bcarbone24/freyja/kicad/odin.kicad_pcb

## KiCad design kicad/odin.kicad_pcb (2026-11-05)

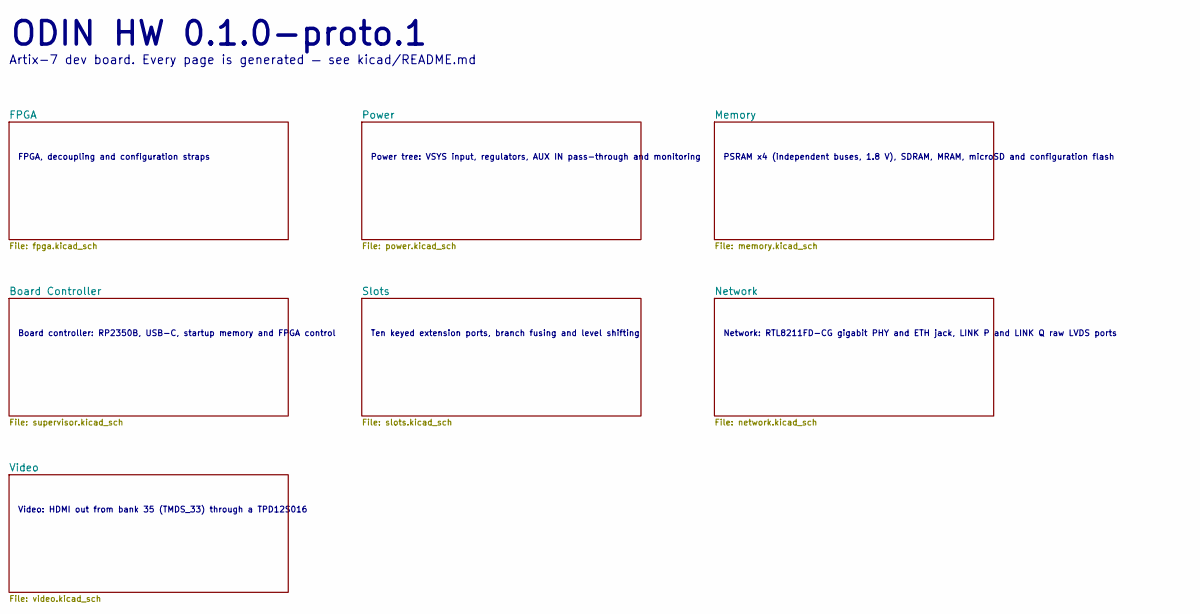
[picture p1: schematic odin.kicad_sch]

Notes on the sheet:
ODIN HW 0.1.0-proto.1
Artix-7 dev board. Every page is generated — see kicad/README.md
FPGA, decoupling and configuration straps
Power tree: VSYS input, regulators, AUX IN pass-through and monitoring
PSRAM x4 (independent buses, 1.8 V), SDRAM, MRAM, microSD and configuration flash
Board controller: RP2350B, USB-C, startup memory and FPGA control
Ten keyed extension ports, branch fusing and level shifting
Network: RTL8211FD-CG gigabit PHY and ETH jack, LINK P and LINK Q raw LVDS ports
Video: HDMI out from bank 35 (TMDS_33) through a TPD12S016

Schematic: fpga.kicad_sch

Parts:
C246, C328, C370, C371, C372, C373, C374, C375, C376, C377, C378, C379, C380, C381, C382, C383, C384, C385, C386, C387, C388, C389, C390, C391: 100nF; C_0402_1005Metric; LCSC C1525
C301: 330uF 2.5V T520V337M2R5ATE025; CP_EIA-7343-31_Kemet-D
C302, C303, C304, C305, C306, C307, C320, C321, C322, C330, C331, C336, C337, C342, C343, C348, C349, C354, C355, C360, C361: 4.7uF 6.3V; C_0805_2012Metric
C308, C309, C310, C311, C312, C313, C314, C315, C317, C318, C323, C324, C325, C326, C327, C332, C333, C334, C335, C338, C339, C340, C341, C344, C345, C346, C347, C350, C351, C352, C353, C356, C357, C358, C359, C362, C363, C364, C365: 0.47uF 6.3V; C_0603_1608Metric
C316: 100uF 2.5V; C_1210_3225Metric
C319, C329, C366, C367, C368, C369, C394: 47uF 6.3V; C_1210_3225Metric
C392, C393: 4.7uF; C_0603_1608Metric; LCSC C277476
D1: F.0603.00025/P2-0603G1TS2-06T-002; LED0603-RD_GREEN; LCSC C7496818
Q4: BSS138LT1G; SOT-23-3_L2.9-W1.6-P1.90-LS2.8-BR; LCSC C82045
R1, R2, R3, R6: 1k; R_0402_1005Metric; LCSC C11702
R4, R5, R98, R203: 4.7k; R_0402_1005Metric; LCSC C25900
R7: 330; R_0402_1005Metric
R35, R89: 100 1%; R_0603_1608Metric
R147: 33; R_0402_1005Metric; LCSC C25105
U1: XC7A100T-2FGG676I; FBGA-676_L27.0-W27.0-R26-C26-P1.00-BL; LCSC C1521803
X4: 50MHz CMOS; OSC-SMD_4P-L3.2-W2.5-BL; LCSC C717684

Connections:
+1V0: C301.1, C302.1, C303.1, C304.1, C305.1, C306.1, C307.1, C308.1, C309.1, C310.1, C311.1, C312.1, C313.1, C314.1, C315.1, C316.1, C317.1, C318.1, U1.J11 (VCCINT), U1.J13 (VCCINT), U1.K10 (VCCINT), U1.K12 (VCCINT), U1.L11 (VCCINT), U1.L13 (VCCINT), U1.M10 (VCCINT), U1.N13 (VCCBRAM), U1.P10 (VCCINT), U1.R13 (VCCBRAM), U1.T10 (VCCINT), U1.T12 (VCCINT), U1.U11 (VCCINT), U1.U13 (VCCBRAM), U1.V10 (VCCINT), U1.V12 (VCCINT), U1.W13 (VCCBRAM); also elsewhere on the board
+1V0_MGT: C370.1, C371.1, C372.1, C373.1, C374.1, C375.1, C376.1, C377.1, C378.1, C379.1, C392.1, U1.AA10 (MGTAVCC_G10), U1.AA12 (MGTAVCC_G10), U1.AC9 (MGTAVCC_G10), U1.AC11 (MGTAVCC_G10), U1.AC13 (MGTAVCC_G10), U1.D9 (MGTAVCC_G11), U1.D11 (MGTAVCC_G11), U1.D13 (MGTAVCC_G11), U1.F10 (MGTAVCC_G11), U1.F12 (MGTAVCC_G11); also elsewhere on the board
+1V2_MGT: C380.1, C381.1, C382.1, C383.1, C384.1, C385.1, C386.1, C387.1, C388.1, C389.1, C390.1, C391.1, C393.1, R35.2, R89.2, U1.AD7 (MGTAVTT_G10), U1.AD15 (MGTAVTT_G10), U1.AE8 (MGTAVTT_G10), U1.AE10 (MGTAVTT_G10), U1.AE12 (MGTAVTT_G10), U1.AE14 (MGTAVTT_G10), U1.B8 (MGTAVTT_G11), U1.B10 (MGTAVTT_G11), U1.B12 (MGTAVTT_G11), U1.B14 (MGTAVTT_G11), U1.C7 (MGTAVTT_G11), U1.C15 (MGTAVTT_G11); also elsewhere on the board
+1V8: C319.1, C320.1, C321.1, C322.1, C323.1, C324.1, C325.1, C326.1, C327.1, C328.1, U1.J9 (VCCAUX), U1.L9 (VCCAUX), U1.M12 (VCCADC_0), U1.N9 (VCCAUX), U1.R9 (VCCAUX), U1.U9 (VCCAUX); also elsewhere on the board
+1V8_IO: C330.1, C331.1, C332.1, C333.1, C334.1, C335.1, C394.1, U1.AC25 (VCCO_13), U1.T16 (VCCO_13), U1.T26 (VCCO_13), U1.U23 (VCCO_13), U1.V20 (VCCO_13), U1.Y24 (VCCO_13); also elsewhere on the board
+2V5: C348.1, C349.1, C350.1, C351.1, C352.1, C353.1, C368.1, U1.A21 (VCCO_16), U1.B18 (VCCO_16), U1.C25 (VCCO_16), U1.D22 (VCCO_16), U1.E19 (VCCO_16), U1.F16 (VCCO_16); also elsewhere on the board
+3V3: C246.1, C329.1, C336.1, C337.1, C338.1, C339.1, C340.1, C341.1, C360.1, C361.1, C362.1, C363.1, C364.1, C365.1, C366.1, R1.1, R4.1, R5.1, R6.1, R7.1, R98.1, R203.1, U1.A1 (VCCO_35), U1.AA1 (VCCO_33), U1.AA21 (VCCO_12), U1.AB15 (CFGBVS_0), U1.AB18 (VCCO_12), U1.AC5 (VCCO_33), U1.AD2 (VCCO_33), U1.AD22 (VCCO_12), U1.AE19 (VCCO_12), U1.AF26 (VCCO_12), U1.C5 (VCCO_35), U1.D2 (VCCO_35), U1.F6 (VCCO_35), U1.G3 (VCCO_35), U1.J7 (VCCO_35), U1.K24 (VCCO_14), U1.L21 (VCCO_14), U1.N15 (VCCO_14), U1.N25 (VCCO_14), U1.P22 (VCCO_14), U1.R19 (VCCO_14), U1.U3 (VCCO_33), U1.W7 (VCCO_33), U1.W11 (VCCO_0), U1.W17 (VCCO_12), U1.Y4 (VCCO_33), U1.Y14 (VCCO_0), X4.1 (Tri-state), X4.4 (VDD); also elsewhere on the board
BUS5V0_DIR: U1.U24 (IO_0_13); also elsewhere on the board
BUS5V0_IO0: U1.V26 (IO_L2P_T0_13); also elsewhere on the board
BUS5V0_IO1: U1.W26 (IO_L2N_T0_13); also elsewhere on the board
BUS5V0_IO2: U1.AB26 (IO_L3P_T0_DQS_13); also elsewhere on the board
BUS5V0_IO3: U1.AC26 (IO_L3N_T0_DQS_13); also elsewhere on the board
BUS5V0_IO4: U1.U25 (IO_L1P_T0_13); also elsewhere on the board
BUS5V0_IO5: U1.U26 (IO_L1N_T0_13); also elsewhere on the board
BUS5V0_IO6: U1.W25 (IO_L4P_T0_13); also elsewhere on the board
BUS5V0_IO7: U1.Y26 (IO_L4N_T0_13); also elsewhere on the board
BUS5V0_OE_N: U1.V23 (IO_L10P_T1_13); also elsewhere on the board
BUS5V1_DIR: U1.U17 (IO_25_13); also elsewhere on the board
BUS5V1_IO0: U1.Y25 (IO_L5P_T0_13); also elsewhere on the board
BUS5V1_IO1: U1.AA25 (IO_L5N_T0_13); also elsewhere on the board
BUS5V1_IO2: U1.V24 (IO_L6P_T0_13); also elsewhere on the board
BUS5V1_IO3: U1.W24 (IO_L6N_T0_VREF_13); also elsewhere on the board
BUS5V1_IO4: U1.AA24 (IO_L7P_T1_13); also elsewhere on the board
BUS5V1_IO5: U1.AB25 (IO_L7N_T1_13); also elsewhere on the board
BUS5V1_IO6: U1.AB24 (IO_L9P_T1_DQS_13); also elsewhere on the board
BUS5V1_IO7: U1.AC24 (IO_L9N_T1_DQS_13); also elsewhere on the board
BUS5V1_OE_N: U1.W23 (IO_L10N_T1_13); also elsewhere on the board
CFG_CCLK: U1.H13 (CCLK_0); also elsewhere on the board
CFG_DONE: Q4.1 (G), R98.2, U1.W10 (DONE_0); also elsewhere on the board
CFG_INIT_B: R5.2, U1.V11 (INIT_B_0); also elsewhere on the board
CFG_M0: R1.2, U1.AB7 (M0_0)
CFG_M1: R2.1, U1.Y9 (M1_0)
CFG_M2: R3.1, U1.W9 (M2_0)
CFG_PROG_B: R4.2, U1.AE16 (PROGRAM_B_0); also elsewhere on the board
DBG_TCK: U1.N21 (IO_L13P_T2_MRCC_14); also elsewhere on the board
DBG_TDI: U1.M20 (IO_L8P_T1_D11_14); also elsewhere on the board
DBG_TDO: U1.L20 (IO_L8N_T1_D12_14); also elsewhere on the board
DBG_TMS: U1.N22 (IO_L13N_T2_MRCC_14); also elsewhere on the board
DONE_LED_A: D1.2 (A), R7.2
DONE_LED_K: D1.1 (C), Q4.3 (D)
FLASH_CS_B: R203.2, U1.P18 (IO_L6P_T0_FCS_B_14); also elsewhere on the board
FLASH_D0_MOSI: U1.R14 (IO_L1P_T0_D00_MOSI_14); also elsewhere on the board
FLASH_D1_MISO: U1.R15 (IO_L1N_T0_D01_DIN_14); also elsewhere on the board
FLASH_D2_WP: U1.P14 (IO_L2P_T0_D02_14); also elsewhere on the board
FLASH_D3_HOLD: U1.N14 (IO_L2N_T0_D03_14); also elsewhere on the board
FPGA_DXN: U1.R11 (DXN_0)
FPGA_DXP: U1.R12 (DXP_0)
GND: C246.2, C301.2, C302.2, C303.2, C304.2, C305.2, C306.2, C307.2, C308.2, C309.2, C310.2, C311.2, C312.2, C313.2, C314.2, C315.2, C316.2, C317.2, C318.2, C319.2, C320.2, C321.2, C322.2, C323.2, C324.2, C325.2, C326.2, C327.2, C328.2, C329.2, C330.2, C331.2, C332.2, C333.2, C334.2, C335.2, C336.2, C337.2, C338.2, C339.2, C340.2, C341.2, C342.2, C343.2, C344.2, C345.2, C346.2, C347.2, C348.2, C349.2, C350.2, C351.2, C352.2, C353.2, C354.2, C355.2, C356.2, C357.2, C358.2, C359.2, C360.2, C361.2, C362.2, C363.2, C364.2, C365.2, C366.2, C367.2, C368.2, C369.2, C370.2, C371.2, C372.2, C373.2, C374.2, C375.2, C376.2, C377.2, C378.2, C379.2, C380.2, C381.2, C382.2, C383.2, C384.2, C385.2, C386.2, C387.2, C388.2, C389.2, C390.2, C391.2, C392.2, C393.2, C394.2, Q4.2 (S), R2.2, R3.2, U1.A6 (GND), U1.A8 (GND), U1.A10 (GND), U1.A11 (MGTPRXN0_216), U1.A12 (GND), U1.A13 (MGTPRXN2_216), U1.A14 (GND), U1.A16 (GND), U1.A26 (GND), U1.AA6 (GND), U1.AA9 (GND), U1.AA14 (GND), U1.AA16 (GND), U1.AA26 (GND), U1.AB3 (GND), U1.AB8 (GND), U1.AB9 (GND), U1.AB10 (GND), U1.AB12 (GND), U1.AB14 (GND), U1.AB23 (GND), U1.AC7 (GND), U1.AC12 (MGTPRXP0_213), U1.AC14 (MGTPRXP2_213), U1.AC15 (GND), U1.AC20 (GND), U1.AD6 (GND), U1.AD9 (GND), U1.AD11 (GND), U1.AD12 (MGTPRXN0_213), U1.AD13 (GND), U1.AD14 (MGTPRXN2_213), U1.AD16 (GND), U1.AE4 (GND), U1.AE6 (GND), U1.AE11 (MGTPRXP3_213), U1.AE13 (MGTPRXP1_213), U1.AE15 (GND), U1.AE24 (GND), U1.AF1 (GND), U1.AF6 (GND), U1.AF8 (GND), U1.AF10 (GND), U1.AF11 (MGTPRXN3_213), U1.AF12 (GND), U1.AF13 (MGTPRXN1_213), U1.AF14 (GND), U1.AF16 (GND), U1.AF21 (GND), U1.B3 (GND), U1.B6 (GND), U1.B11 (MGTPRXP0_216), U1.B13 (MGTPRXP2_216), U1.B15 (GND), U1.B16 (GND), U1.B23 (GND), U1.C6 (GND), U1.C9 (GND), U1.C11 (GND), U1.C12 (MGTPRXN3_216), U1.C13 (GND), U1.C14 (MGTPRXN1_216), U1.C16 (GND), U1.C20 (GND), U1.D7 (GND), U1.D12 (MGTPRXP3_216), U1.D14 (MGTPRXP1_216), U1.D15 (GND), U1.D17 (GND), U1.E4 (GND), U1.E7 (GND), U1.E8 (GND), U1.E9 (GND), U1.E10 (GND), U1.E12 (GND), U1.E14 (GND), U1.E15 (GND), U1.E24 (GND), U1.F1 (GND), U1.F9 (GND), U1.F14 (GND), U1.F21 (GND), U1.G10 (GND), U1.G11 (GND), U1.G12 (GND), U1.G13 (GND), U1.G14 (VCCBATT_0), U1.G18 (GND), U1.H5 (GND), U1.H25 (GND), U1.J2 (GND), U1.J12 (GND), U1.J22 (GND), U1.K9 (GND), U1.K11 (GND), U1.K13 (GND), U1.K19 (GND), U1.L6 (GND), U1.L10 (GND), U1.L12 (GND), U1.L16 (GND), U1.L26 (GND), U1.M3 (GND), U1.M9 (GND), U1.M11 (GNDADC_0), U1.M13 (GND), U1.M23 (GND), U1.N10 (GND), U1.N11 (VREFN_0), U1.N12 (VP_0), U1.N20 (GND), U1.P7 (GND), U1.P9 (GND), U1.P11 (VN_0), U1.P12 (VREFP_0), U1.P13 (GND), U1.P17 (GND), U1.R4 (GND), U1.R10 (GND), U1.R24 (GND), U1.T1 (GND), U1.T9 (GND), U1.T11 (GND), U1.T13 (GND), U1.T21 (GND), U1.U8 (GND), U1.U10 (GND), U1.U12 (GND), U1.U18 (GND), U1.V5 (GND), U1.V13 (GND), U1.V15 (GND), U1.V25 (GND), U1.W2 (GND), U1.W12 (GND), U1.W22 (GND), U1.Y10 (GND), U1.Y11 (GND), U1.Y12 (GND), U1.Y13 (GND), U1.Y19 (GND), X4.2 (GND); also elsewhere on the board
HDMI_CEC: U1.B2 (IO_L19N_T3_VREF_35); also elsewhere on the board
HDMI_CLK_N: U1.A2 (IO_L20N_T3_35); also elsewhere on the board
HDMI_CLK_P: U1.A3 (IO_L20P_T3_35); also elsewhere on the board
HDMI_CT_HPD: U1.F2 (IO_L22P_T3_35); also elsewhere on the board
HDMI_D0_N: U1.B1 (IO_L21N_T3_DQS_35); also elsewhere on the board
HDMI_D0_P: U1.C1 (IO_L21P_T3_DQS_35); also elsewhere on the board
HDMI_D1_N: U1.D1 (IO_L23N_T3_35); also elsewhere on the board
HDMI_D1_P: U1.E1 (IO_L23P_T3_35); also elsewhere on the board
HDMI_D2_N: U1.A5 (IO_L15N_T2_DQS_35); also elsewhere on the board
HDMI_D2_P: U1.B5 (IO_L15P_T2_DQS_35); also elsewhere on the board
HDMI_HPD: U1.B4 (IO_L16P_T2_35); also elsewhere on the board
HDMI_LS_OE: U1.E2 (IO_L22N_T3_35); also elsewhere on the board
HDMI_SCL: U1.A4 (IO_L16N_T2_35); also elsewhere on the board
HDMI_SDA: U1.C2 (IO_L19P_T3_35); also elsewhere on the board
JTAG_TCK: U1.H12 (TCK_0); also elsewhere on the board
JTAG_TDI: U1.H10 (TDI_0); also elsewhere on the board
JTAG_TDO: U1.J10 (TDO_0); also elsewhere on the board
JTAG_TMS: U1.H11 (TMS_0); also elsewhere on the board
LINK_P_RXC_N: U1.C18 (IO_L12N_T1_MRCC_16); also elsewhere on the board
LINK_P_RXC_P: U1.D18 (IO_L12P_T1_MRCC_16); also elsewhere on the board
LINK_P_RXD_N: U1.A18 (IO_L9N_T1_DQS_16); also elsewhere on the board
LINK_P_RXD_P: U1.A17 (IO_L9P_T1_DQS_16); also elsewhere on the board
LINK_P_TXC_N: U1.B26 (IO_L22N_T3_16); also elsewhere on the board
LINK_P_TXC_P: U1.C26 (IO_L22P_T3_16); also elsewhere on the board
LINK_P_TXD_N: U1.A24 (IO_L21N_T3_DQS_16); also elsewhere on the board
LINK_P_TXD_P: U1.A23 (IO_L21P_T3_DQS_16); also elsewhere on the board
LINK_Q_RXC_N: U1.D20 (IO_L14N_T2_SRCC_16); also elsewhere on the board
LINK_Q_RXC_P: U1.E20 (IO_L14P_T2_SRCC_16); also elsewhere on the board
LINK_Q_RXD_N: U1.A20 (IO_L15N_T2_DQS_16); also elsewhere on the board
LINK_Q_RXD_P: U1.B20 (IO_L15P_T2_DQS_16); also elsewhere on the board
LINK_Q_TXC_N: U1.A25 (IO_L20N_T3_16); also elsewhere on the board
LINK_Q_TXC_P: U1.B25 (IO_L20P_T3_16); also elsewhere on the board
LINK_Q_TXD_N: U1.A22 (IO_L17N_T2_16); also elsewhere on the board
LINK_Q_TXD_P: U1.B22 (IO_L17P_T2_16); also elsewhere on the board
MGTRREF: R35.1, U1.A15 (MGTRREF_216)
MGTRREF_213: R89.1, U1.AF15 (MGTRREF_213)
MRAM_CS: U1.K25 (IO_L7P_T1_D09_14); also elsewhere on the board
MRAM_SCK: U1.K26 (IO_L7N_T1_D10_14); also elsewhere on the board
MRAM_SI: U1.L24 (IO_L9P_T1_DQS_14); also elsewhere on the board
MRAM_SO: U1.L25 (IO_L9N_T1_DQS_D13_14); also elsewhere on the board
PHY_INT_N: U1.G2 (IO_L24P_T3_35); also elsewhere on the board
PHY_MDC: U1.C17 (IO_L7P_T1_16); also elsewhere on the board
PHY_MDIO: U1.B17 (IO_L7N_T1_16); also elsewhere on the board
PHY_RESET_N: U1.G1 (IO_L24N_T3_35); also elsewhere on the board
PHY_RXC: U1.D19 (IO_L13P_T2_MRCC_16); also elsewhere on the board
PHY_RXD0: U1.C19 (IO_L13N_T2_MRCC_16); also elsewhere on the board
PHY_RXD1: U1.H17 (IO_0_16); also elsewhere on the board
PHY_RXD2: U1.E22 (IO_25_16); also elsewhere on the board
PHY_RXD3: U1.B19 (IO_L10P_T1_16); also elsewhere on the board
PHY_RX_CTL: U1.A19 (IO_L10N_T1_16); also elsewhere on the board
PHY_TXC: U1.C24 (IO_L23P_T3_16); also elsewhere on the board
PHY_TXD0: U1.B24 (IO_L23N_T3_16); also elsewhere on the board
PHY_TXD1: U1.C22 (IO_L19P_T3_16); also elsewhere on the board
PHY_TXD2: U1.C23 (IO_L19N_T3_VREF_16); also elsewhere on the board
PHY_TXD3: U1.C21 (IO_L16P_T2_16); also elsewhere on the board
PHY_TX_CTL: U1.B21 (IO_L16N_T2_16); also elsewhere on the board
PSRAM0_CE_B: U1.T15 (IO_L20N_T3_13); also elsewhere on the board
PSRAM0_IO0: U1.T17 (IO_L21P_T3_DQS_13); also elsewhere on the board
PSRAM0_IO1: U1.T18 (IO_L21N_T3_DQS_13); also elsewhere on the board
PSRAM0_IO2: U1.U15 (IO_L22P_T3_13); also elsewhere on the board
PSRAM0_IO3: U1.U16 (IO_L22N_T3_13); also elsewhere on the board
PSRAM0_SCK: U1.T14 (IO_L20P_T3_13); also elsewhere on the board
PSRAM1_CE_B: U1.V14 (IO_L23N_T3_13); also elsewhere on the board
PSRAM1_IO0: U1.V16 (IO_L24P_T3_13); also elsewhere on the board
PSRAM1_IO1: U1.V17 (IO_L24N_T3_13); also elsewhere on the board
PSRAM1_IO2: U1.V18 (IO_L19P_T3_13); also elsewhere on the board
PSRAM1_IO3: U1.W18 (IO_L19N_T3_VREF_13); also elsewhere on the board
PSRAM1_SCK: U1.U14 (IO_L23P_T3_13); also elsewhere on the board
PSRAM2_CE_B: U1.U19 (IO_L17N_T2_13); also elsewhere on the board
PSRAM2_IO0: U1.V19 (IO_L18P_T2_13); also elsewhere on the board
PSRAM2_IO1: U1.W19 (IO_L18N_T2_13); also elsewhere on the board
PSRAM2_IO2: U1.T20 (IO_L15P_T2_DQS_13); also elsewhere on the board
PSRAM2_IO3: U1.U20 (IO_L15N_T2_DQS_13); also elsewhere on the board
PSRAM2_SCK: U1.T19 (IO_L17P_T2_13); also elsewhere on the board
PSRAM3_CE_B: U1.Y20 (IO_L16N_T2_13); also elsewhere on the board
PSRAM3_IO0: U1.W21 (IO_L14P_T2_SRCC_13); also elsewhere on the board
PSRAM3_IO1: U1.Y21 (IO_L14N_T2_SRCC_13); also elsewhere on the board
PSRAM3_IO2: U1.Y22 (IO_L11P_T1_SRCC_13); also elsewhere on the board
PSRAM3_IO3: U1.Y23 (IO_L11N_T1_SRCC_13); also elsewhere on the board
PSRAM3_SCK: U1.W20 (IO_L16P_T2_13); also elsewhere on the board
PUDC_B: R6.2, U1.P15 (IO_L3P_T0_DQS_PUDC_B_14)
SB_UART_RX: U1.P20 (IO_L14P_T2_SRCC_14); also elsewhere on the board
SB_UART_TX: U1.P21 (IO_L14N_T2_SRCC_14); also elsewhere on the board
SDRAM_A0: U1.M26 (IO_L20N_T3_A07_D23_14); also elsewhere on the board
SDRAM_A1: U1.N26 (IO_L20P_T3_A08_D24_14); also elsewhere on the board
SDRAM_A2: U1.P26 (IO_L22N_T3_A04_D20_14); also elsewhere on the board
SDRAM_A3: U1.R26 (IO_L22P_T3_A05_D21_14); also elsewhere on the board
SDRAM_A4: U1.M25 (IO_L10N_T1_D15_14); also elsewhere on the board
SDRAM_A5: U1.P25 (IO_L19N_T3_A09_D25_VREF_14); also elsewhere on the board
SDRAM_A6: U1.R25 (IO_L19P_T3_A10_D26_14); also elsewhere on the board
SDRAM_A7: U1.T25 (IO_L21N_T3_DQS_A06_D22_14); also elsewhere on the board
SDRAM_A8: U1.M24 (IO_L10P_T1_D14_14); also elsewhere on the board
SDRAM_A9: U1.N24 (IO_L15N_T2_DQS_DOUT_CSO_B_14); also elsewhere on the board
SDRAM_A10: U1.P24 (IO_L17N_T2_A13_D29_14); also elsewhere on the board
SDRAM_A11: U1.T24 (IO_L21P_T3_DQS_14); also elsewhere on the board
SDRAM_A12: U1.N23 (IO_L15P_T2_DQS_RDWR_B_14); also elsewhere on the board
SDRAM_BA0: U1.P23 (IO_L17P_T2_A14_D30_14); also elsewhere on the board
SDRAM_BA1: U1.R23 (IO_L24N_T3_A00_D16_14); also elsewhere on the board
SDRAM_CAS_N: U1.F3 (IO_L18P_T2_35); also elsewhere on the board
SDRAM_CKE: U1.K6 (IO_L10N_T1_AD15N_35); also elsewhere on the board
SDRAM_CLK: U1.K7 (IO_L10P_T1_AD15P_35); also elsewhere on the board
SDRAM_CS_N: U1.D3 (IO_L17P_T2_35); also elsewhere on the board
SDRAM_DQ0: U1.E6 (IO_L1P_T0_AD4P_35); also elsewhere on the board
SDRAM_DQ1: U1.D6 (IO_L1N_T0_AD4N_35); also elsewhere on the board
SDRAM_DQ2: U1.H8 (IO_L2P_T0_AD12P_35); also elsewhere on the board
SDRAM_DQ3: U1.G8 (IO_L2N_T0_AD12N_35); also elsewhere on the board
SDRAM_DQ4: U1.H7 (IO_L3P_T0_DQS_AD5P_35); also elsewhere on the board
SDRAM_DQ5: U1.G7 (IO_L3N_T0_DQS_AD5N_35); also elsewhere on the board
SDRAM_DQ6: U1.F8 (IO_L4P_T0_35); also elsewhere on the board
SDRAM_DQ7: U1.F7 (IO_L4N_T0_35); also elsewhere on the board
SDRAM_DQ8: U1.H6 (IO_L5P_T0_AD13P_35); also elsewhere on the board
SDRAM_DQ9: U1.G6 (IO_L5N_T0_AD13N_35); also elsewhere on the board
SDRAM_DQ10: U1.H9 (IO_L6P_T0_35); also elsewhere on the board
SDRAM_DQ11: U1.G9 (IO_L6N_T0_VREF_35); also elsewhere on the board
SDRAM_DQ12: U1.J6 (IO_L7P_T1_AD6P_35); also elsewhere on the board
SDRAM_DQ13: U1.J5 (IO_L7N_T1_AD6N_35); also elsewhere on the board
SDRAM_DQ14: U1.L8 (IO_L8P_T1_AD14P_35); also elsewhere on the board
SDRAM_DQ15: U1.K8 (IO_L8N_T1_AD14N_35); also elsewhere on the board
SDRAM_LDQM: U1.J4 (IO_L9P_T1_DQS_AD7P_35); also elsewhere on the board
SDRAM_RAS_N: U1.C3 (IO_L17N_T2_35); also elsewhere on the board
SDRAM_UDQM: U1.H4 (IO_L9N_T1_DQS_AD7N_35); also elsewhere on the board
SDRAM_WE_N: U1.E3 (IO_L18N_T2_35); also elsewhere on the board
SD_CD: U1.T23 (IO_L24P_T3_A01_D17_14); also elsewhere on the board
SD_CS: U1.L22 (IO_L11P_T1_SRCC_14); also elsewhere on the board
SD_MISO: U1.R22 (IO_L23N_T3_A02_D18_14); also elsewhere on the board
SD_MOSI: U1.T22 (IO_L23P_T3_A03_D19_14); also elsewhere on the board
SD_SCK: U1.L23 (IO_L11N_T1_SRCC_14); also elsewhere on the board
SLOTA_IO0: U1.K15 (IO_L1P_T0_AD0P_15); also elsewhere on the board
SLOTA_IO1: U1.J16 (IO_L1N_T0_AD0N_15); also elsewhere on the board
SLOTA_IO2: U1.J14 (IO_L2P_T0_AD8P_15); also elsewhere on the board
SLOTA_IO3: U1.J15 (IO_L2N_T0_AD8N_15); also elsewhere on the board
SLOTA_IO4: U1.K16 (IO_L3P_T0_DQS_AD1P_15); also elsewhere on the board
SLOTA_IO5: U1.K17 (IO_L3N_T0_DQS_AD1N_15); also elsewhere on the board
SLOTA_IO6: U1.M14 (IO_L4P_T0_15); also elsewhere on the board
SLOTA_IO7: U1.L14 (IO_L4N_T0_15); also elsewhere on the board
SLOTA_IO8: U1.M15 (IO_L5P_T0_AD9P_15); also elsewhere on the board
SLOTA_IO9: U1.L15 (IO_L5N_T0_AD9N_15); also elsewhere on the board
SLOTA_IO10: U1.M16 (IO_L6P_T0_15); also elsewhere on the board
SLOTA_IO11: U1.M17 (IO_L6N_T0_VREF_15); also elsewhere on the board
SLOTB_IO0: U1.J19 (IO_L7P_T1_AD2P_15); also elsewhere on the board
SLOTB_IO1: U1.H19 (IO_L7N_T1_AD2N_15); also elsewhere on the board
SLOTB_IO2: U1.L17 (IO_L8P_T1_AD10P_15); also elsewhere on the board
SLOTB_IO3: U1.L18 (IO_L8N_T1_AD10N_15); also elsewhere on the board
SLOTB_IO4: U1.K20 (IO_L9P_T1_DQS_AD3P_15); also elsewhere on the board
SLOTB_IO5: U1.J20 (IO_L9N_T1_DQS_AD3N_15); also elsewhere on the board
SLOTB_IO6: U1.J18 (IO_L10P_T1_AD11P_15); also elsewhere on the board
SLOTB_IO7: U1.H18 (IO_L10N_T1_AD11N_15); also elsewhere on the board
SLOTB_IO8: U1.G20 (IO_L11P_T1_SRCC_15); also elsewhere on the board
SLOTB_IO9: U1.G21 (IO_L11N_T1_SRCC_15); also elsewhere on the board
SLOTB_IO10: U1.K21 (IO_L12P_T1_MRCC_15); also elsewhere on the board
SLOTB_IO11: U1.J21 (IO_L12N_T1_MRCC_15); also elsewhere on the board
SLOTC_IO0: U1.H21 (IO_L13P_T2_MRCC_15); also elsewhere on the board
SLOTC_IO1: U1.H22 (IO_L13N_T2_MRCC_15); also elsewhere on the board
SLOTC_IO2: U1.J23 (IO_L14P_T2_SRCC_15); also elsewhere on the board
SLOTC_IO3: U1.H23 (IO_L14N_T2_SRCC_15); also elsewhere on the board
SLOTC_IO4: U1.G22 (IO_L15P_T2_DQS_15); also elsewhere on the board
SLOTC_IO5: U1.F22 (IO_L15N_T2_DQS_ADV_B_15); also elsewhere on the board
SLOTC_IO6: U1.J24 (IO_L16P_T2_A28_15); also elsewhere on the board
SLOTC_IO7: U1.H24 (IO_L16N_T2_A27_15); also elsewhere on the board
SLOTC_IO8: U1.F23 (IO_L17P_T2_A26_15); also elsewhere on the board
SLOTC_IO9: U1.E23 (IO_L17N_T2_A25_15); also elsewhere on the board
SLOTC_IO10: U1.K22 (IO_L18P_T2_A24_15); also elsewhere on the board
SLOTC_IO11: U1.K23 (IO_L18N_T2_A23_15); also elsewhere on the board
SLOTD_IO0: U1.G24 (IO_L19P_T3_A22_15); also elsewhere on the board
SLOTD_IO1: U1.F24 (IO_L19N_T3_A21_VREF_15); also elsewhere on the board
SLOTD_IO2: U1.E25 (IO_L20P_T3_A20_15); also elsewhere on the board
SLOTD_IO3: U1.D25 (IO_L20N_T3_A19_15); also elsewhere on the board
SLOTD_IO4: U1.E26 (IO_L21P_T3_DQS_15); also elsewhere on the board
SLOTD_IO5: U1.D26 (IO_L21N_T3_DQS_A18_15); also elsewhere on the board
SLOTD_IO6: U1.H26 (IO_L22P_T3_A17_15); also elsewhere on the board
SLOTD_IO7: U1.G26 (IO_L22N_T3_A16_15); also elsewhere on the board
SLOTD_IO8: U1.G25 (IO_L23P_T3_FOE_B_15); also elsewhere on the board
SLOTD_IO9: U1.F25 (IO_L23N_T3_FWE_B_15); also elsewhere on the board
SLOTD_IO10: U1.J25 (IO_L24P_T3_RS1_15); also elsewhere on the board
SLOTD_IO11: U1.J26 (IO_L24N_T3_RS0_15); also elsewhere on the board
SLOTE_IO0: U1.K3 (IO_L1P_T0_34); also elsewhere on the board
SLOTE_IO1: U1.J3 (IO_L1N_T0_34); also elsewhere on the board
SLOTE_IO2: U1.M7 (IO_L2P_T0_34); also elsewhere on the board
SLOTE_IO3: U1.L7 (IO_L2N_T0_34); also elsewhere on the board
SLOTE_IO4: U1.M4 (IO_L3P_T0_DQS_34); also elsewhere on the board
SLOTE_IO5: U1.L4 (IO_L3N_T0_DQS_34); also elsewhere on the board
SLOTE_IO6: U1.L5 (IO_L4P_T0_34); also elsewhere on the board
SLOTE_IO7: U1.K5 (IO_L4N_T0_34); also elsewhere on the board
SLOTE_IO8: U1.N7 (IO_L5P_T0_34); also elsewhere on the board
SLOTE_IO9: U1.N6 (IO_L5N_T0_34); also elsewhere on the board
SLOTE_IO10: U1.M6 (IO_L6P_T0_34); also elsewhere on the board
SLOTE_IO11: U1.M5 (IO_L6N_T0_VREF_34); also elsewhere on the board
SLOTF_IO0: U1.K1 (IO_L7P_T1_34); also elsewhere on the board
SLOTF_IO1: U1.J1 (IO_L7N_T1_34); also elsewhere on the board
SLOTF_IO2: U1.L3 (IO_L8P_T1_34); also elsewhere on the board
SLOTF_IO3: U1.K2 (IO_L8N_T1_34); also elsewhere on the board
SLOTF_IO4: U1.N1 (IO_L9P_T1_DQS_34); also elsewhere on the board
SLOTF_IO5: U1.M1 (IO_L9N_T1_DQS_34); also elsewhere on the board
SLOTF_IO6: U1.H2 (IO_L10P_T1_34); also elsewhere on the board
SLOTF_IO7: U1.H1 (IO_L10N_T1_34); also elsewhere on the board
SLOTF_IO8: U1.M2 (IO_L11P_T1_SRCC_34); also elsewhere on the board
SLOTF_IO9: U1.L2 (IO_L11N_T1_SRCC_34); also elsewhere on the board
SLOTF_IO10: U1.N3 (IO_L12P_T1_MRCC_34); also elsewhere on the board
SLOTF_IO11: U1.N2 (IO_L12N_T1_MRCC_34); also elsewhere on the board
SLOTG_IO0: U1.R3 (IO_L13P_T2_MRCC_34); also elsewhere on the board
SLOTG_IO1: U1.P3 (IO_L13N_T2_MRCC_34); also elsewhere on the board
SLOTG_IO2: U1.P4 (IO_L14P_T2_SRCC_34); also elsewhere on the board
SLOTG_IO3: U1.N4 (IO_L14N_T2_SRCC_34); also elsewhere on the board
SLOTG_IO4: U1.R1 (IO_L15P_T2_DQS_34); also elsewhere on the board
SLOTG_IO5: U1.P1 (IO_L15N_T2_DQS_34); also elsewhere on the board
SLOTG_IO6: U1.T4 (IO_L16P_T2_34); also elsewhere on the board
SLOTG_IO7: U1.T3 (IO_L16N_T2_34); also elsewhere on the board
SLOTG_IO8: U1.T2 (IO_L17P_T2_34); also elsewhere on the board
SLOTG_IO9: U1.R2 (IO_L17N_T2_34); also elsewhere on the board
SLOTG_IO10: U1.U2 (IO_L18P_T2_34); also elsewhere on the board
SLOTG_IO11: U1.U1 (IO_L18N_T2_34); also elsewhere on the board
SLOTH_IO0: U1.P6 (IO_L19P_T3_34); also elsewhere on the board
SLOTH_IO1: U1.P5 (IO_L19N_T3_VREF_34); also elsewhere on the board
SLOTH_IO2: U1.T5 (IO_L20P_T3_34); also elsewhere on the board
SLOTH_IO3: U1.R5 (IO_L20N_T3_34); also elsewhere on the board
SLOTH_IO4: U1.U6 (IO_L21P_T3_DQS_34); also elsewhere on the board
SLOTH_IO5: U1.U5 (IO_L21N_T3_DQS_34); also elsewhere on the board
SLOTH_IO6: U1.R8 (IO_L22P_T3_34); also elsewhere on the board
SLOTH_IO7: U1.P8 (IO_L22N_T3_34); also elsewhere on the board
SLOTH_IO8: U1.R7 (IO_L23P_T3_34); also elsewhere on the board
SLOTH_IO9: U1.R6 (IO_L23N_T3_34); also elsewhere on the board
SLOTH_IO10: U1.T8 (IO_L24P_T3_34); also elsewhere on the board
SLOTH_IO11: U1.T7 (IO_L24N_T3_34); also elsewhere on the board
SYS_CLK: R147.2, U1.M21 (IO_L12P_T1_MRCC_14)
SYS_CLK_OSC: R147.1, X4.3 (OUTPUT)
VCCIO_1: C342.1, C343.1, C344.1, C345.1, C346.1, C347.1, C367.1, U1.F26 (VCCO_15), U1.G23 (VCCO_15), U1.H20 (VCCO_15), U1.J17 (VCCO_15), U1.K14 (VCCO_15), U1.M18 (VCCO_15); also elsewhere on the board
VCCIO_2: C354.1, C355.1, C356.1, C357.1, C358.1, C359.1, C369.1, U1.K4 (VCCO_34), U1.L1 (VCCO_34), U1.M8 (VCCO_34), U1.N5 (VCCO_34), U1.P2 (VCCO_34), U1.T6 (VCCO_34); also elsewhere on the board

Notes on the sheet:
FPGA — FPGA, decoupling and configuration straps — HW 0.1.0-proto.1
U1 FPGA
The FPGA is the board: every user design (a NEORV32 RISC-V core, a video pipeline, a protocol bridge) runs here. Its six user I/O banks are dedicated by job: bank 13 at 1.8 V carries the four PSRAMs and the two 5 V bus translators, bank 14 the configuration flash, the board-controller sideband, the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
decap VCCINT
Decoupling for VCCINT (+1V0), which powers the FPGA core logic; quantities from UG483 Table 2-2, row FGG676 / XC7A100T. Placement rule: ref/decoupling.md.
decap VCCBRAM
Decoupling for VCCBRAM (+1V0), which powers the FPGA block RAM; quantities from UG483 Table 2-2, row FGG676 / XC7A100T. Placement rule: ref/decoupling.md.
decap VCCAUX
Decoupling for VCCAUX (+1V8), which powers the FPGA auxiliary circuits (clocking, I/O pre-drivers); quantities from UG483 Table 2-2, row FGG676 / XC7A100T. Placement rule: ref/decoupling.md.
decap VCCADC
Decoupling for VCCADC (+1V8), which powers the FPGA's on-chip ADC (XADC); not in UG483 Table 2-2; one 100 nF bypass. Placement rule: ref/decoupling.md.
decap VCCO_0
Decoupling for VCCO_0 (+3V3), which powers configuration bank 0; quantities from UG483 Table 2-2, row FGG676 / XC7A100T. Placement rule: ref/decoupling.md.
decap VCCO_13
Decoupling for FPGA I/O bank 13's supply (VCCO): 2 x 4.7 uF and 4 x 0.47 uF, UG483 Table 2-2. They keep the bank's supply steady while its outputs switch. Placement rule: ref/decoupling.md.
decap VCCO_14
Decoupling for FPGA I/O bank 14's supply (VCCO): 2 x 4.7 uF and 4 x 0.47 uF, UG483 Table 2-2. They keep the bank's supply steady while its outputs switch. Placement rule: ref/decoupling.md.
decap VCCO_15
Decoupling for FPGA I/O bank 15's supply (VCCO): 2 x 4.7 uF and 4 x 0.47 uF, UG483 Table 2-2. They keep the bank's supply steady while its outputs switch. Placement rule: ref/decoupling.md.
decap VCCO_16
Decoupling for FPGA I/O bank 16's supply (VCCO): 2 x 4.7 uF and 4 x 0.47 uF, UG483 Table 2-2. They keep the bank's supply steady while its outputs switch. Placement rule: ref/decoupling.md.
decap VCCO_34
Decoupling for FPGA I/O bank 34's supply (VCCO): 2 x 4.7 uF and 4 x 0.47 uF, UG483 Table 2-2. They keep the bank's supply steady while its outputs switch. Placement rule: ref/decoupling.md.
decap VCCO_35
Decoupling for FPGA I/O bank 35's supply (VCCO): 2 x 4.7 uF and 4 x 0.47 uF, UG483 Table 2-2. They keep the bank's supply steady while its outputs switch. Placement rule: ref/decoupling.md.
decap VCCO group +3V3
Bulk capacitor shared by every FPGA I/O bank powered from +3V3: UG483 Table 2-2 note 3 asks one 47 uF per group of up to four banks on one voltage. See ref/decoupling.md.
decap VCCO group VCCIO_1
Bulk capacitor shared by every FPGA I/O bank powered from VCCIO_1: UG483 Table 2-2 note 3 asks one 47 uF per group of up to four banks on one voltage. See ref/decoupling.md.
decap VCCO group +2V5
Bulk capacitor shared by every FPGA I/O bank powered from +2V5: UG483 Table 2-2 note 3 asks one 47 uF per group of up to four banks on one voltage. See ref/decoupling.md.
decap VCCO group VCCIO_2
Bulk capacitor shared by every FPGA I/O bank powered from VCCIO_2: UG483 Table 2-2 note 3 asks one 47 uF per group of up to four banks on one voltage. See ref/decoupling.md.
decap +1V0_MGT
Decoupling for +1V0_MGT (+1V0_MGT), which powers the unused but powered transceivers (MGTAVCC); the MGT supplies are UG482's, not in UG483 Table 2-2: one 100 nF per ball plus 4.7 uF. Placement rule: ref/decoupling.md.
decap +1V2_MGT
Decoupling for +1V2_MGT (+1V2_MGT), which powers the unused but powered transceivers (MGTAVTT); the MGT supplies are UG482's, not in UG483 Table 2-2: one 100 nF per ball plus 4.7 uF. Placement rule: ref/decoupling.md.
decap VCCO group +1V8_IO
Bulk capacitor shared by every FPGA I/O bank powered from +1V8_IO: UG483 Table 2-2 note 3 asks one 47 uF per group of up to four banks on one voltage. See ref/decoupling.md.
config straps (UG470)
How the FPGA loads its design at power-on. M[2:0] = 001 selects master SPI: the FPGA clocks its bitstream out of the W25Q256 flash (U6) by itself. The mode straps are 1 k, the most UG470 v1.17 Table 2-4 allows. PROGRAM_B and INIT_B are pulled up so the board controller can restart configuration; PU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
GTP calibration
The XC7A100T has two quads of multi-gigabit transceivers (GTP). Rev A uses none of them, but UG482 Tables 5-5 and 5-6 still want their supplies powered, their receive inputs grounded and one 100 ohm 1 % calibration resistor per quad to MGTAVTT. These two resistors are that.
X4 system clock
The FPGA's own clock. X4 runs at 50 MHz from power-on and enters bank 14 on a clock-capable (MRCC) ball, so it can feed an MMCM and make any frequency the design needs. Without it nothing in the fabric would run until a network link came up.
config flash
The FPGA's non-volatile memory. At power-on the FPGA reads its design (bitstream) from this 32 MB flash by itself (master SPI, set by the mode straps). The board controller can rewrite it through the series resistors on the Board Controller sheet, and spare space can hold user data or software for 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

Schematic: power.kicad_sch

Parts:
C184: 2.2nF 25V; C_0402_1005Metric
C185, C186, C192, C267: 10uF 50V; C_1210_3225Metric; LCSC C77102
C187: 10uF 25V; C_0805_2012Metric; LCSC C15850
C188, C193, C200, C203, C206, C225, C226, C227, C228, C229, C230, C262, C263, C271, C274, C277, C278: 100nF; C_0402_1005Metric; LCSC C1525
C189, C190, C191, C195, C196, C197, C198, C199, C201, C202, C204, C205, C207, C211, C212, C265, C266: 22uF; C_0805_2012Metric; LCSC C86816
C194: 56pF; C_0402_1005Metric
C208, C218, C219, C220, C221, C273, C276, C280: 1uF; C_0603_1608Metric; LCSC C29936
C209: 1nF; C_0402_1005Metric
C210: 22pF; C_0402_1005Metric
C224, C268, C269, C270: 4.7uF; C_0603_1608Metric; LCSC C277476
C261, C279: 10uF; C_0805_2012Metric; LCSC C15850
C264: 100nF 25V; C_0402_1005Metric; LCSC C1525
C272, C275: 1nF 50V; C_0402_1005Metric
D3, D4: SS34; SMA_L4.3-W2.6-LS5.2-RD; LCSC C8678
D8: SMBJ22A; D_SMB; LCSC C151920
D24: 1N4148W; D_SOD-123; LCSC C81598
FB1: 120R 2A BLM18PG121SN1D; L_0603_1608Metric; LCSC C14709
J50: 9-21V POWER IN; CONN-TH_P5.00_KF301-5.0-2P; LCSC C474881
J68: AUX IN 9-28V UNREGULATED; CONN-TH_P5.00_KF301-5.0-2P; LCSC C474881
L2, L3: 4.7uH SRN6045TA-4R7M; IND-SMD_L6.0-W6.0; LCSC C2044594
L4, L5, L6: 2.2uH SRN4018-2R2M; IND-SMD_L4.0-W4.0_SNR4018; LCSC C913207
L7: 1uH_core FTC201610S1R0MBCA; IND-SMD_L2.0-W1.6-B; LCSC C5832342
L9: 1uH VLS252010HBX-1R0M-1; IND-SMD_L2.5-W2.0-1; LCSC C88211
Q6, Q7: BSS138LT1G; SOT-23-3_L2.9-W1.6-P1.90-LS2.8-BR; LCSC C82045
R50, R55, R59, R61, R63, R64, R67, R72, R81, R83, R91, R93, R94, R162, R164, R166, R201: 100k; R_0603_1608Metric
R51, R84: 47k; R_0603_1608Metric
R52: 73.2k; R_0603_1608Metric
R53, R73, R169: 10k; R_0603_1608Metric
R54: 1.65k; R_0603_1608Metric
R56: 19.1k; R_0603_1608Metric
R57: 93.1k; R_0603_1608Metric
R58: 30.1k; R_0603_1608Metric
R60: 31.6k; R_0603_1608Metric
R62: 49.9k; R_0603_1608Metric
R65: 10; R_0603_1608Metric
R66: 100k; R_0402_1005Metric; LCSC C25741
R68: 150k; R_0603_1608Metric
R74: 1.15k; R_0603_1608Metric
R75: 2.21k; R_0603_1608Metric
R82: 16k; R_0603_1608Metric
R85, R86, R87, R88, R198, R199: 1k; R_0603_1608Metric
R163: 36.5k; R_0603_1608Metric
R165: 23.2k; R_0603_1608Metric
R167: 56.2k; R_0603_1608Metric
R168: 44.2k; R_0603_1608Metric
R200: 470k; R_0603_1608Metric
R202: 33k; R_0603_1608Metric
U11, U12: AP63300WU-7; TSOT-23-6_L2.9-W1.6-P0.95-LS2.8-BR; LCSC C2158012
U13, U14, U16: TLV62569DRLR; SOT-563_L1.6-W1.2-P0.50-LS1.6-BL; LCSC C163217
U15: SY8047QDC; TQFN-16_L3.0-W3.0-P0.50-TL-EP1.6; LCSC C3018651
U21, U22: TPS22950CDDCR; SOT-23-6_L2.9-W1.6-P0.95-LS2.8-BL_3; LCSC C7587833
U23, U24: TPS22953DSQR; Texas_DSQ0010A_WSON-10-1EP_2x2mm_P0.4mm_EP0.9x1.5mm; LCSC C2680343
U26: TPS259470ARPWR; Texas_RPU0010A_VQFN-HR-10_2x2mm_P0.5mm; LCSC C3662799
U34: TPS2121RUXR; Texas_VQFN-HR-12_2x2.5mm_P0.5mm; LCSC C485916

Connections:
+1V0: C210.1, C211.1, C212.1, L7.1, L9.2, R67.1, R88.1; also elsewhere on the board
+1V0_MGT: C224.1, L9.1; also elsewhere on the board
+1V2_MGT: C204.1, C205.1, L6.1, R63.1; also elsewhere on the board
+1V8: FB1.2, R87.1; also elsewhere on the board
+1V8_IO: C201.1, C202.1, C261.1, C262.1, FB1.1, L5.1, R61.1; also elsewhere on the board
+2V5: C198.1, C199.1, L4.1, R59.1, R86.1; also elsewhere on the board
+3V3: C194.1, C195.1, C196.1, C197.1, C219.1, C271.1, C274.1, L3.1, R57.1, R66.1, R73.1, R85.1, R166.1, R169.1, U22.2 (VIN), U23.3 (BIAS), U24.3 (BIAS); also elsewhere on the board
+3V3_EXT: U22.5 (VOUT); also elsewhere on the board
+5V: C200.1, C203.1, C206.1, C207.1, C218.1, C265.1, C266.1, C268.1, C269.1, C270.1, R65.1, R83.1, U13.3 (VIN), U14.3 (VIN), U14.5 (EN), U15.11 (PVIN), U15.12 (PVIN), U16.3 (VIN), U21.2 (VIN), U34.1 (OUT), U34.8 (OUT); also elsewhere on the board
+5V_BUCK: C189.1, C190.1, C191.1, C280.1, L2.1, R55.1, U34.2 (IN2)
+5V_EXT: U21.5 (VOUT); also elsewhere on the board
AUX_RAIL: J68.1; also elsewhere on the board
BOOT_3V3: C193.1, U12.6 (BST)
BOOT_5V: C188.1, U11.6 (BST)
CORE_1V0_GOOD: R66.2, U15.4 (PG); also elsewhere on the board
CORE_1V0_SS: C209.1, U15.9 (SS)
CORE_1V0_SVIN: C208.1, R65.2, U15.10 (SVIN)
EN_1V0: R94.1, U15.13 (EN); also elsewhere on the board
EN_1V2: R93.1, U16.5 (EN); also elsewhere on the board
EN_2V5: R91.1, U13.5 (EN); also elsewhere on the board
EXT_EN: R72.1, U21.1 (ON), U22.1 (ON), U23.4 (EN), U24.4 (EN); also elsewhere on the board
EXT_FAULT: R73.2, U21.6 (FLT), U22.6 (FLT), U26.4 (FLT); also elsewhere on the board
EXT_PRESENT: Q7.1 (G), R201.2, R202.1
FB+1V0: C210.2, R67.2, R68.1, U15.5 (FB)
FB+1V2_MGT: R63.2, R64.1, U16.1 (FB)
FB+1V8_IO: R61.2, R62.1, U14.1 (FB)
FB+2V5: R59.2, R60.1, U13.1 (FB)
FB_3V3: C194.2, R57.2, R58.1, U12.1 (FB)
FB_5V: R55.2, R56.1, U11.1 (FB)
GND: C184.2, C185.2, C186.2, C187.2, C189.2, C190.2, C191.2, C192.2, C195.2, C196.2, C197.2, C198.2, C199.2, C200.2, C201.2, C202.2, C203.2, C204.2, C205.2, C206.2, C207.2, C208.2, C209.2, C211.2, C212.2, C218.2, C219.2, C220.2, C221.2, C224.2, C225.2, C226.2, C227.2, C228.2, C229.2, C230.2, C261.2, C262.2, C263.2, C264.2, C265.2, C266.2, C267.2, C268.2, C269.2, C270.2, C271.2, C272.2, C273.2, C274.2, C275.2, C276.2, C277.2, C278.2, C279.2, C280.2, D8.2 (A), J50.2, J68.2, Q6.2 (S), Q7.2 (S), R51.2, R53.2, R54.2, R56.2, R58.2, R60.2, R62.2, R64.2, R68.2, R72.2, R74.2, R75.2, R82.2, R84.2, R91.2, R93.2, R94.2, R163.2, R165.2, R167.2, R168.2, R200.2, R202.2, U11.4 (GND), U12.4 (GND), U13.2 (GND), U14.2 (GND), U15.6 (AGND), U15.14 (PGND), U15.15 (PGND), U15.17 (EP), U16.2 (GND), U21.3 (GND), U22.3 (GND), U23.5 (GND), U23.7 (PG), U23.11 (EP), U24.5 (GND), U24.7 (PG), U24.11 (EP), U26.8 (GND), U34.4 (OV2), U34.12 (GND); also elsewhere on the board
MON_1V0: C230.1, R88.2; also elsewhere on the board
MON_1V8: C229.1, R87.2; also elsewhere on the board
MON_2V5: C228.1, R86.2; also elsewhere on the board
MON_3V3: C227.1, R85.2; also elsewhere on the board
MON_5V: C226.1, R83.2, R84.1; also elsewhere on the board
MON_VCCIO_1: C277.1, R198.2; also elsewhere on the board
MON_VCCIO_2: C278.1, R199.2; also elsewhere on the board
MON_VSYS: C225.1, R81.2, R82.1; also elsewhere on the board
PD_REQ_9V: D24.2 (A); also elsewhere on the board
SEL_IN2: C279.1, D24.1 (K), Q6.1 (G), R200.1
SW+1V0: L7.2, U15.1 (LX), U15.2 (LX)
SW+1V2_MGT: L6.2, U16.4 (SW)
SW+1V8_IO: L5.2, U14.4 (SW)
SW+2V5: L4.2, U13.4 (SW)
SW_3V3: C193.2, L3.2, U12.5 (SW)
SW_5V: C188.2, L2.2, U11.5 (SW)
U21_ILIM: R74.1, U21.4 (ILIM)
U22_ILIM: R75.1, U22.4 (ILIM)
U23_CT: C272.1, U23.6 (CT)
U24_CT: C275.1, U24.6 (CT)
VBUS: C187.1, C264.1, R50.1, R52.1, R162.1, R164.1, U26.5 (IN), U34.7 (IN1); also elsewhere on the board
VBUS5_CP2: R166.2, R167.1, U34.3 (CP2)
VBUS5_ILIM: R168.1, U34.10 (ILIM)
VBUS5_OV1: R164.2, R165.1, U34.5 (OV1)
VBUS5_PR1: Q6.3 (D), Q7.3 (D), R162.2, R163.1, U34.6 (PR1)
VBUS5_SS: C263.1, U34.11 (SS)
VBUS5_ST: R169.2, U34.9 (ST); also elsewhere on the board
VBUS_DVDT: C184.1, U26.7 (dVdt)
VBUS_ILM: R54.1, U26.9 (ILM)
VBUS_OVLO: R52.2, R53.1, U26.2 (OVLO)
VBUS_SS: D3.2 (A), U26.6 (OUT)
VBUS_UVLO: R50.2, R51.1, U26.1 (EN/UVLO)
VCCIO_1: C220.1, R198.1, U23.1 (IN), U23.2 (IN); also elsewhere on the board
VCCIO_1_EXT: C273.1, U23.8 (SNS), U23.9 (OUT), U23.10 (OUT); also elsewhere on the board
VCCIO_2: C221.1, R199.1, U24.1 (IN), U24.2 (IN); also elsewhere on the board
VCCIO_2_EXT: C276.1, U24.8 (SNS), U24.9 (OUT), U24.10 (OUT); also elsewhere on the board
VIN_EXT: D4.2 (A), D8.1 (K), J50.1, R201.1
VSYS: C185.1, C186.1, C192.1, C267.1, D3.1 (K), D4.1 (K), R81.1, U11.3 (VIN), U12.3 (VIN)

Notes on the sheet:
POWER — Power tree: VSYS input, regulators, AUX IN pass-through and monitoring — HW 0.1.0-proto.1
input OR-ing
Where power enters. Two inputs feed one internal supply, VSYS: USB-C (5 V, or 9 V when a USB-PD charger agrees) and the J50 screw terminal (9-21 V). A diode on each (D3, D4) lets whichever is higher supply the board and stops one input from back-feeding the other. On the USB side, U26 is an electro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
U11 VSYS to +5V
Switching regulator (buck converter) that makes +5V from VSYS. It runs whenever power is present (no enable), like U12, so the FPGA's 1.8 V auxiliary supply is never missing while its 3.3 V banks are powered. Its output goes to the +5V rail through U34. +5V feeds the 5 V buses, the extension 5 V pi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
U12 VSYS to +3V3 (always-on AP63300 reference circuit)
Switching regulator that makes +3V3 from VSYS. It has no enable: it starts as soon as any power is present, because +3V3 runs the board controller, which then switches everything else on. Also powers the PSRAM, the flashes, the PHY and most logic. The two feedback resistors set 3.3 V; the inductor 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
U13 5V to +2V5
Small switching regulator that makes +2V5 from +5V for FPGA bank 16 (network) and the PHY's RGMII pins. Enabled by the board controller (EN_2V5); the feedback resistors set 2.5 V.
U14 5V to +1V8_IO
Small switching regulator that makes 1.8 V from +5V. Its output node is +1V8_IO: FPGA bank 13 and the 1.8 V memory on it, the 1.8 V position of the J19/J20 jumpers, and, through the bead below, the FPGA's auxiliary supply (VCCAUX) and its ADC as +1V8. Its enable is tied to +5V, so it runs whenever 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
U16 5V to +1V2_MGT
Small switching regulator that makes +1V2_MGT from +5V for the FPGA transceivers' MGTAVTT supply. The transceivers are unused in rev A but must stay powered. Enabled by the board controller (EN_1V2).
U15 5V to +1V0 (4A FPGA core supply)
The FPGA core supply: up to 4 A at 1.0 V from +5V, the heaviest rail on the board. Enabled by the board controller (EN_1V0); its power-good output (CORE_1V0_GOOD) goes to the board controller (GPIO38) so firmware knows the core is up. The soft-start capacitor makes it ramp slowly; the feedback resi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
extension power protection control
Shared control for the four protected extension supplies (U21-U24). EXT_EN, from the board controller, turns them all on; the pull-down keeps them off until firmware decides. EXT_FAULT is pulled up and goes low if any of them (or the USB eFuse) detects a fault, so one controller pin hears all of th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
U21 +5V to +5V_EXT
Protected switch between the board's +5V and the 5 V pins of every extension port. Limits current to about 1 A and blocks current flowing back from an extension. Without it, a shorted extension would pull the whole board's 5 V down.
U22 +3V3 to +3V3_EXT
Protected switch between +3V3 and the 3.3 V pins of every extension port, limited to about 0.5 A, with reverse blocking. Keeps a faulty extension from taking down the board controller's supply.
U23 VCCIO_1 to VCCIO_1_EXT
Switch for the PIN V supply of slots A-D (the voltage chosen on J19). It is biased from +3V3 so it works down to the 1.8 V setting, blocks current flowing back in while off, ramps its output in about 1.5 ms and shuts down when hot. Overload protection is each slot's 500 mA fuse; the switch itself h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
U24 VCCIO_2 to VCCIO_2_EXT
Switch for the PIN V supply of slots E-H (the voltage chosen on J20). It is biased from +3V3 so it works down to the 1.8 V setting, blocks current flowing back in while off, ramps its output in about 1.5 ms and shuts down when hot. Overload protection is each slot's 500 mA fuse; the switch itself h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
MGTAVCC filter
A small inductor and capacitor that make +1V0_MGT from +1V0: the same voltage, with the core's switching noise filtered out, for the transceivers' MGTAVCC supply.
rail monitors
Lets the board controller measure every supply. Each rail goes to one of its eight analog inputs (ADC), which read 0-3.3 V. Rails at or below 3.3 V go through a 1 k resistor that protects the pin; VSYS and +5V are higher, so two resistors divide them down first. A 100 nF capacitor on each input ste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
AUX IN
Optional extra power for extensions that need more than 5 V (motors, LED strips, displays). Whatever you connect here (9-28 V DC) goes, unregulated, to the AUX pin of every extension port through each port's own fuse. The board itself never uses it.
VCCAUX filter
The split between +1V8_IO and +1V8. VCCAUX and VCCADC are the FPGA's internal supplies (clocking, I/O pre- drivers, the XADC) and should not share copper with switching 1.8 V I/O loads, so they hang off U14's output through one ferrite bead (120 ohm at 100 MHz, 2 A, 50 mohm: 9 mV at the 0.18 A VCCA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
U34 +5V source select
Chooses what feeds the +5V rail: USB power straight from the connector, or U11. A regulator cannot make 5 V out of 5 V, so on a plain 5 V USB source the mux passes VBUS to the rail. It hands the rail to U11 while the board controller asks the charger for 9 V and for a few seconds after (Q6), while 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
Q6 mux hold: 9 V request
Keeps U34 on U11 around a 9 V negotiation. The controller's 9 V request charges a capacitor through D24 at once and the capacitor drains through its resistor in 2-7 s, so the rail leaves VBUS before the charger moves it and returns only when VBUS is back at 5 V. No voltage threshold can do that wit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
Q7 mux hold: screw input present
Keeps U34 on U11 whenever the screw input carries voltage, so a bench supply on J50 carries the whole board even with a 5 V USB cable plugged in; before, the USB port kept the 5 V load.
Power flags for the rails made on this page
