bcarbone24/freyja/kicad/odin.kicad_pcb

## KiCad design kicad/odin.kicad_pcb (continued)

Schematic: memory.kicad_sch

Parts:
C111, C112, C113, C114, C115, C250, C251, C252, C253, C254, C255, C256, C258, C259: 100nF; C_0402_1005Metric; LCSC C1525
C257, C260: 10uF; C_0805_2012Metric; LCSC C15850
J74: microSD; TF-SMD_TF-01A-NPTH; LCSC C91145
R104, R105, R106, R107, R108, R109, R110, R111, R112, R113, R114, R115, R116, R117, R118, R119, R120, R121, R122, R123, R124, R125, R126, R127: 33; R_0402_1005Metric; LCSC C25105
R151: 22; R_0402_1005Metric
R152, R153, R154, R155, R156, R157, R158, R159, R160, R161, R174, R175, R176, R177, R178, R179, R180, R181, R182, R183, R184, R185, R186, R187, R188, R189, R190, R191, R192, R193, R194, R195, R196, R197: 10k; R_0603_1608Metric
U2, U3, U4, U5: APS6404L-SQN-SN; SOIC-8_L4.9-W3.9-P1.27-LS6.0-BL; LCSC C5360304
U6: W25Q256JVEIQ; WSON-8_L8.0-W6.10-P1.27-BL-EP; LCSC C97522
U32: W9825G6KH-6; TSOP-II-54_22.2x10.16mm_P0.8mm; LCSC C62246
U33: MR25H10CDF; DFN-8_L5.0-W6.0-P1.27-EP2.0-2VIA; LCSC C246234

Connections:
+1V8_IO: C111.1, C112.1, C113.1, C114.1, R174.1, R180.1, R186.1, R192.1, U2.8 (VDD), U3.8 (VDD), U4.8 (VDD), U5.8 (VDD); also elsewhere on the board
+3V3: C115.1, C250.1, C251.1, C252.1, C253.1, C254.1, C255.1, C256.1, C257.1, C258.1, C259.1, C260.1, J74.4 (VDD), R152.1, R154.1, R155.1, R156.1, R157.1, R158.1, R159.1, R160.1, R161.1, U6.8 (VCC), U32.1 (VDD), U32.3 (VDDQ), U32.9 (VDDQ), U32.14 (VDD), U32.27 (VDD), U32.43 (VDDQ), U32.49 (VDDQ), U33.8 (VDD); also elsewhere on the board
CFG_CCLK: U6.6 (CLK); also elsewhere on the board
FLASH_CS_B: U6.1 (~CS); also elsewhere on the board
FLASH_D0_MOSI: U6.5 (DI/IO0); also elsewhere on the board
FLASH_D1_MISO: U6.2 (DO/IO1); also elsewhere on the board
FLASH_D2_WP: U6.3 (~WP/IO2); also elsewhere on the board
FLASH_D3_HOLD: U6.7 (~HOLD/IO3); also elsewhere on the board
GND: C111.2, C112.2, C113.2, C114.2, C115.2, C250.2, C251.2, C252.2, C253.2, C254.2, C255.2, C256.2, C257.2, C258.2, C259.2, C260.2, J74.6 (VSS), J74.10 (GND), J74.11 (GND), J74.12 (GND), J74.13 (GND), R153.2, R175.2, R176.2, R177.2, R178.2, R179.2, R181.2, R182.2, R183.2, R184.2, R185.2, R187.2, R188.2, R189.2, R190.2, R191.2, R193.2, R194.2, R195.2, R196.2, R197.2, U2.4 (VSS), U3.4 (VSS), U4.4 (VSS), U5.4 (VSS), U6.4 (GND), U6.9 (EP), U32.6 (VSSQ), U32.12 (VSSQ), U32.28 (VSS), U32.41 (VSS), U32.46 (VSSQ), U32.52 (VSSQ), U32.54 (VSS), U33.4 (VSS), U33.9 (EP); also elsewhere on the board
MRAM_CS: R154.2, U33.1 (~CS); also elsewhere on the board
MRAM_HOLD: R156.2, U33.7 (~HOLD)
MRAM_SCK: U33.6 (SCK); also elsewhere on the board
MRAM_SI: U33.5 (SI); also elsewhere on the board
MRAM_SO: U33.2 (SO); also elsewhere on the board
MRAM_WP: R155.2, U33.3 (~WP)
PSRAM0_CE_B: R105.1; also elsewhere on the board
PSRAM0_CE_B_MEM: R105.2, R174.2, U2.1 (~CE)
PSRAM0_IO0: R106.1; also elsewhere on the board
PSRAM0_IO0_MEM: R106.2, R176.1, U2.5 (SI/SIO0)
PSRAM0_IO1: R107.1; also elsewhere on the board
PSRAM0_IO1_MEM: R107.2, R177.1, U2.2 (SO/SIO1)
PSRAM0_IO2: R108.1; also elsewhere on the board
PSRAM0_IO2_MEM: R108.2, R178.1, U2.3 (SIO2)
PSRAM0_IO3: R109.1; also elsewhere on the board
PSRAM0_IO3_MEM: R109.2, R179.1, U2.7 (SIO3)
PSRAM0_SCK: R104.1; also elsewhere on the board
PSRAM0_SCK_MEM: R104.2, R175.1, U2.6 (SCLK)
PSRAM1_CE_B: R111.1; also elsewhere on the board
PSRAM1_CE_B_MEM: R111.2, R180.2, U3.1 (~CE)
PSRAM1_IO0: R112.1; also elsewhere on the board
PSRAM1_IO0_MEM: R112.2, R182.1, U3.5 (SI/SIO0)
PSRAM1_IO1: R113.1; also elsewhere on the board
PSRAM1_IO1_MEM: R113.2, R183.1, U3.2 (SO/SIO1)
PSRAM1_IO2: R114.1; also elsewhere on the board
PSRAM1_IO2_MEM: R114.2, R184.1, U3.3 (SIO2)
PSRAM1_IO3: R115.1; also elsewhere on the board
PSRAM1_IO3_MEM: R115.2, R185.1, U3.7 (SIO3)
PSRAM1_SCK: R110.1; also elsewhere on the board
PSRAM1_SCK_MEM: R110.2, R181.1, U3.6 (SCLK)
PSRAM2_CE_B: R117.1; also elsewhere on the board
PSRAM2_CE_B_MEM: R117.2, R186.2, U4.1 (~CE)
PSRAM2_IO0: R118.1; also elsewhere on the board
PSRAM2_IO0_MEM: R118.2, R188.1, U4.5 (SI/SIO0)
PSRAM2_IO1: R119.1; also elsewhere on the board
PSRAM2_IO1_MEM: R119.2, R189.1, U4.2 (SO/SIO1)
PSRAM2_IO2: R120.1; also elsewhere on the board
PSRAM2_IO2_MEM: R120.2, R190.1, U4.3 (SIO2)
PSRAM2_IO3: R121.1; also elsewhere on the board
PSRAM2_IO3_MEM: R121.2, R191.1, U4.7 (SIO3)
PSRAM2_SCK: R116.1; also elsewhere on the board
PSRAM2_SCK_MEM: R116.2, R187.1, U4.6 (SCLK)
PSRAM3_CE_B: R123.1; also elsewhere on the board
PSRAM3_CE_B_MEM: R123.2, R192.2, U5.1 (~CE)
PSRAM3_IO0: R124.1; also elsewhere on the board
PSRAM3_IO0_MEM: R124.2, R194.1, U5.5 (SI/SIO0)
PSRAM3_IO1: R125.1; also elsewhere on the board
PSRAM3_IO1_MEM: R125.2, R195.1, U5.2 (SO/SIO1)
PSRAM3_IO2: R126.1; also elsewhere on the board
PSRAM3_IO2_MEM: R126.2, R196.1, U5.3 (SIO2)
PSRAM3_IO3: R127.1; also elsewhere on the board
PSRAM3_IO3_MEM: R127.2, R197.1, U5.7 (SIO3)
PSRAM3_SCK: R122.1; also elsewhere on the board
PSRAM3_SCK_MEM: R122.2, R193.1, U5.6 (SCLK)
SDRAM_A0: U32.23 (A0); also elsewhere on the board
SDRAM_A1: U32.24 (A1); also elsewhere on the board
SDRAM_A2: U32.25 (A2); also elsewhere on the board
SDRAM_A3: U32.26 (A3); also elsewhere on the board
SDRAM_A4: U32.29 (A4); also elsewhere on the board
SDRAM_A5: U32.30 (A5); also elsewhere on the board
SDRAM_A6: U32.31 (A6); also elsewhere on the board
SDRAM_A7: U32.32 (A7); also elsewhere on the board
SDRAM_A8: U32.33 (A8); also elsewhere on the board
SDRAM_A9: U32.34 (A9); also elsewhere on the board
SDRAM_A10: U32.22 (A10); also elsewhere on the board
SDRAM_A11: U32.35 (A11); also elsewhere on the board
SDRAM_A12: U32.36 (A12); also elsewhere on the board
SDRAM_BA0: U32.20 (BS0); also elsewhere on the board
SDRAM_BA1: U32.21 (BS1); also elsewhere on the board
SDRAM_CAS_N: U32.17 (~CAS); also elsewhere on the board
SDRAM_CKE: R153.1, U32.37 (CKE); also elsewhere on the board
SDRAM_CLK: R151.1; also elsewhere on the board
SDRAM_CLK_MEM: R151.2, U32.38 (CLK)
SDRAM_CS_N: R152.2, U32.19 (~CS); also elsewhere on the board
SDRAM_DQ0: U32.2 (DQ0); also elsewhere on the board
SDRAM_DQ1: U32.4 (DQ1); also elsewhere on the board
SDRAM_DQ2: U32.5 (DQ2); also elsewhere on the board
SDRAM_DQ3: U32.7 (DQ3); also elsewhere on the board
SDRAM_DQ4: U32.8 (DQ4); also elsewhere on the board
SDRAM_DQ5: U32.10 (DQ5); also elsewhere on the board
SDRAM_DQ6: U32.11 (DQ6); also elsewhere on the board
SDRAM_DQ7: U32.13 (DQ7); also elsewhere on the board
SDRAM_DQ8: U32.42 (DQ8); also elsewhere on the board
SDRAM_DQ9: U32.44 (DQ9); also elsewhere on the board
SDRAM_DQ10: U32.45 (DQ10); also elsewhere on the board
SDRAM_DQ11: U32.47 (DQ11); also elsewhere on the board
SDRAM_DQ12: U32.48 (DQ12); also elsewhere on the board
SDRAM_DQ13: U32.50 (DQ13); also elsewhere on the board
SDRAM_DQ14: U32.51 (DQ14); also elsewhere on the board
SDRAM_DQ15: U32.53 (DQ15); also elsewhere on the board
SDRAM_LDQM: U32.15 (LDQM); also elsewhere on the board
SDRAM_RAS_N: U32.18 (~RAS); also elsewhere on the board
SDRAM_UDQM: U32.39 (UDQM); also elsewhere on the board
SDRAM_WE_N: U32.16 (~WE); also elsewhere on the board
SD_CD: J74.9 (CD); also elsewhere on the board
SD_CS: J74.2 (CDDAT3(CS)), R157.2; also elsewhere on the board
SD_DAT1: J74.8 (DAT1(RSV)), R160.2
SD_DAT2: J74.1 (DAT2(RSV)), R161.2
SD_MISO: J74.7 (DAT0(D0)), R159.2; also elsewhere on the board
SD_MOSI: J74.3 (CMD(DI)), R158.2; also elsewhere on the board
SD_SCK: J74.5 (CLK(SCLK)); also elsewhere on the board

Notes on the sheet:
MEMORY — PSRAM x4 (independent buses, 1.8 V), SDRAM, MRAM, microSD and configuration flash — HW 0.1.0-proto.1
PSRAM0
Working-memory chip 0: 8 MB of fast RAM for the FPGA design, on its own four-bit (QSPI) bus to bank 13 at 1.8 V. The four chips are independent, so a design can use them in parallel. Notes: ref/psram.md.
PSRAM1
Working-memory chip 1: 8 MB of RAM on its own QSPI bus to bank 13, at 1.8 V.
PSRAM2
Working-memory chip 2: 8 MB of RAM on its own QSPI bus to bank 13, at 1.8 V.
PSRAM3
Working-memory chip 3: 8 MB of RAM on its own QSPI bus to bank 13, at 1.8 V.
config flash
The FPGA's non-volatile memory. At power-on the FPGA reads its design (bitstream) from this 32 MB flash by itself (master SPI, set by the mode straps). The board controller can rewrite it through the series resistors on the Board Controller sheet, and spare space can hold user data or software for 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
U1 PSRAM0 series termination
One 33 ohm resistor per PSRAM0 line, placed next to the FPGA: they soften the fast signal edges so they do not ring along the trace. Values can be tuned after measurement (ref/psram.md).
U1 PSRAM1 series termination
One 33 ohm resistor per PSRAM1 line, next to the FPGA, to damp ringing.
U1 PSRAM2 series termination
One 33 ohm resistor per PSRAM2 line, next to the FPGA, to damp ringing.
U1 PSRAM3 series termination
One 33 ohm resistor per PSRAM3 line, next to the FPGA, to damp ringing.
SDRAM
A 32 MB SDR SDRAM (Winbond W9825G6KH-6, 16 bits wide, up to 166 MHz) for designs that outgrow the PSRAMs: a framebuffer, a soft CPU's main memory, a capture buffer. Its data and control lines come from bank 35 and its address lines from bank 14, both at 3.3 V. One 100 nF per VDD/VDDQ pin pair (seve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
U1 SDRAM clock source
The 22 ohm resistor in the SDRAM clock line. It sits at the FPGA ball that drives the clock, so it damps the edge at its source; it is in U1's island, not the SDRAM's (findings 44).
MRAM
A 128 KB non-volatile SPI memory (Everspin MR25H10CDF) that keeps its contents without power and has no write wear: settings, logs, a boot menu, a save file. CS is pulled up so the chip stays deselected while power comes up (datasheet section 4); WP and HOLD are pulled up and not connected to the F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
microSD socket
A push-push microSD socket (Hroparts TF-01A) wired for SPI mode: chip select on DAT3, data in on CMD, data out on DAT0, clock on CLK, five bank 14 lines at 3.3 V including the card-detect switch. The 10k pull-ups hold CS, the two data lines and the two unused DAT lines high, as the SD specification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
PSRAM0 power-up state
Six 10k resistors at the PSRAM0 pins: CE# pulled up to its own supply, clock and the four data lines pulled down. The chip requires these levels from the first moment of its supply ramp until 150 us after it, and an unconfigured FPGA leaves its pins floating, so resistors, not the FPGA, guarantee t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
PSRAM1 power-up state
Six 10k resistors at the PSRAM1 pins: CE# up, clock and data down, from power-up (APS6404L section 8).
PSRAM2 power-up state
Six 10k resistors at the PSRAM2 pins: CE# up, clock and data down, from power-up (APS6404L section 8).
PSRAM3 power-up state
Six 10k resistors at the PSRAM3 pins: CE# up, clock and data down, from power-up (APS6404L section 8).

Schematic: supervisor.kicad_sch

Parts:
C116, C117, C118, C119, C120, C121, C122, C123, C124, C125, C126, C127, C128, C129, C135, C136, C138: 100nF; C_0402_1005Metric; LCSC C1525
C130, C131, C132: 4.7uF; C_0603_1608Metric; LCSC C277476
C133, C134: 15pF; C_0402_1005Metric
C137: 1uF; C_0402_1005Metric
D6: ESDA6V1BC6; SOT-23-6_L2.9-W1.6-P0.95-LS2.8-BR; LCSC C495220
D7: SMBJ13A-TR; SMB_L4.6-W3.6-LS5.3-RD; LCSC C133675
D9, D10, D11: F.0603.00025/P2-0603G1TS2-06T-002; LED0603-RD_GREEN; LCSC C7496818
J1: USB-C; USB_C_Receptacle_HCTL_HC-TYPE-C-16P-01A_Odin; LCSC C2894897
J2: FPGA JTAG; IDC-TH_10P-P2.54_C5665; LCSC C5665
J51: CTRL SWD; CONN-SMD-3P-P1.00_BM03B-SRSS-TB-LF-SN; LCSC C160389
J52: PZ254V-11-02P; HDR-TH_2P-P2.54-V-M; LCSC C492401
L1: 3.3uH AOTA-B201610S3R3-101-T; IND-SMD_L2.0-W1.6_AOTA-B201610S3R3-101-T; LCSC C42411119
Q3: BSS138LT1G; SOT-23-3_L2.9-W1.6-P1.90-LS2.8-BR; LCSC C82045
R8, R14, R15, R16, R17, R18, R19, R20, R21, R22, R23, R24, R25, R26, R27, R28, R29, R30, R31, R32: 33; R_0402_1005Metric; LCSC C25105
R9, R10, R12, R128, R129, R130: 1k; R_0402_1005Metric; LCSC C11702
R11, R172: 10k; R_0402_1005Metric
R13: 10k; R_0402_1005Metric; not fitted
R33: 0; R_0402_1005Metric
R34: 10k; R_0603_1608Metric
R170, R171: 27; R_0402_1005Metric
R173: 100k; R_0402_1005Metric; LCSC C25741
SW1: CTRL BOOT; KEY-SMD_B3U-1000PM; LCSC C231329
U7: RP2350B; QFN-80_L10.0-W10.0-P0.40-TL-EP3.4; LCSC C42415655
U8: W25Q32JVZP; WSON-8_L6.0-W5.0-P1.27-BL-EP; LCSC C571260
U18: CH224K; ESSOP-10_L4.9-W3.9-P1.0-LS6.0-TL-EP; LCSC C970725
U20: SN74CB3Q3384APWR; TSSOP-24_L7.8-W4.4-P0.65-LS6.4-BL; LCSC C469874
Y1: 12MHz ABM8-272-T3; CRYSTAL-SMD_4P-L3.2-W2.5-BL; LCSC C20625731

Connections:
+1V1: C127.1, C128.1, C129.1, C131.1, L1.1, U7.10 (DVDD), U7.32 (DVDD), U7.51 (DVDD), U7.65 (VREG_FB)
+3V3: C116.1, C117.1, C118.1, C119.1, C120.1, C121.1, C122.1, C123.1, C124.1, C125.1, C126.1, C130.1, C136.1, C138.1, J2.1, J52.1, R8.1, R10.1, R11.1, R13.1, R128.1, R129.1, R130.1, U7.5 (IOVDD), U7.15 (IOVDD), U7.24 (IOVDD), U7.29 (IOVDD), U7.41 (IOVDD), U7.50 (IOVDD), U7.59 (ADC_AVDD), U7.60 (IOVDD), U7.64 (VREG_VIN), U7.68 (USB_OTP_VDD), U7.69 (QSPI_IOVDD), U7.76 (IOVDD), U8.8 (VCC), U20.13 (~2OE), U20.24 (VCC); also elsewhere on the board
BOOTSEL_SW: R12.2, SW1.1
CFG_CCLK: R21.2; also elsewhere on the board
CFG_DONE: R20.2; also elsewhere on the board
CFG_INIT_B: R19.2; also elsewhere on the board
CFG_PROG_B: R18.2; also elsewhere on the board
CORE_1V0_GOOD: U7.47 (GPIO38); also elsewhere on the board
DBG_TCK: R27.2; also elsewhere on the board
DBG_TDI: R29.2; also elsewhere on the board
DBG_TDO: R30.2; also elsewhere on the board
DBG_TMS: R28.2; also elsewhere on the board
EN_1V0: U7.25 (GPIO24); also elsewhere on the board
EN_1V2: U7.26 (GPIO25); also elsewhere on the board
EN_2V5: U7.22 (GPIO22); also elsewhere on the board
EXTERNAL_JTAG_SELECTED: J52.2, R34.1, U20.1 (~1OE)
EXT_EN: U7.6 (GPIO8); also elsewhere on the board
EXT_FAULT: U7.43 (GPIO34); also elsewhere on the board
FLASH_CS_B: R22.2; also elsewhere on the board
FLASH_D0_MOSI: R23.2; also elsewhere on the board
FLASH_D1_MISO: R24.2; also elsewhere on the board
FLASH_D2_WP: R25.2; also elsewhere on the board
FLASH_D3_HOLD: R26.2; also elsewhere on the board
GND: C116.2, C117.2, C118.2, C119.2, C120.2, C121.2, C122.2, C123.2, C124.2, C125.2, C126.2, C127.2, C128.2, C129.2, C130.2, C131.2, C132.2, C133.2, C134.2, C135.2, C136.2, C137.2, C138.2, D6.2 (COM), D6.5 (COM), D7.2 (A), J1.A1 (GND), J1.A12 (GND), J1.B1 (GND), J1.B12 (GND), J1.SH (SHIELD), J2.2, J2.4, J2.6, J2.8, J2.10, J51.2, Q3.2 (S), R34.2, R173.2, SW1.2, U7.62 (VREG_PGND), U7.81 (GND), U8.4 (GND), U8.9 (EP), U18.2 (CFG2), U18.3 (CFG3), U18.11 (GND), U20.12 (GND), Y1.2 (G), Y1.4 (G); also elsewhere on the board
JTAG_TCK: J2.5, U20.2 (1B1); also elsewhere on the board
JTAG_TDI: J2.9, U20.6 (1B3); also elsewhere on the board
JTAG_TDO: J2.7, R33.2; also elsewhere on the board
JTAG_TDO_SW: R33.1, U20.9 (1B4)
JTAG_TMS: J2.3, U20.5 (1B2); also elsewhere on the board
LED_HEARTBEAT_A: D9.2 (A), R128.2
LED_HEARTBEAT_N: D9.1 (C), U7.44 (GPIO35)
LED_USER1_A: D10.2 (A), R129.2
LED_USER1_N: D10.1 (C), U7.45 (GPIO36)
LED_USER2_A: D11.2 (A), R130.2
LED_USER2_N: D11.1 (C), U7.46 (GPIO37)
MON_1V0: U7.56 (GPIO45/ADC5); also elsewhere on the board
MON_1V8: U7.55 (GPIO44/ADC4); also elsewhere on the board
MON_2V5: U7.54 (GPIO43/ADC3); also elsewhere on the board
MON_3V3: U7.53 (GPIO42/ADC2); also elsewhere on the board
MON_5V: U7.52 (GPIO41/ADC1); also elsewhere on the board
MON_VCCIO_1: U7.57 (GPIO46/ADC6); also elsewhere on the board
MON_VCCIO_2: U7.58 (GPIO47/ADC7); also elsewhere on the board
MON_VSYS: U7.49 (GPIO40/ADC0); also elsewhere on the board
PD_CFG1: Q3.3 (D), R172.2, U18.9 (CFG1)
PD_PG: R11.2, U7.38 (GPIO30), U18.10 (PG)
PD_REQ_9V: Q3.1 (G), R173.1, U7.28 (GPIO27); also elsewhere on the board
PD_VDD: C137.1, R172.1, U18.1 (VDD)
SB_UART_RX: R31.2; also elsewhere on the board
SB_UART_TX: R32.2; also elsewhere on the board
SUPF_CLK: U7.71 (QSPI_SCLK), U8.6 (CLK)
SUPF_CS: R12.1, R13.2, U7.75 (~QSPI_SS), U8.1 (~CS)
SUPF_D0: U7.72 (QSPI_SD0), U8.5 (DI/IO_{0})
SUPF_D1: U7.74 (QSPI_SD1), U8.2 (DO/IO_{1})
SUPF_D2: U7.73 (QSPI_SD2), U8.3 (~WP/IO_{2})
SUPF_D3: U7.70 (QSPI_SD3), U8.7 (~HOLD/~RESET/IO_{3})
SUP_CCLK: R21.1, U7.8 (GPIO10)
SUP_DBG_TCK: R27.1, U7.14 (GPIO15)
SUP_DBG_TDI: R29.1, U7.17 (GPIO17)
SUP_DBG_TDO: R30.1, U7.18 (GPIO18)
SUP_DBG_TMS: R28.1, U7.16 (GPIO16)
SUP_DONE: R20.1, U7.3 (GPIO6)
SUP_FCS_B: R22.1, U7.7 (GPIO9)
SUP_FD0: R23.1, U7.9 (GPIO11)
SUP_FD1: R24.1, U7.11 (GPIO12)
SUP_FD2: R25.1, U7.12 (GPIO13)
SUP_FD3: R26.1, U7.4 (GPIO7)
SUP_INIT_B: R19.1, U7.2 (GPIO5)
SUP_JTAG_TCK: R14.1, U7.77 (GPIO0)
SUP_JTAG_TDI: R16.1, U7.79 (GPIO2)
SUP_JTAG_TDO: R17.1, U7.80 (GPIO3)
SUP_JTAG_TMS: R15.1, U7.78 (GPIO1)
SUP_LX: L1.2, U7.63 (VREG_LX)
SUP_PROG_B: R18.1, U7.1 (GPIO4)
SUP_RUN: C135.1, R10.2, U7.35 (RUN)
SUP_SWCLK: J51.1, U7.33 (SWCLK)
SUP_SWDIO: J51.3, U7.34 (SWDIO)
SUP_UART_RX: R32.1, U7.42 (GPIO33)
SUP_UART_TX: R31.1, U7.40 (GPIO32)
SUP_VREG_AVDD: C132.1, R8.2, U7.61 (VREG_AVDD)
SUP_XIN: C133.1, U7.30 (XIN), Y1.1
SUP_XOUT: R9.1, U7.31 (XOUT)
SUP_XTAL_OUT: C134.1, R9.2, Y1.3
SWJ_TCK: R14.2, U20.3 (1A1)
SWJ_TDI: R16.2, U20.7 (1A3)
SWJ_TDO: R17.2, U20.8 (1A4)
SWJ_TMS: R15.2, U20.4 (1A2)
USB_CC1: D6.4 (TVS3), J1.A5 (CC1), U18.7 (CC1)
USB_CC2: D6.6 (TVS4), J1.B5 (CC2), U18.6 (CC2)
USB_DM: D6.3 (TVS2), J1.A7 (D-), J1.B7 (D-), R171.1
USB_DM_MCU: R171.2, U7.66 (USB_DM)
USB_DP: D6.1 (TVS1), J1.A6 (D+), J1.B6 (D+), R170.1
USB_DP_MCU: R170.2, U7.67 (USB_DP)
VBUS: D7.1 (K), J1.A4 (VBUS), J1.A9 (VBUS), J1.B4 (VBUS), J1.B9 (VBUS), U18.8 (VBUS); also elsewhere on the board
VBUS5_ST: U7.21 (GPIO21); also elsewhere on the board

Notes on the sheet:
SUPERVISOR — Board controller: RP2350B, USB-C, startup memory and FPGA control — HW 0.1.0-proto.1
U7 board controller
The board controller, a Raspberry Pi RP2350B microcontroller that is always on. It is what the USB cable talks to: it loads designs into the FPGA over JTAG or writes them to the FPGA's flash, turns the supplies on in order and watches them, asks a USB-PD charger for 9 V, enables extension power, an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
U7 core regulator (RP-008280 s2.1)
Parts for the RP2350's built-in switching regulator, which makes its 1.1 V core supply (+1V1) from +3V3. Values and the inductor are the ones Raspberry Pi specifies in their hardware design guide (RP-008280 section 2.1).
crystal (RP-008280 s4)
The board controller's 12 MHz clock: the exact crystal, load capacitors and 1 k drive-limiting resistor Raspberry Pi specifies (RP-008280 section 4).
RUN
The board controller's reset input. The pull-up keeps it running; the capacitor holds it in reset briefly at power-on until +3V3 is stable.
board controller startup memory
The board controller's own 4 MB flash, holding its firmware. Separate from the FPGA's flash.
USB-C
The main connector: power in, and the USB link to your computer for programming and talking to the board.
USB protection
Clamps for static discharge and voltage spikes on the USB connector: D6 on the data and CC lines, D7 on the power line (VBUS).
USB-PD sink
Negotiates the supply voltage with a USB-PD charger. Out of the box it asks for 5 V: CFG1 is pulled up to the chip's own 3.3 V and CFG2/CFG3 are grounded, so the only other request the pins can form is 9 V, which the board controller selects by turning Q3 on (PD_REQ_9V). A dead or resetting control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
BOOTSEL
Hold CTRL BOOT while plugging in USB to put the board controller in its built-in USB bootloader, for installing or recovering its firmware. The 1 k resistor lets the button win without fighting the chip. The 10 k pull-up is not fitted, as in Raspberry Pi's design.
board controller SWD
Debug connector for the board controller's own processor (SWD): for developing its firmware with a debug probe. Not for the FPGA.
series resistors to FPGA
One 33 ohm resistor on every wire between the board controller and the FPGA: JTAG, the configuration pins, the FPGA flash bus, the debug sideband and the UART. They limit current if both sides ever drive the same wire at once, and damp ringing.
JTAG owner selection
Decides who programs the FPGA over JTAG. Normally (J52 open) the board controller does, through the U20 switch. Fit a jumper on J52 and U20 disconnects the board controller completely, so an external programmer plugged into J2 has the FPGA to itself. A jumper, not software, so it works even when th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
manual JTAG header
Standard 2x5 JTAG header for an external FPGA programmer (Xilinx/AMD cable or similar). Fit J52 first.
board status LEDs
Three green LEDs on board controller GPIO35-37, lit by driving the pin low: CTRL HB blinks while the board controller firmware is alive; USER 1 and USER 2 are for software. Each has a 1 k current-limiting resistor from +3V3. Rules: ref/status-leds.md.
U7 USB series resistors
Two 27 ohm resistors in the USB data lines, right at the board controller, as Raspberry Pi's hardware design guide (section 5.1) asks. The ESD clamp D6 stays at the connector.
Power flags for the rails made on this page

Schematic: slots.kicad_sch

Parts:
C139, C140, C141, C142, C144, C146, C148, C150, C152, C154, C156, C158, C160, C162: 100nF; C_0402_1005Metric; LCSC C1525
C143, C145, C147, C149, C151, C153, C155, C157, C159, C161: 10uF; C_0805_2012Metric; LCSC C15850
C163, C164, C165, C166: 22uF; C_0805_2012Metric; LCSC C86816
F1, F2, F5, F6, F9, F10, F13, F14, F17, F18, F21, F22, F25, F26, F29, F30, F33, F34, F37, F38: 500mA; F1206; LCSC C269115
F3, F7, F11, F15, F19, F23, F27, F31, F35, F39: 300mA; F1206; LCSC C22378340
F4, F8, F12, F16, F20, F24, F28, F32, F36, F40: 1.1A 33V; Fuse_TECHFUSE_SMD2018; LCSC C70150
J3, J5: WingTAT 2044-2X32G00SA; HDR-TH_64P-P2.54-V-F-R2-C32-S2.54-1; LCSC C49569844
J7, J8: PM254-2-08-Z-8.5; HDR-TH_16P-P2.54-V-F-R2-C8-S2.54; LCSC C2897409
J19, J20: 2.54-2*3P; HDR-TH_6P-P2.54-V-M-R2-C3-S2.54-1; LCSC C65114
J53, J54, J55, J56, J57, J58, J62, J63, J64, J65: XFCN PM254V-11-07-H85; HDR-TH_7P-P2.54-V-F; LCSC C2832270
MK65, MK66, MK67, MK68, MK69, MK70, MK71, MK72, MK76, MK77: BOOMELE 2.54-1x40P-21mm; cut to 1P; hand/wave sol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; HDR-TH_1P-P2.54-V-M-21MM-C51353; LCSC C51353
R96, R97: 10k; R_0603_1608Metric
U9, U10: SN74LXC8T245PWR; TSSOP-24_L7.8-W4.4-P0.65-LS6.4-BL_1; LCSC C4363995

Connections:
+1V8_IO: C139.1, C141.1, J19.5, J20.5, R96.1, R97.1, U9.1 (VCCA), U10.1 (VCCA); also elsewhere on the board
+2V5: J19.3, J20.3; also elsewhere on the board
+3V3: J19.1, J20.1; also elsewhere on the board
+3V3_EXT: F1.1, F3.1, F5.1, F7.1, F11.1, F15.1, F19.1, F23.1, F27.1, F31.1, F35.1, F39.1; also elsewhere on the board
+5V: C140.1, C142.1, U9.23 (VCCB), U9.24 (VCCB), U10.23 (VCCB), U10.24 (VCCB); also elsewhere on the board
+5V_EXT: F2.1, F6.1, F10.1, F14.1, F18.1, F22.1, F26.1, F30.1, F34.1, F38.1; also elsewhere on the board
AUX_RAIL: F4.1, F8.1, F12.1, F16.1, F20.1, F24.1, F28.1, F32.1, F36.1, F40.1; also elsewhere on the board
BUS5V0_DIR: U9.2 (DIR); also elsewhere on the board
BUS5V0_IO0: U9.3 (A1); also elsewhere on the board
BUS5V0_IO1: U9.4 (A2); also elsewhere on the board
BUS5V0_IO2: U9.5 (A3); also elsewhere on the board
BUS5V0_IO3: U9.6 (A4); also elsewhere on the board
BUS5V0_IO4: U9.7 (A5); also elsewhere on the board
BUS5V0_IO5: U9.8 (A6); also elsewhere on the board
BUS5V0_IO6: U9.9 (A7); also elsewhere on the board
BUS5V0_IO7: U9.10 (A8); also elsewhere on the board
BUS5V0_OE_N: R96.2, U9.22 (~OE); also elsewhere on the board
BUS5V0_PIN0: J7.1, U9.21 (B1)
BUS5V0_PIN1: J7.2, U9.20 (B2)
BUS5V0_PIN2: J7.3, U9.19 (B3)
BUS5V0_PIN3: J7.4, U9.18 (B4)
BUS5V0_PIN4: J7.7, U9.17 (B5)
BUS5V0_PIN5: J7.8, U9.16 (B6)
BUS5V0_PIN6: J7.9, U9.15 (B7)
BUS5V0_PIN7: J7.10, U9.14 (B8)
BUS5V1_DIR: U10.2 (DIR); also elsewhere on the board
BUS5V1_IO0: U10.3 (A1); also elsewhere on the board
BUS5V1_IO1: U10.4 (A2); also elsewhere on the board
BUS5V1_IO2: U10.5 (A3); also elsewhere on the board
BUS5V1_IO3: U10.6 (A4); also elsewhere on the board
BUS5V1_IO4: U10.7 (A5); also elsewhere on the board
BUS5V1_IO5: U10.8 (A6); also elsewhere on the board
BUS5V1_IO6: U10.9 (A7); also elsewhere on the board
BUS5V1_IO7: U10.10 (A8); also elsewhere on the board
BUS5V1_OE_N: R97.2, U10.22 (~OE); also elsewhere on the board
BUS5V1_PIN0: J8.1, U10.21 (B1)
BUS5V1_PIN1: J8.2, U10.20 (B2)
BUS5V1_PIN2: J8.3, U10.19 (B3)
BUS5V1_PIN3: J8.4, U10.18 (B4)
BUS5V1_PIN4: J8.7, U10.17 (B5)
BUS5V1_PIN5: J8.8, U10.16 (B6)
BUS5V1_PIN6: J8.9, U10.15 (B7)
BUS5V1_PIN7: J8.10, U10.14 (B8)
GND: C139.2, C140.2, C141.2, C142.2, C143.2, C144.2, C145.2, C146.2, C147.2, C148.2, C149.2, C150.2, C151.2, C152.2, C153.2, C154.2, C155.2, C156.2, C157.2, C158.2, C159.2, C160.2, C161.2, C162.2, C163.2, C164.2, C165.2, C166.2, J3.5, J3.6, J3.11, J3.12, J3.21, J3.22, J3.27, J3.28, J3.37, J3.38, J3.43, J3.44, J3.53, J3.54, J3.59, J3.60, J5.5, J5.6, J5.11, J5.12, J5.21, J5.22, J5.27, J5.28, J5.37, J5.38, J5.43, J5.44, J5.53, J5.54, J5.59, J5.60, J7.5, J7.6, J7.11, J7.12, J8.5, J8.6, J8.11, J8.12, J53.2, J53.4, J53.6, J54.2, J54.4, J54.6, J55.2, J55.4, J55.6, J56.2, J56.4, J56.6, J57.2, J57.4, J57.6, J58.2, J58.4, J58.6, J62.2, J62.4, J62.6, J63.2, J63.4, J63.6, J64.2, J64.4, J64.6, J65.2, J65.4, J65.6, MK65.1, MK66.1, MK67.1, MK68.1, MK69.1, MK70.1, MK71.1, MK72.1, MK76.1, MK77.1, U9.11 (GND), U9.12 (GND), U9.13 (GND), U10.11 (GND), U10.12 (GND), U10.13 (GND); also elsewhere on the board
SLOTA_IO0: J3.1; also elsewhere on the board
SLOTA_IO1: J3.2; also elsewhere on the board
SLOTA_IO2: J3.3; also elsewhere on the board
SLOTA_IO3: J3.4; also elsewhere on the board
SLOTA_IO4: J3.7; also elsewhere on the board
SLOTA_IO5: J3.8; also elsewhere on the board
SLOTA_IO6: J3.9; also elsewhere on the board
SLOTA_IO7: J3.10; also elsewhere on the board
SLOTA_IO8: J3.13; also elsewhere on the board
SLOTA_IO9: J3.14; also elsewhere on the board
SLOTA_IO10: J3.15; also elsewhere on the board
SLOTA_IO11: J3.16; also elsewhere on the board
SLOTB_IO0: J3.17; also elsewhere on the board
SLOTB_IO1: J3.18; also elsewhere on the board
SLOTB_IO2: J3.19; also elsewhere on the board
SLOTB_IO3: J3.20; also elsewhere on the board
SLOTB_IO4: J3.23; also elsewhere on the board
SLOTB_IO5: J3.24; also elsewhere on the board
SLOTB_IO6: J3.25; also elsewhere on the board
SLOTB_IO7: J3.26; also elsewhere on the board
SLOTB_IO8: J3.29; also elsewhere on the board
SLOTB_IO9: J3.30; also elsewhere on the board
SLOTB_IO10: J3.31; also elsewhere on the board
SLOTB_IO11: J3.32; also elsewhere on the board
SLOTC_IO0: J3.33; also elsewhere on the board
SLOTC_IO1: J3.34; also elsewhere on the board
SLOTC_IO2: J3.35; also elsewhere on the board
SLOTC_IO3: J3.36; also elsewhere on the board
SLOTC_IO4: J3.39; also elsewhere on the board
SLOTC_IO5: J3.40; also elsewhere on the board
SLOTC_IO6: J3.41; also elsewhere on the board
SLOTC_IO7: J3.42; also elsewhere on the board
SLOTC_IO8: J3.45; also elsewhere on the board
SLOTC_IO9: J3.46; also elsewhere on the board
SLOTC_IO10: J3.47; also elsewhere on the board
SLOTC_IO11: J3.48; also elsewhere on the board
SLOTD_IO0: J3.49; also elsewhere on the board
SLOTD_IO1: J3.50; also elsewhere on the board
SLOTD_IO2: J3.51; also elsewhere on the board
SLOTD_IO3: J3.52; also elsewhere on the board
SLOTD_IO4: J3.55; also elsewhere on the board
SLOTD_IO5: J3.56; also elsewhere on the board
SLOTD_IO6: J3.57; also elsewhere on the board
SLOTD_IO7: J3.58; also elsewhere on the board
SLOTD_IO8: J3.61; also elsewhere on the board
SLOTD_IO9: J3.62; also elsewhere on the board
SLOTD_IO10: J3.63; also elsewhere on the board
SLOTD_IO11: J3.64; also elsewhere on the board
SLOTE_IO0: J5.64; also elsewhere on the board
SLOTE_IO1: J5.63; also elsewhere on the board
SLOTE_IO2: J5.62; also elsewhere on the board
SLOTE_IO3: J5.61; also elsewhere on the board
SLOTE_IO4: J5.58; also elsewhere on the board
SLOTE_IO5: J5.57; also elsewhere on the board
SLOTE_IO6: J5.56; also elsewhere on the board
SLOTE_IO7: J5.55; also elsewhere on the board
SLOTE_IO8: J5.52; also elsewhere on the board
SLOTE_IO9: J5.51; also elsewhere on the board
SLOTE_IO10: J5.50; also elsewhere on the board
SLOTE_IO11: J5.49; also elsewhere on the board
SLOTF_IO0: J5.48; also elsewhere on the board
SLOTF_IO1: J5.47; also elsewhere on the board
SLOTF_IO2: J5.46; also elsewhere on the board
SLOTF_IO3: J5.45; also elsewhere on the board
SLOTF_IO4: J5.42; also elsewhere on the board
SLOTF_IO5: J5.41; also elsewhere on the board
SLOTF_IO6: J5.40; also elsewhere on the board
SLOTF_IO7: J5.39; also elsewhere on the board
SLOTF_IO8: J5.36; also elsewhere on the board
SLOTF_IO9: J5.35; also elsewhere on the board
SLOTF_IO10: J5.34; also elsewhere on the board
SLOTF_IO11: J5.33; also elsewhere on the board
SLOTG_IO0: J5.32; also elsewhere on the board
SLOTG_IO1: J5.31; also elsewhere on the board
SLOTG_IO2: J5.30; also elsewhere on the board
SLOTG_IO3: J5.29; also elsewhere on the board
SLOTG_IO4: J5.26; also elsewhere on the board
SLOTG_IO5: J5.25; also elsewhere on the board
SLOTG_IO6: J5.24; also elsewhere on the board
SLOTG_IO7: J5.23; also elsewhere on the board
SLOTG_IO8: J5.20; also elsewhere on the board
SLOTG_IO9: J5.19; also elsewhere on the board
SLOTG_IO10: J5.18; also elsewhere on the board
SLOTG_IO11: J5.17; also elsewhere on the board
SLOTH_IO0: J5.16; also elsewhere on the board
SLOTH_IO1: J5.15; also elsewhere on the board
SLOTH_IO2: J5.14; also elsewhere on the board
SLOTH_IO3: J5.13; also elsewhere on the board
SLOTH_IO4: J5.10; also elsewhere on the board
SLOTH_IO5: J5.9; also elsewhere on the board
SLOTH_IO6: J5.8; also elsewhere on the board
SLOTH_IO7: J5.7; also elsewhere on the board
SLOTH_IO8: J5.4; also elsewhere on the board
SLOTH_IO9: J5.3; also elsewhere on the board
SLOTH_IO10: J5.2; also elsewhere on the board
SLOTH_IO11: J5.1; also elsewhere on the board
SLOT_A_3V3: C148.1, F11.2, J53.3
SLOT_A_5V: F10.2, J53.5
SLOT_A_AUX: F12.2, J53.7
SLOT_A_PIN_VOLTAGE: C147.1, F9.2, J53.1
SLOT_B_3V3: C150.1, F15.2, J62.3
SLOT_B_5V: F14.2, J62.5
SLOT_B_AUX: F16.2, J62.7
SLOT_B_PIN_VOLTAGE: C149.1, F13.2, J62.1
SLOT_C_3V3: C152.1, F19.2, J54.3
SLOT_C_5V: F18.2, J54.5
SLOT_C_AUX: F20.2, J54.7
SLOT_C_PIN_VOLTAGE: C151.1, F17.2, J54.1
SLOT_D_3V3: C154.1, F23.2, J63.3
SLOT_D_5V: F22.2, J63.5
SLOT_D_AUX: F24.2, J63.7
SLOT_D_PIN_VOLTAGE: C153.1, F21.2, J63.1
SLOT_E_3V3: C156.1, F27.2, J55.3
SLOT_E_5V: F26.2, J55.5
SLOT_E_AUX: F28.2, J55.7
SLOT_E_PIN_VOLTAGE: C155.1, F25.2, J55.1
SLOT_F_3V3: C158.1, F31.2, J64.3
SLOT_F_5V: F30.2, J64.5
SLOT_F_AUX: F32.2, J64.7
SLOT_F_PIN_VOLTAGE: C157.1, F29.2, J64.1
SLOT_G_3V3: C160.1, F35.2, J56.3
SLOT_G_5V: F34.2, J56.5
SLOT_G_AUX: F36.2, J56.7
SLOT_G_PIN_VOLTAGE: C159.1, F33.2, J56.1
SLOT_H_3V3: C162.1, F39.2, J65.3
SLOT_H_5V: F38.2, J65.5
SLOT_H_AUX: F40.2, J65.7
SLOT_H_PIN_VOLTAGE: C161.1, F37.2, J65.1
SLOT_L_3V3: C144.1, F3.2, J57.3
SLOT_L_5V: F2.2, J57.5
SLOT_L_AUX: F4.2, J57.7
SLOT_L_PIN_VOLTAGE: C143.1, F1.2, J57.1
SLOT_M_3V3: C146.1, F7.2, J58.3
SLOT_M_5V: F6.2, J58.5
SLOT_M_AUX: F8.2, J58.7
SLOT_M_PIN_VOLTAGE: C145.1, F5.2, J58.1
VCCIO_1: C163.1, C164.1, J19.2, J19.4, J19.6; also elsewhere on the board
VCCIO_1_EXT: F9.1, F13.1, F17.1, F21.1; also elsewhere on the board
VCCIO_2: C165.1, C166.1, J20.2, J20.4, J20.6; also elsewhere on the board
VCCIO_2_EXT: F25.1, F29.1, F33.1, F37.1; also elsewhere on the board

Notes on the sheet:
SLOTS — Ten keyed extension ports, branch fusing and level shifting — HW 0.1.0-proto.1
5V BUS 0 converter
Lets the FPGA (3.3 V) talk to 5 V extensions on slot L. U9 shifts eight lines between 3.3 V and 5 V, all in one direction at a time (BUS5V0_DIR). It stays off until the FPGA pulls BUS5V0_OE_N low; the pull-up keeps the bus off while the FPGA is still loading.
5V BUS 1 converter
Same as 5V BUS 0, for slot M: U10 shifts eight lines between the FPGA's 3.3 V and 5 V, direction BUS5V1_DIR, off until BUS5V1_OE_N goes low.
SHIELD HEADER ABCD
One long 2x32 socket on the right edge carrying the signals of slots A, B, C and D: twelve FPGA pins each (bank 15), with grounds between groups. Their voltage is whatever J19 selects.
SHIELD HEADER EFGH
One long 2x32 socket on the left edge carrying the signals of slots E, F, G and H: twelve FPGA pins each (bank 34), voltage set by J20.
SHIELD HEADER L
The signal socket of slot L (5V BUS 0): eight 5 V data lines from U9, with four grounds between them.
SHIELD HEADER M
The signal socket of slot M (5V BUS 1): eight 5 V data lines from U10, with four grounds between them.
SLOT L branches
Power for whatever is plugged into slot L. The 1x7 power socket carries PIN V (3.3 V), 3.3 V, 5 V and AUX, each beside a ground, and each through its own resettable fuse, so a short on one extension trips only that slot's fuse and the rest of the board keeps running. The long grounded pin in front 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
SLOT M branches
Power for whatever is plugged into slot M. The 1x7 power socket carries PIN V (3.3 V), 3.3 V, 5 V and AUX, each beside a ground, and each through its own resettable fuse, so a short on one extension trips only that slot's fuse and the rest of the board keeps running. The long grounded pin in front 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
SLOT A branches
Power for whatever is plugged into slot A. The 1x7 power socket carries PIN V (the J19 voltage), 3.3 V, 5 V and AUX, each beside a ground, and each through its own resettable fuse, so a short on one extension trips only that slot's fuse and the rest of the board keeps running. The long grounded pin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
SLOT B branches
Power for whatever is plugged into slot B. The 1x7 power socket carries PIN V (the J19 voltage), 3.3 V, 5 V and AUX, each beside a ground, and each through its own resettable fuse, so a short on one extension trips only that slot's fuse and the rest of the board keeps running. The long grounded pin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
SLOT C branches
Power for whatever is plugged into slot C. The 1x7 power socket carries PIN V (the J19 voltage), 3.3 V, 5 V and AUX, each beside a ground, and each through its own resettable fuse, so a short on one extension trips only that slot's fuse and the rest of the board keeps running. The long grounded pin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
SLOT D branches
Power for whatever is plugged into slot D. The 1x7 power socket carries PIN V (the J19 voltage), 3.3 V, 5 V and AUX, each beside a ground, and each through its own resettable fuse, so a short on one extension trips only that slot's fuse and the rest of the board keeps running. The long grounded pin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
SLOT E branches
Power for whatever is plugged into slot E. The 1x7 power socket carries PIN V (the J20 voltage), 3.3 V, 5 V and AUX, each beside a ground, and each through its own resettable fuse, so a short on one extension trips only that slot's fuse and the rest of the board keeps running. The long grounded pin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
SLOT F branches
Power for whatever is plugged into slot F. The 1x7 power socket carries PIN V (the J20 voltage), 3.3 V, 5 V and AUX, each beside a ground, and each through its own resettable fuse, so a short on one extension trips only that slot's fuse and the rest of the board keeps running. The long grounded pin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
SLOT G branches
Power for whatever is plugged into slot G. The 1x7 power socket carries PIN V (the J20 voltage), 3.3 V, 5 V and AUX, each beside a ground, and each through its own resettable fuse, so a short on one extension trips only that slot's fuse and the rest of the board keeps running. The long grounded pin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
SLOT H branches
Power for whatever is plugged into slot H. The 1x7 power socket carries PIN V (the J20 voltage), 3.3 V, 5 V and AUX, each beside a ground, and each through its own resettable fuse, so a short on one extension trips only that slot's fuse and the rest of the board keeps running. The long grounded pin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
VCCIO_1 selector
Jumper that picks the signal voltage of slots A-D: one shunt on J19 selects 3.3, 2.5 or 1.8 V. It powers FPGA bank 15 and the PIN V pin of those four slots. One position only; change it with the board unpowered.
VCCIO_2 selector
Jumper that picks the signal voltage of slots E-H (J20): 3.3, 2.5 or 1.8 V for FPGA bank 34 and those slots' PIN V pin.
Power flags for the rails made on this page
