bcarbone24/freyja/kicad/odin.kicad_pcb

## KiCad design kicad/odin.kicad_pcb (continued)

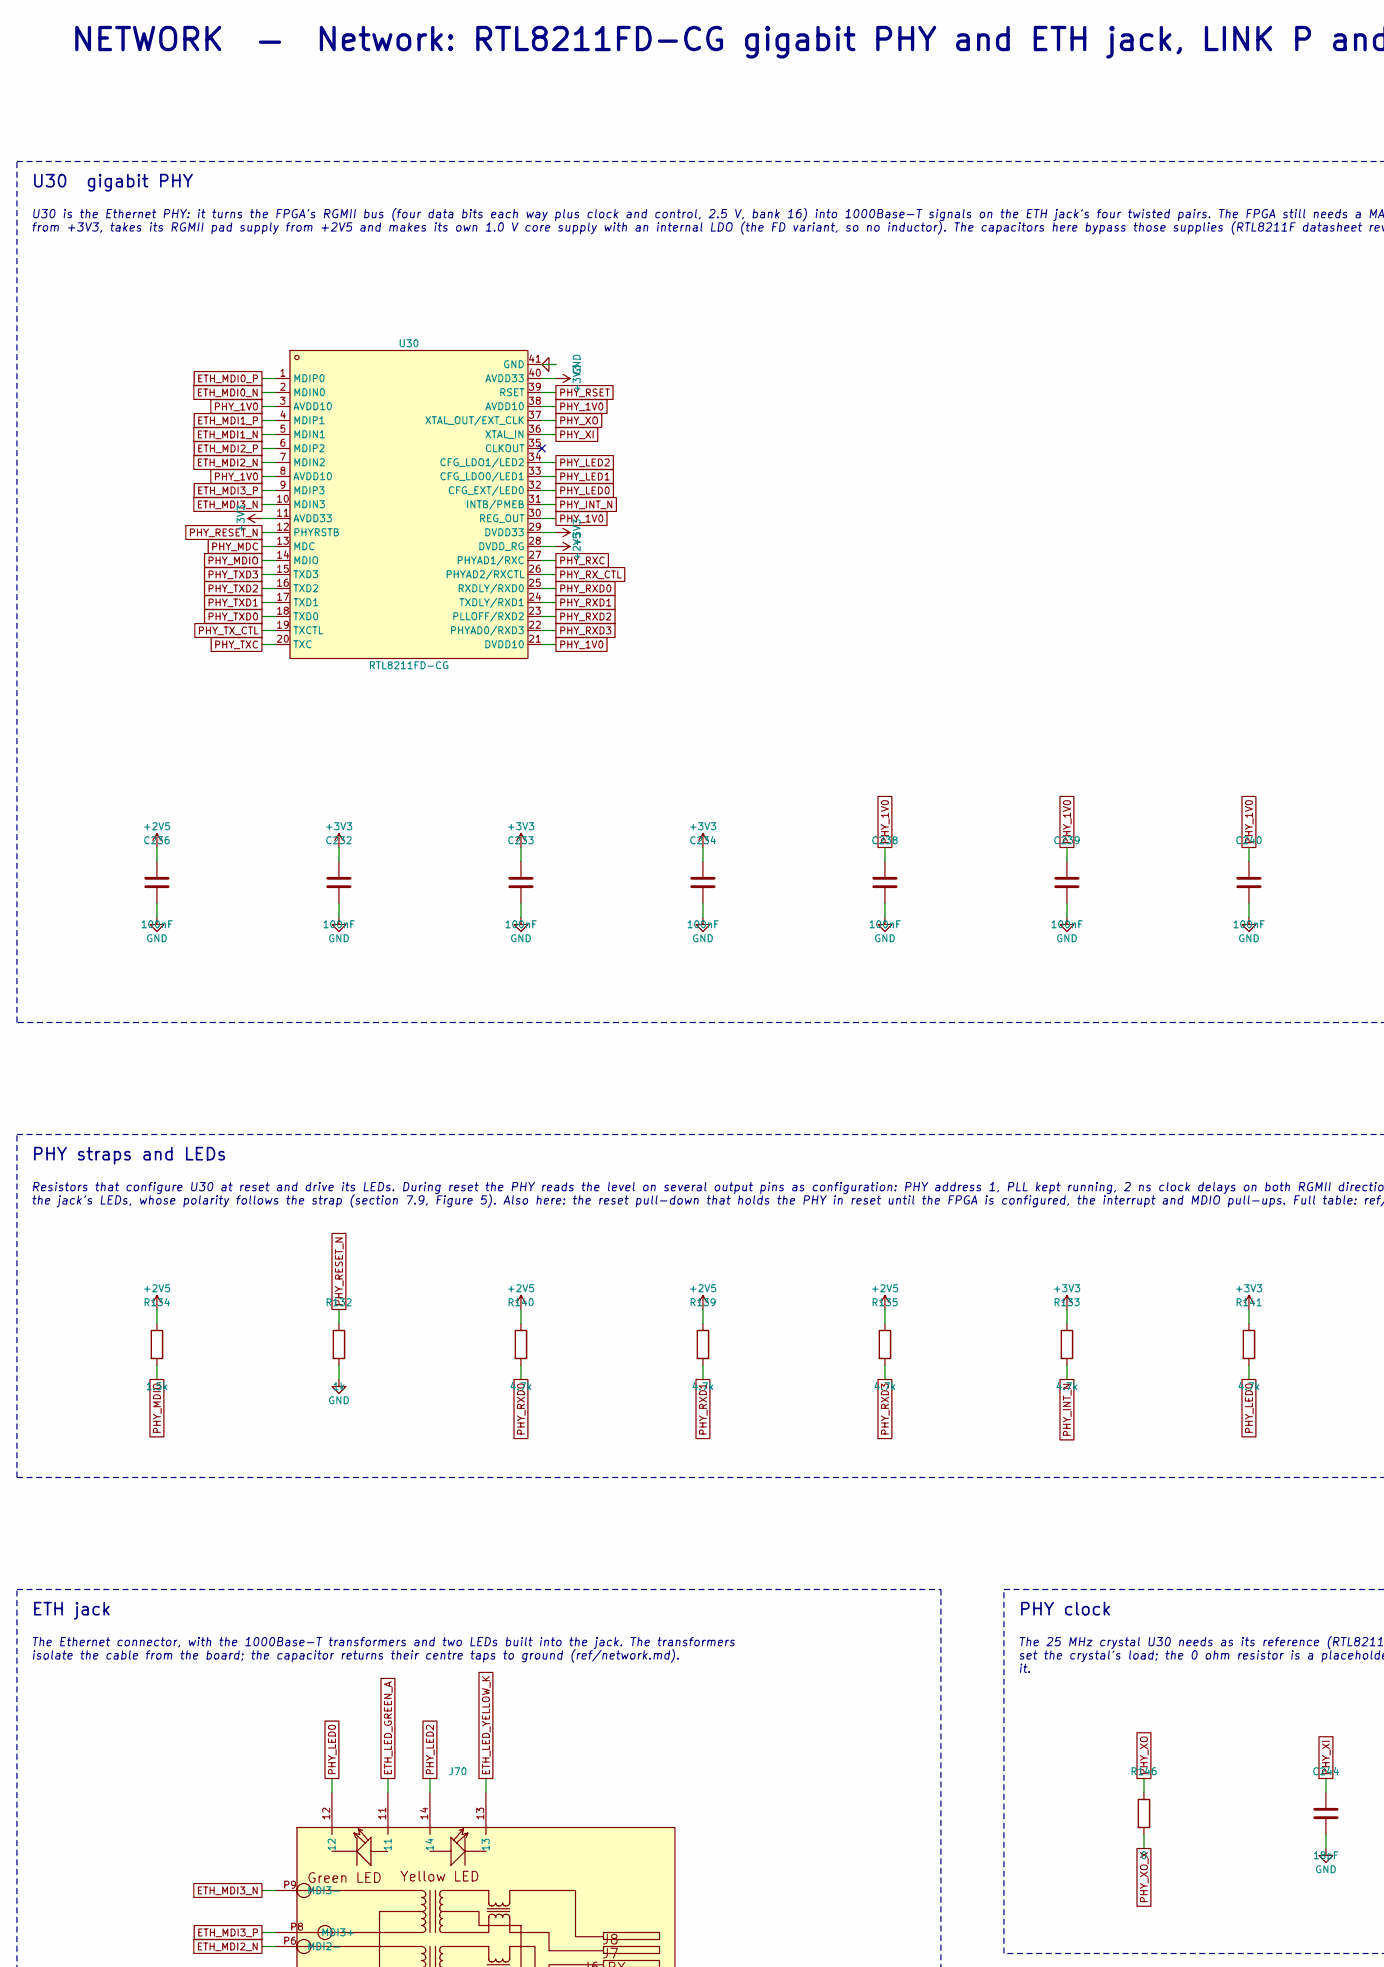
[picture p2: schematic network.kicad_sch, part in row 1, column 1]

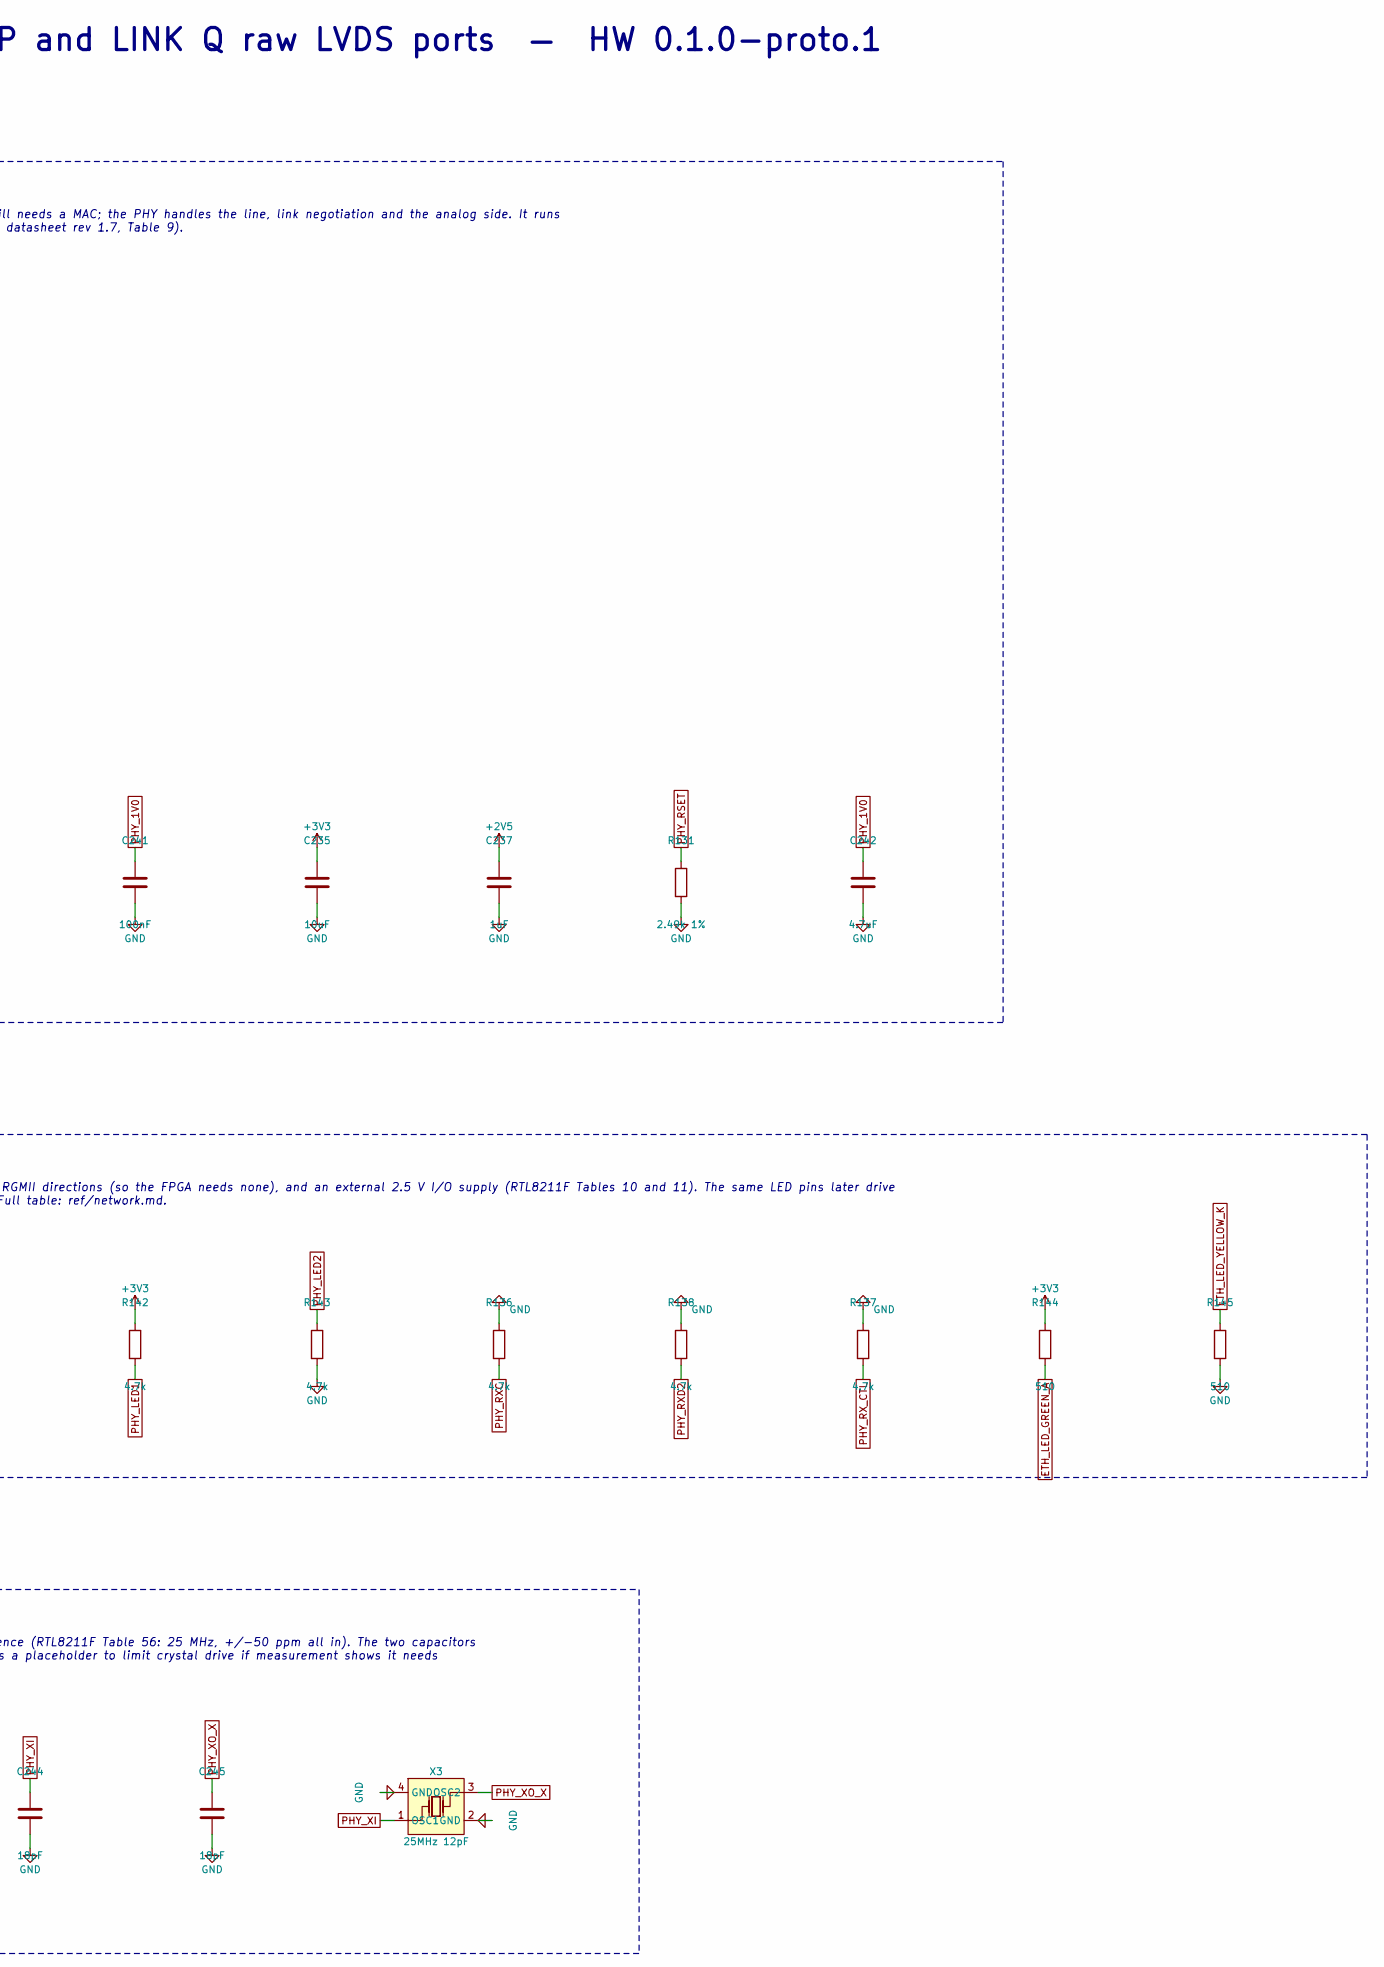
[picture p3: schematic network.kicad_sch, part in row 1, column 2]

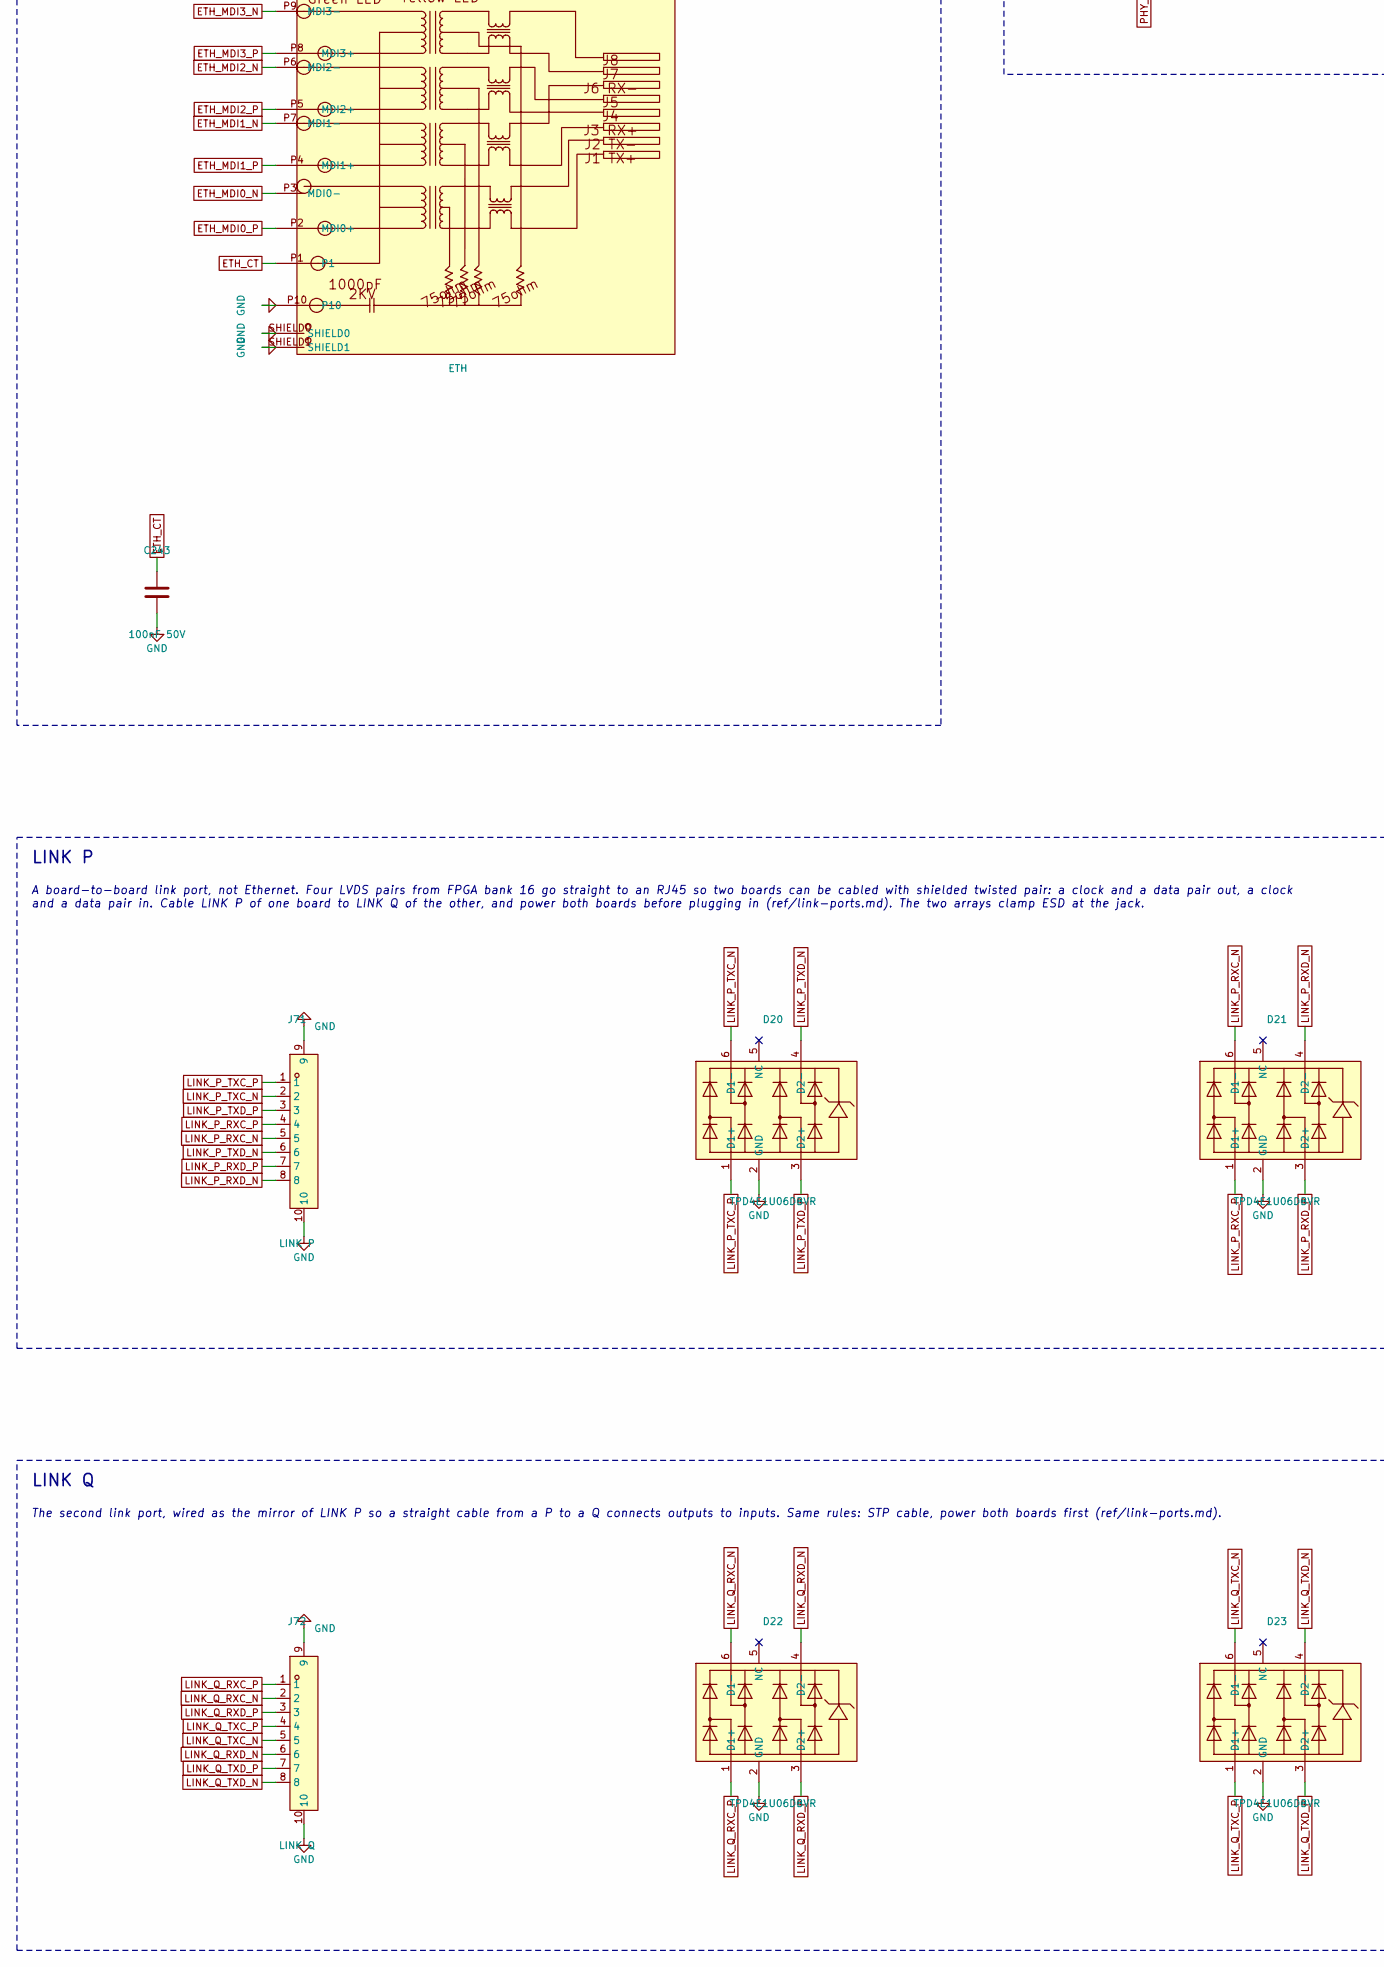
[picture p4: schematic network.kicad_sch, part in row 2, column 1]

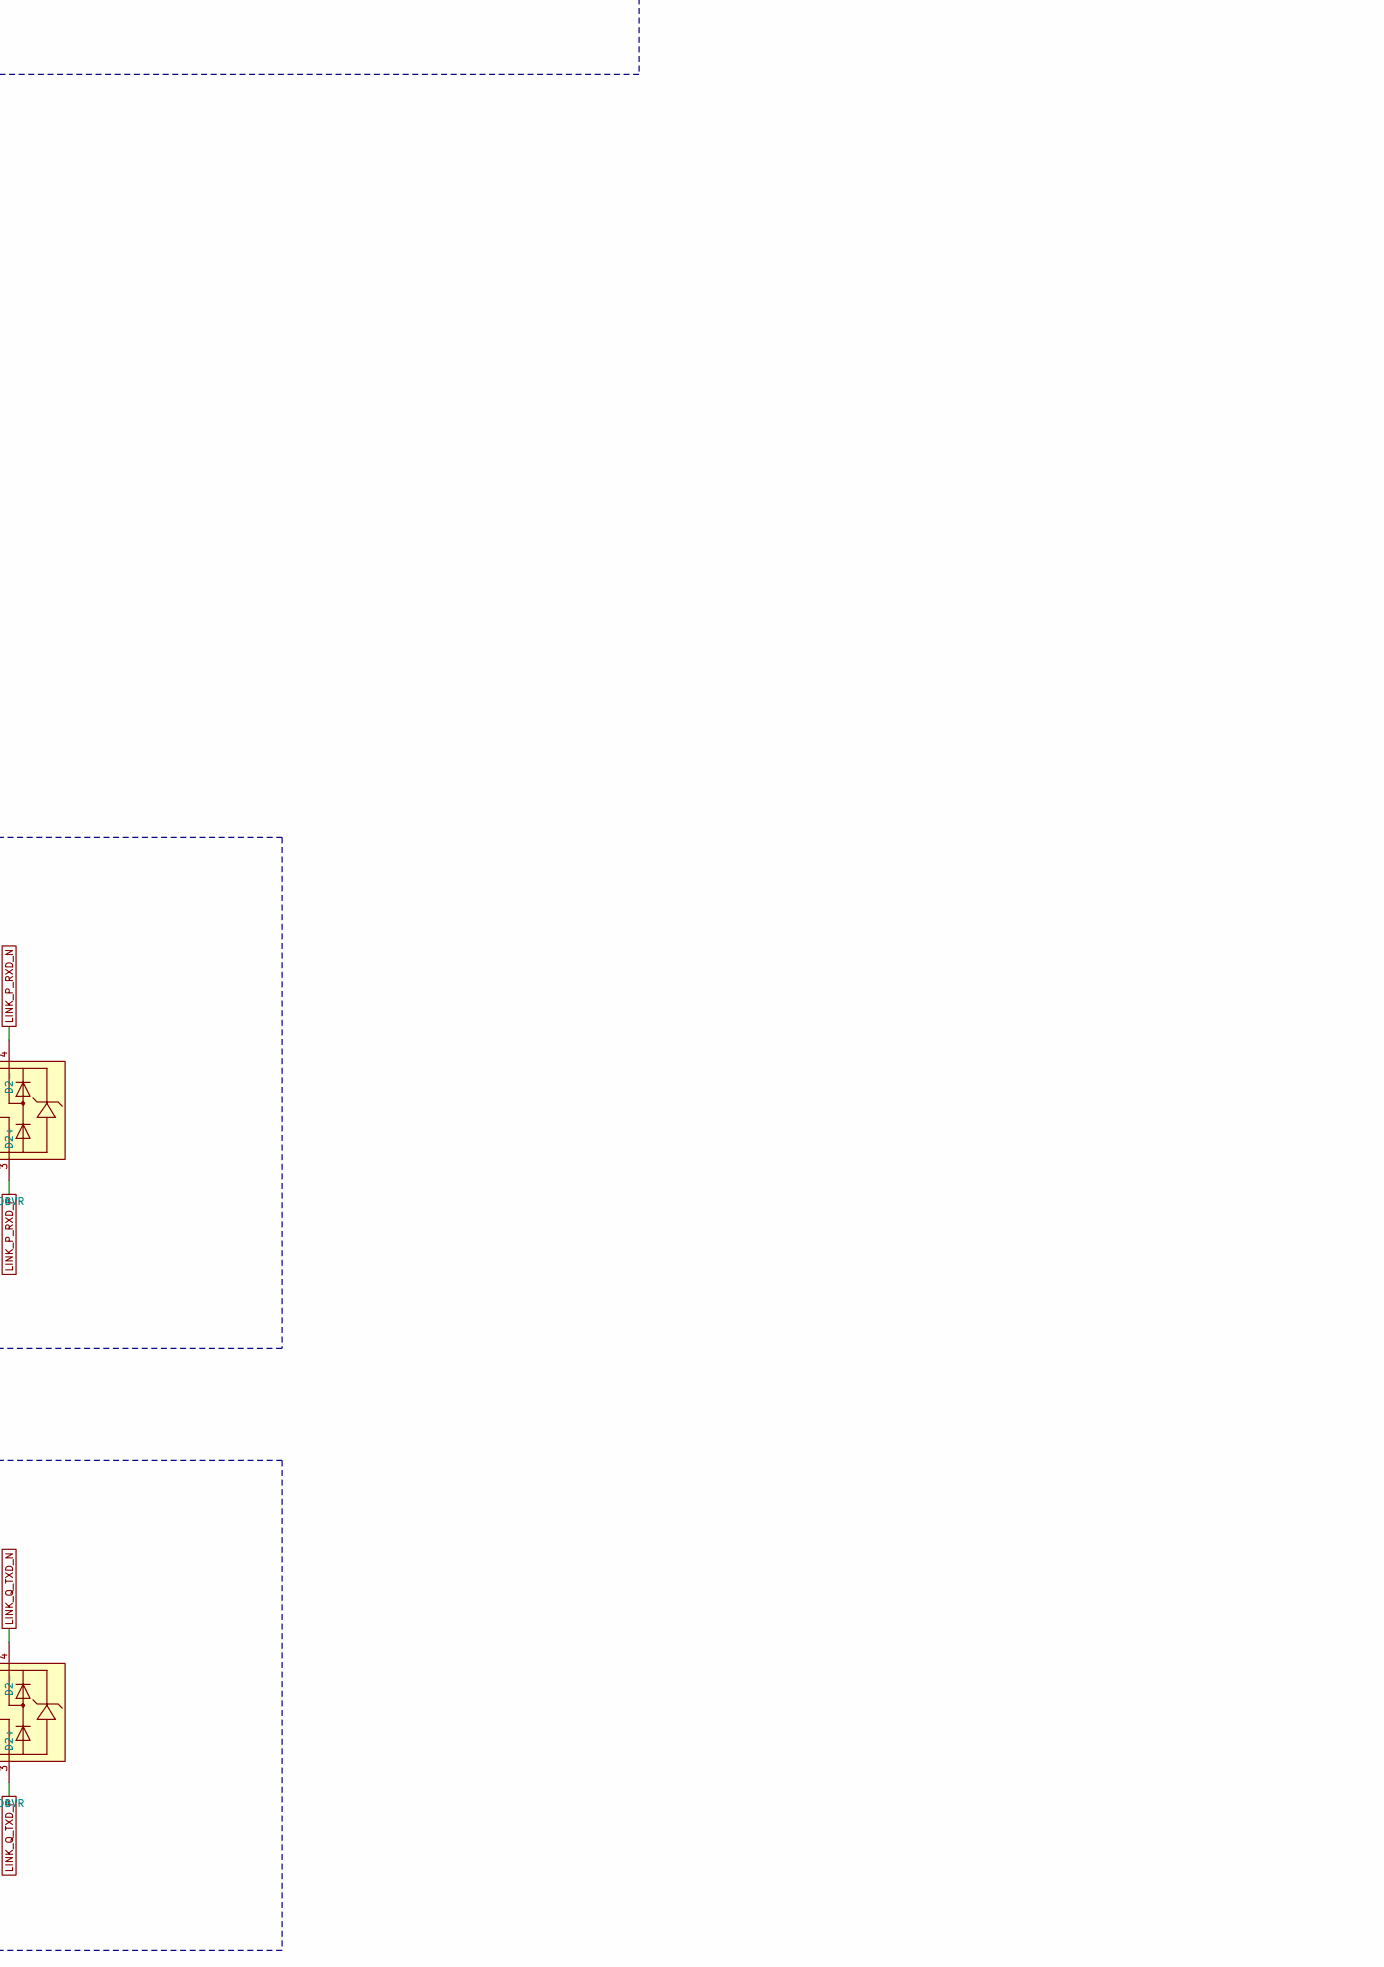
[picture p5: schematic network.kicad_sch, part in row 2, column 2]

Parts:
C232, C233, C234, C236, C238, C239, C240, C241: 100nF; C_0402_1005Metric; LCSC C1525
C235: 10uF; C_0805_2012Metric; LCSC C15850
C237: 1uF; C_0603_1608Metric; LCSC C29936
C242: 4.7uF; C_0603_1608Metric; LCSC C277476
C243: 100nF 50V; C_0603_1608Metric
C244, C245: 18pF; C_0402_1005Metric
D20, D21, D22, D23: TPD4E1U06DBVR; SOT-23-6_L2.9-W1.6-P0.95-LS2.8-BR_TPD4E1U06; LCSC C124691
J70: ETH; RJ45-TH_HR911130A; LCSC C54408
J71: LINK P; RJ45-TH_KH-RJ45-58-8P8C; LCSC C2683360
J72: LINK Q; RJ45-TH_KH-RJ45-58-8P8C; LCSC C2683360
R131: 2.49k 1%; R_0402_1005Metric
R132: 1k; R_0402_1005Metric; LCSC C11702
R133, R135, R136, R137, R138, R139, R140, R141, R142, R143: 4.7k; R_0402_1005Metric; LCSC C25900
R134: 1.5k; R_0402_1005Metric
R144, R145: 510; R_0402_1005Metric
R146: 0; R_0402_1005Metric
U30: RTL8211FD-CG; QFN-40_L5.0-W5.0-P0.40-BL-EP3.7; LCSC C2687133
X3: 25MHz 12pF; CRYSTAL-SMD_4P-L3.2-W2.5-BL_X3225; LCSC C9006

Connections:
+2V5: C236.1, C237.1, R134.1, R135.1, R139.1, R140.1, U30.28 (DVDD_RG); also elsewhere on the board
+3V3: C232.1, C233.1, C234.1, C235.1, R133.1, R141.1, R142.1, R144.1, U30.11 (AVDD33), U30.29 (DVDD33), U30.40 (AVDD33); also elsewhere on the board
ETH_CT: C243.1, J70.P1
ETH_LED_GREEN_A: J70.11, R144.2
ETH_LED_YELLOW_K: J70.13, R145.1
ETH_MDI0_N: J70.P3 (MDI0-), U30.2 (MDIN0)
ETH_MDI0_P: J70.P2 (MDI0+), U30.1 (MDIP0)
ETH_MDI1_N: J70.P7 (MDI1-), U30.5 (MDIN1)
ETH_MDI1_P: J70.P4 (MDI1+), U30.4 (MDIP1)
ETH_MDI2_N: J70.P6 (MDI2-), U30.7 (MDIN2)
ETH_MDI2_P: J70.P5 (MDI2+), U30.6 (MDIP2)
ETH_MDI3_N: J70.P9 (MDI3-), U30.10 (MDIN3)
ETH_MDI3_P: J70.P8 (MDI3+), U30.9 (MDIP3)
GND: C232.2, C233.2, C234.2, C235.2, C236.2, C237.2, C238.2, C239.2, C240.2, C241.2, C242.2, C243.2, C244.2, C245.2, D20.2 (GND), D21.2 (GND), D22.2 (GND), D23.2 (GND), J70.P10, J70.SHIELD0, J70.SHIELD1, J71.9, J71.10, J72.9, J72.10, R131.2, R132.2, R136.1, R137.1, R138.1, R143.2, R145.2, U30.41 (GND), X3.2 (GND), X3.4 (GND); also elsewhere on the board
LINK_P_RXC_N: D21.6 (D1-), J71.5; also elsewhere on the board
LINK_P_RXC_P: D21.1 (D1+), J71.4; also elsewhere on the board
LINK_P_RXD_N: D21.4 (D2-), J71.8; also elsewhere on the board
LINK_P_RXD_P: D21.3 (D2+), J71.7; also elsewhere on the board
LINK_P_TXC_N: D20.6 (D1-), J71.2; also elsewhere on the board
LINK_P_TXC_P: D20.1 (D1+), J71.1; also elsewhere on the board
LINK_P_TXD_N: D20.4 (D2-), J71.6; also elsewhere on the board
LINK_P_TXD_P: D20.3 (D2+), J71.3; also elsewhere on the board
LINK_Q_RXC_N: D22.6 (D1-), J72.2; also elsewhere on the board
LINK_Q_RXC_P: D22.1 (D1+), J72.1; also elsewhere on the board
LINK_Q_RXD_N: D22.4 (D2-), J72.6; also elsewhere on the board
LINK_Q_RXD_P: D22.3 (D2+), J72.3; also elsewhere on the board
LINK_Q_TXC_N: D23.6 (D1-), J72.5; also elsewhere on the board
LINK_Q_TXC_P: D23.1 (D1+), J72.4; also elsewhere on the board
LINK_Q_TXD_N: D23.4 (D2-), J72.8; also elsewhere on the board
LINK_Q_TXD_P: D23.3 (D2+), J72.7; also elsewhere on the board
PHY_1V0: C238.1, C239.1, C240.1, C241.1, C242.1, U30.3 (AVDD10), U30.8 (AVDD10), U30.21 (DVDD10), U30.30 (REG_OUT), U30.38 (AVDD10)
PHY_INT_N: R133.2, U30.31 (INTB/PMEB); also elsewhere on the board
PHY_LED0: J70.12, R141.2, U30.32 (CFG_EXT/LED0)
PHY_LED1: R142.2, U30.33 (CFG_LDO0/LED1)
PHY_LED2: J70.14, R143.1, U30.34 (CFG_LDO1/LED2)
PHY_MDC: U30.13 (MDC); also elsewhere on the board
PHY_MDIO: R134.2, U30.14 (MDIO); also elsewhere on the board
PHY_RESET_N: R132.1, U30.12 (PHYRSTB); also elsewhere on the board
PHY_RSET: R131.1, U30.39 (RSET)
PHY_RXC: R136.2, U30.27 (PHYAD1/RXC); also elsewhere on the board
PHY_RXD0: R140.2, U30.25 (RXDLY/RXD0); also elsewhere on the board
PHY_RXD1: R139.2, U30.24 (TXDLY/RXD1); also elsewhere on the board
PHY_RXD2: R138.2, U30.23 (PLLOFF/RXD2); also elsewhere on the board
PHY_RXD3: R135.2, U30.22 (PHYAD0/RXD3); also elsewhere on the board
PHY_RX_CTL: R137.2, U30.26 (PHYAD2/RXCTL); also elsewhere on the board
PHY_TXC: U30.20 (TXC); also elsewhere on the board
PHY_TXD0: U30.18 (TXD0); also elsewhere on the board
PHY_TXD1: U30.17 (TXD1); also elsewhere on the board
PHY_TXD2: U30.16 (TXD2); also elsewhere on the board
PHY_TXD3: U30.15 (TXD3); also elsewhere on the board
PHY_TX_CTL: U30.19 (TXCTL); also elsewhere on the board
PHY_XI: C244.1, U30.36 (XTAL_IN), X3.1 (OSC1)
PHY_XO: R146.1, U30.37 (XTAL_OUT/EXT_CLK)
PHY_XO_X: C245.1, R146.2, X3.3 (OSC2)

Notes on the sheet:
NETWORK — Network: RTL8211FD-CG gigabit PHY and ETH jack, LINK P and LINK Q raw LVDS ports — HW 0.1.0-proto.1
U30 gigabit PHY
U30 is the Ethernet PHY: it turns the FPGA's RGMII bus (four data bits each way plus clock and control, 2.5 V, bank 16) into 1000Base-T signals on the ETH jack's four twisted pairs. The FPGA still needs a MAC; the PHY handles the line, link negotiation and the analog side. It runs from +3V3, takes 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
PHY straps and LEDs
Resistors that configure U30 at reset and drive its LEDs. During reset the PHY reads the level on several output pins as configuration: PHY address 1, PLL kept running, 2 ns clock delays on both RGMII directions (so the FPGA needs none), and an external 2.5 V I/O supply (RTL8211F Tables 10 and 11).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
ETH jack
The Ethernet connector, with the 1000Base-T transformers and two LEDs built into the jack. The transformers isolate the cable from the board; the capacitor returns their centre taps to ground (ref/network.md).
PHY clock
The 25 MHz crystal U30 needs as its reference (RTL8211F Table 56: 25 MHz, +/-50 ppm all in). The two capacitors set the crystal's load; the 0 ohm resistor is a placeholder to limit crystal drive if measurement shows it needs it.
LINK P
A board-to-board link port, not Ethernet. Four LVDS pairs from FPGA bank 16 go straight to an RJ45 so two boards can be cabled with shielded twisted pair: a clock and a data pair out, a clock and a data pair in. Cable LINK P of one board to LINK Q of the other, and power both boards before plugging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
LINK Q
The second link port, wired as the mirror of LINK P so a straight cable from a P to a Q connects outputs to inputs. Same rules: STP cable, power both boards first (ref/link-ports.md).

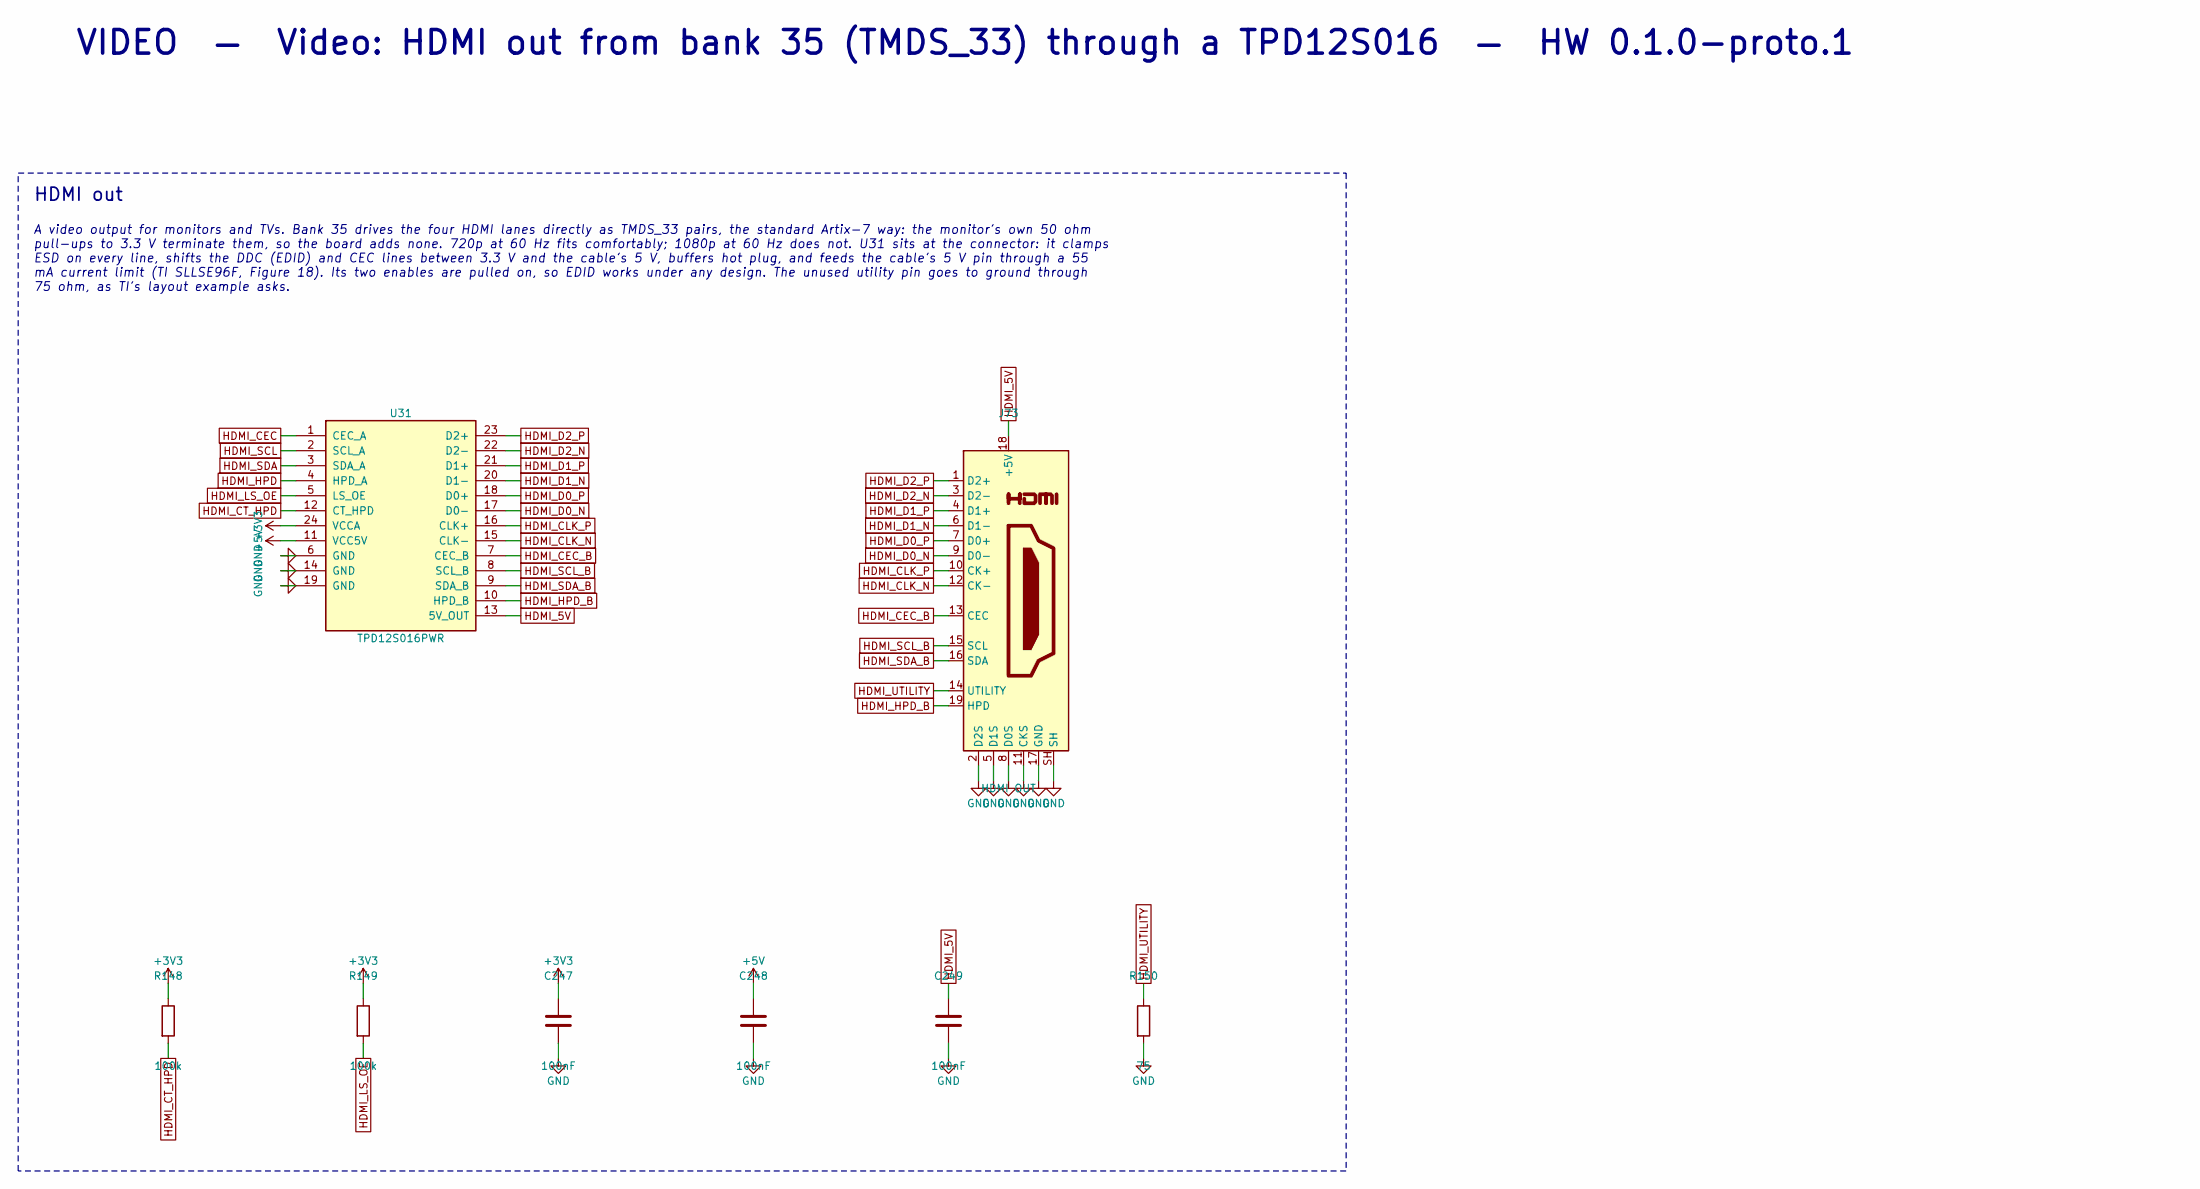
[picture p6: schematic video.kicad_sch]

Parts:
C247, C248, C249: 100nF; C_0402_1005Metric; LCSC C1525
J73: HDMI OUT; HDMI_A_Amphenol_10029449-x01xLF_Horizontal; LCSC C428493
R148, R149: 100k; R_0402_1005Metric; LCSC C25741
R150: 75; R_0402_1005Metric
U31: TPD12S016PWR; TSSOP-24_4.4x7.8mm_P0.65mm; LCSC C201665

Connections:
+3V3: C247.1, R148.1, R149.1, U31.24 (VCCA); also elsewhere on the board
+5V: C248.1, U31.11 (VCC5V); also elsewhere on the board
GND: C247.2, C248.2, C249.2, J73.2 (D2S), J73.5 (D1S), J73.8 (D0S), J73.11 (CKS), J73.17 (GND), J73.SH, R150.2, U31.6 (GND), U31.14 (GND), U31.19 (GND); also elsewhere on the board
HDMI_5V: C249.1, J73.18 (+5V), U31.13 (5V_OUT)
HDMI_CEC: U31.1 (CEC_A); also elsewhere on the board
HDMI_CEC_B: J73.13 (CEC), U31.7 (CEC_B)
HDMI_CLK_N: J73.12 (CK-), U31.15 (CLK-); also elsewhere on the board
HDMI_CLK_P: J73.10 (CK+), U31.16 (CLK+); also elsewhere on the board
HDMI_CT_HPD: R148.2, U31.12 (CT_HPD); also elsewhere on the board
HDMI_D0_N: J73.9 (D0-), U31.17 (D0-); also elsewhere on the board
HDMI_D0_P: J73.7 (D0+), U31.18 (D0+); also elsewhere on the board
HDMI_D1_N: J73.6 (D1-), U31.20 (D1-); also elsewhere on the board
HDMI_D1_P: J73.4 (D1+), U31.21 (D1+); also elsewhere on the board
HDMI_D2_N: J73.3 (D2-), U31.22 (D2-); also elsewhere on the board
HDMI_D2_P: J73.1 (D2+), U31.23 (D2+); also elsewhere on the board
HDMI_HPD: U31.4 (HPD_A); also elsewhere on the board
HDMI_HPD_B: J73.19 (HPD), U31.10 (HPD_B)
HDMI_LS_OE: R149.2, U31.5 (LS_OE); also elsewhere on the board
HDMI_SCL: U31.2 (SCL_A); also elsewhere on the board
HDMI_SCL_B: J73.15 (SCL), U31.8 (SCL_B)
HDMI_SDA: U31.3 (SDA_A); also elsewhere on the board
HDMI_SDA_B: J73.16 (SDA), U31.9 (SDA_B)
HDMI_UTILITY: J73.14 (UTILITY), R150.1

Notes on the sheet:
VIDEO — Video: HDMI out from bank 35 (TMDS_33) through a TPD12S016 — HW 0.1.0-proto.1
HDMI out
A video output for monitors and TVs. Bank 35 drives the four HDMI lanes directly as TMDS_33 pairs, the standard Artix-7 way: the monitor's own 50 ohm pull-ups to 3.3 V terminate them, so the board adds none. 720p at 60 Hz fits comfortably; 1080p at 60 Hz does not. U31 sits at the connector: it clam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

Board: 8 copper layers, 548 parts (0 on the bottom side), 497 nets, no tracks yet.
