bcarbone24/freyja/.Xil/top_propImpl.xdc

set_property SRC_FILE_INFO {cfile:/home/ohenley/freyja/ref/freya.xdc rfile:../ref/freya.xdc id:1} [current_design]
set_property src_info {type:XDC file:1 line:15 export:INPUT save:INPUT read:READ} [current_design]
set_property -dict {PACKAGE_PIN U24 IOSTANDARD LVCMOS18} [get_ports {BUS5V0_DIR}]   ;# bank 13 IO_0_13
set_property src_info {type:XDC file:1 line:16 export:INPUT save:INPUT read:READ} [current_design]
set_property -dict {PACKAGE_PIN V26 IOSTANDARD LVCMOS18} [get_ports {BUS5V0_IO0}]   ;# bank 13 IO_L2P_T0_13
set_property src_info {type:XDC file:1 line:17 export:INPUT save:INPUT read:READ} [current_design]
set_property -dict {PACKAGE_PIN W26 IOSTANDARD LVCMOS18} [get_ports {BUS5V0_IO1}]   ;# bank 13 IO_L2N_T0_13
set_property src_info {type:XDC file:1 line:18 export:INPUT save:INPUT read:READ} [current_design]
set_property -dict {PACKAGE_PIN AB26 IOSTANDARD LVCMOS18} [get_ports {BUS5V0_IO2}]   ;# bank 13 IO_L3P_T0_DQS_13
set_property src_info {type:XDC file:1 line:19 export:INPUT save:INPUT read:READ} [current_design]
set_property -dict {PACKAGE_PIN AC26 IOSTANDARD LVCMOS18} [get_ports {BUS5V0_IO3}]   ;# bank 13 IO_L3N_T0_DQS_13
set_property src_info {type:XDC file:1 line:20 export:INPUT save:INPUT read:READ} [current_design]
set_property -dict {PACKAGE_PIN U25 IOSTANDARD LVCMOS18} [get_ports {BUS5V0_IO4}]   ;# bank 13 IO_L1P_T0_13
set_property src_info {type:XDC file:1 line:21 export:INPUT save:INPUT read:READ} [current_design]
set_property -dict {PACKAGE_PIN U26 IOSTANDARD LVCMOS18} [get_ports {BUS5V0_IO5}]   ;# bank 13 IO_L1N_T0_13
set_property src_info {type:XDC file:1 line:22 export:INPUT save:INPUT read:READ} [current_design]
set_property -dict {PACKAGE_PIN W25 IOSTANDARD LVCMOS18} [get_ports {BUS5V0_IO6}]   ;# bank 13 IO_L4P_T0_13
set_property src_info {type:XDC file:1 line:23 export:INPUT save:INPUT read:READ} [current_design]
set_property -dict {PACKAGE_PIN Y26 IOSTANDARD LVCMOS18} [get_ports {BUS5V0_IO7}]   ;# bank 13 IO_L4N_T0_13
set_property src_info {type:XDC file:1 line:24 export:INPUT save:INPUT read:READ} [current_design]
set_property -dict {PACKAGE_PIN V23 IOSTANDARD LVCMOS18} [get_ports {BUS5V0_OE_N}]   ;# bank 13 IO_L10P_T1_13
set_property src_info {type:XDC file:1 line:26 export:INPUT save:INPUT read:READ} [current_design]
set_property -dict {PACKAGE_PIN U17 IOSTANDARD LVCMOS18} [get_ports {BUS5V1_DIR}]   ;# bank 13 IO_25_13
set_property src_info {type:XDC file:1 line:27 export:INPUT save:INPUT read:READ} [current_design]
set_property -dict {PACKAGE_PIN Y25 IOSTANDARD LVCMOS18} [get_ports {BUS5V1_IO0}]   ;# bank 13 IO_L5P_T0_13
set_property src_info {type:XDC file:1 line:28 export:INPUT save:INPUT read:READ} [current_design]
set_property -dict {PACKAGE_PIN AA25 IOSTANDARD LVCMOS18} [get_ports {BUS5V1_IO1}]   ;# bank 13 IO_L5N_T0_13
set_property src_info {type:XDC file:1 line:29 export:INPUT save:INPUT read:READ} [current_design]
set_property -dict {PACKAGE_PIN V24 IOSTANDARD LVCMOS18} [get_ports {BUS5V1_IO2}]   ;# bank 13 IO_L6P_T0_13
set_property src_info {type:XDC file:1 line:30 export:INPUT save:INPUT read:READ} [current_design]
set_property -dict {PACKAGE_PIN W24 IOSTANDARD LVCMOS18} [get_ports {BUS5V1_IO3}]   ;# bank 13 IO_L6N_T0_VREF_13
set_property src_info {type:XDC file:1 line:31 export:INPUT save:INPUT read:READ} [current_design]
set_property -dict {PACKAGE_PIN AA24 IOSTANDARD LVCMOS18} [get_ports {BUS5V1_IO4}]   ;# bank 13 IO_L7P_T1_13
set_property src_info {type:XDC file:1 line:32 export:INPUT save:INPUT read:READ} [current_design]
set_property -dict {PACKAGE_PIN AB25 IOSTANDARD LVCMOS18} [get_ports {BUS5V1_IO5}]   ;# bank 13 IO_L7N_T1_13
set_property src_info {type:XDC file:1 line:33 export:INPUT save:INPUT read:READ} [current_design]
set_property -dict {PACKAGE_PIN AB24 IOSTANDARD LVCMOS18} [get_ports {BUS5V1_IO6}]   ;# bank 13 IO_L9P_T1_DQS_13
set_property src_info {type:XDC file:1 line:34 export:INPUT save:INPUT read:READ} [current_design]
set_property -dict {PACKAGE_PIN AC24 IOSTANDARD LVCMOS18} [get_ports {BUS5V1_IO7}]   ;# bank 13 IO_L9N_T1_DQS_13
set_property src_info {type:XDC file:1 line:35 export:INPUT save:INPUT read:READ} [current_design]
set_property -dict {PACKAGE_PIN W23 IOSTANDARD LVCMOS18} [get_ports {BUS5V1_OE_N}]   ;# bank 13 IO_L10N_T1_13
set_property src_info {type:XDC file:1 line:37 export:INPUT save:INPUT read:READ} [current_design]
set_property -dict {PACKAGE_PIN N21 IOSTANDARD LVCMOS33} [get_ports {DBG_TCK}]   ;# bank 14 IO_L13P_T2_MRCC_14
set_property src_info {type:XDC file:1 line:38 export:INPUT save:INPUT read:READ} [current_design]
set_property -dict {PACKAGE_PIN M20 IOSTANDARD LVCMOS33} [get_ports {DBG_TDI}]   ;# bank 14 IO_L8P_T1_D11_14
set_property src_info {type:XDC file:1 line:39 export:INPUT save:INPUT read:READ} [current_design]
set_property -dict {PACKAGE_PIN L20 IOSTANDARD LVCMOS33} [get_ports {DBG_TDO}]   ;# bank 14 IO_L8N_T1_D12_14
set_property src_info {type:XDC file:1 line:40 export:INPUT save:INPUT read:READ} [current_design]
set_property -dict {PACKAGE_PIN N22 IOSTANDARD LVCMOS33} [get_ports {DBG_TMS}]   ;# bank 14 IO_L13N_T2_MRCC_14
set_property src_info {type:XDC file:1 line:42 export:INPUT save:INPUT read:READ} [current_design]
set_property -dict {PACKAGE_PIN P18 IOSTANDARD LVCMOS33} [get_ports {FLASH_CS_B}]   ;# bank 14 IO_L6P_T0_FCS_B_14
set_property src_info {type:XDC file:1 line:43 export:INPUT save:INPUT read:READ} [current_design]
set_property -dict {PACKAGE_PIN R14 IOSTANDARD LVCMOS33} [get_ports {FLASH_D0_MOSI}]   ;# bank 14 IO_L1P_T0_D00_MOSI_14
set_property src_info {type:XDC file:1 line:44 export:INPUT save:INPUT read:READ} [current_design]
set_property -dict {PACKAGE_PIN R15 IOSTANDARD LVCMOS33} [get_ports {FLASH_D1_MISO}]   ;# bank 14 IO_L1N_T0_D01_DIN_14
set_property src_info {type:XDC file:1 line:45 export:INPUT save:INPUT read:READ} [current_design]
set_property -dict {PACKAGE_PIN P14 IOSTANDARD LVCMOS33} [get_ports {FLASH_D2_WP}]   ;# bank 14 IO_L2P_T0_D02_14
set_property src_info {type:XDC file:1 line:46 export:INPUT save:INPUT read:READ} [current_design]
set_property -dict {PACKAGE_PIN N14 IOSTANDARD LVCMOS33} [get_ports {FLASH_D3_HOLD}]   ;# bank 14 IO_L2N_T0_D03_14
set_property src_info {type:XDC file:1 line:48 export:INPUT save:INPUT read:READ} [current_design]
set_property -dict {PACKAGE_PIN B2 IOSTANDARD LVCMOS33} [get_ports {HDMI_CEC}]   ;# bank 35 IO_L19N_T3_VREF_35
set_property src_info {type:XDC file:1 line:49 export:INPUT save:INPUT read:READ} [current_design]
set_property -dict {PACKAGE_PIN A2 IOSTANDARD TMDS_33} [get_ports {HDMI_CLK_N}]   ;# bank 35 IO_L20N_T3_35
set_property src_info {type:XDC file:1 line:50 export:INPUT save:INPUT read:READ} [current_design]
set_property -dict {PACKAGE_PIN A3 IOSTANDARD TMDS_33} [get_ports {HDMI_CLK_P}]   ;# bank 35 IO_L20P_T3_35
set_property src_info {type:XDC file:1 line:51 export:INPUT save:INPUT read:READ} [current_design]
set_property -dict {PACKAGE_PIN F2 IOSTANDARD LVCMOS33} [get_ports {HDMI_CT_HPD}]   ;# bank 35 IO_L22P_T3_35
set_property src_info {type:XDC file:1 line:52 export:INPUT save:INPUT read:READ} [current_design]
set_property -dict {PACKAGE_PIN B1 IOSTANDARD TMDS_33} [get_ports {HDMI_D0_N}]   ;# bank 35 IO_L21N_T3_DQS_35
set_property src_info {type:XDC file:1 line:53 export:INPUT save:INPUT read:READ} [current_design]
set_property -dict {PACKAGE_PIN C1 IOSTANDARD TMDS_33} [get_ports {HDMI_D0_P}]   ;# bank 35 IO_L21P_T3_DQS_35
set_property src_info {type:XDC file:1 line:54 export:INPUT save:INPUT read:READ} [current_design]
set_property -dict {PACKAGE_PIN D1 IOSTANDARD TMDS_33} [get_ports {HDMI_D1_N}]   ;# bank 35 IO_L23N_T3_35
set_property src_info {type:XDC file:1 line:55 export:INPUT save:INPUT read:READ} [current_design]
set_property -dict {PACKAGE_PIN E1 IOSTANDARD TMDS_33} [get_ports {HDMI_D1_P}]   ;# bank 35 IO_L23P_T3_35
set_property src_info {type:XDC file:1 line:56 export:INPUT save:INPUT read:READ} [current_design]
set_property -dict {PACKAGE_PIN A5 IOSTANDARD TMDS_33} [get_ports {HDMI_D2_N}]   ;# bank 35 IO_L15N_T2_DQS_35
set_property src_info {type:XDC file:1 line:57 export:INPUT save:INPUT read:READ} [current_design]
set_property -dict {PACKAGE_PIN B5 IOSTANDARD TMDS_33} [get_ports {HDMI_D2_P}]   ;# bank 35 IO_L15P_T2_DQS_35
set_property src_info {type:XDC file:1 line:58 export:INPUT save:INPUT read:READ} [current_design]
set_property -dict {PACKAGE_PIN B4 IOSTANDARD LVCMOS33} [get_ports {HDMI_HPD}]   ;# bank 35 IO_L16P_T2_35
set_property src_info {type:XDC file:1 line:59 export:INPUT save:INPUT read:READ} [current_design]
set_property -dict {PACKAGE_PIN E2 IOSTANDARD LVCMOS33} [get_ports {HDMI_LS_OE}]   ;# bank 35 IO_L22N_T3_35
set_property src_info {type:XDC file:1 line:60 export:INPUT save:INPUT read:READ} [current_design]
set_property -dict {PACKAGE_PIN A4 IOSTANDARD LVCMOS33} [get_ports {HDMI_SCL}]   ;# bank 35 IO_L16N_T2_35
set_property src_info {type:XDC file:1 line:61 export:INPUT save:INPUT read:READ} [current_design]
set_property -dict {PACKAGE_PIN C2 IOSTANDARD LVCMOS33} [get_ports {HDMI_SDA}]   ;# bank 35 IO_L19P_T3_35
set_property src_info {type:XDC file:1 line:63 export:INPUT save:INPUT read:READ} [current_design]
set_property -dict {PACKAGE_PIN C18 IOSTANDARD LVDS_25} [get_ports {LINK_P_RXC_N}]   ;# bank 16 IO_L12N_T1_MRCC_16
set_property src_info {type:XDC file:1 line:65 export:INPUT save:INPUT read:READ} [current_design]
set_property -dict {PACKAGE_PIN D18 IOSTANDARD LVDS_25} [get_ports {LINK_P_RXC_P}]   ;# bank 16 IO_L12P_T1_MRCC_16
set_property src_info {type:XDC file:1 line:67 export:INPUT save:INPUT read:READ} [current_design]
set_property -dict {PACKAGE_PIN A18 IOSTANDARD LVDS_25} [get_ports {LINK_P_RXD_N}]   ;# bank 16 IO_L9N_T1_DQS_16
set_property src_info {type:XDC file:1 line:69 export:INPUT save:INPUT read:READ} [current_design]
set_property -dict {PACKAGE_PIN A17 IOSTANDARD LVDS_25} [get_ports {LINK_P_RXD_P}]   ;# bank 16 IO_L9P_T1_DQS_16
set_property src_info {type:XDC file:1 line:71 export:INPUT save:INPUT read:READ} [current_design]
set_property -dict {PACKAGE_PIN B26 IOSTANDARD LVDS_25} [get_ports {LINK_P_TXC_N}]   ;# bank 16 IO_L22N_T3_16
set_property src_info {type:XDC file:1 line:72 export:INPUT save:INPUT read:READ} [current_design]
set_property -dict {PACKAGE_PIN C26 IOSTANDARD LVDS_25} [get_ports {LINK_P_TXC_P}]   ;# bank 16 IO_L22P_T3_16
set_property src_info {type:XDC file:1 line:73 export:INPUT save:INPUT read:READ} [current_design]
set_property -dict {PACKAGE_PIN A24 IOSTANDARD LVDS_25} [get_ports {LINK_P_TXD_N}]   ;# bank 16 IO_L21N_T3_DQS_16
set_property src_info {type:XDC file:1 line:74 export:INPUT save:INPUT read:READ} [current_design]
set_property -dict {PACKAGE_PIN A23 IOSTANDARD LVDS_25} [get_ports {LINK_P_TXD_P}]   ;# bank 16 IO_L21P_T3_DQS_16
set_property src_info {type:XDC file:1 line:75 export:INPUT save:INPUT read:READ} [current_design]
set_property -dict {PACKAGE_PIN D20 IOSTANDARD LVDS_25} [get_ports {LINK_Q_RXC_N}]   ;# bank 16 IO_L14N_T2_SRCC_16
set_property src_info {type:XDC file:1 line:77 export:INPUT save:INPUT read:READ} [current_design]
set_property -dict {PACKAGE_PIN E20 IOSTANDARD LVDS_25} [get_ports {LINK_Q_RXC_P}]   ;# bank 16 IO_L14P_T2_SRCC_16
set_property src_info {type:XDC file:1 line:79 export:INPUT save:INPUT read:READ} [current_design]
set_property -dict {PACKAGE_PIN A20 IOSTANDARD LVDS_25} [get_ports {LINK_Q_RXD_N}]   ;# bank 16 IO_L15N_T2_DQS_16
set_property src_info {type:XDC file:1 line:81 export:INPUT save:INPUT read:READ} [current_design]
set_property -dict {PACKAGE_PIN B20 IOSTANDARD LVDS_25} [get_ports {LINK_Q_RXD_P}]   ;# bank 16 IO_L15P_T2_DQS_16
set_property src_info {type:XDC file:1 line:83 export:INPUT save:INPUT read:READ} [current_design]
set_property -dict {PACKAGE_PIN A25 IOSTANDARD LVDS_25} [get_ports {LINK_Q_TXC_N}]   ;# bank 16 IO_L20N_T3_16
set_property src_info {type:XDC file:1 line:84 export:INPUT save:INPUT read:READ} [current_design]
set_property -dict {PACKAGE_PIN B25 IOSTANDARD LVDS_25} [get_ports {LINK_Q_TXC_P}]   ;# bank 16 IO_L20P_T3_16
set_property src_info {type:XDC file:1 line:85 export:INPUT save:INPUT read:READ} [current_design]
set_property -dict {PACKAGE_PIN A22 IOSTANDARD LVDS_25} [get_ports {LINK_Q_TXD_N}]   ;# bank 16 IO_L17N_T2_16
set_property src_info {type:XDC file:1 line:86 export:INPUT save:INPUT read:READ} [current_design]
set_property -dict {PACKAGE_PIN B22 IOSTANDARD LVDS_25} [get_ports {LINK_Q_TXD_P}]   ;# bank 16 IO_L17P_T2_16
set_property src_info {type:XDC file:1 line:88 export:INPUT save:INPUT read:READ} [current_design]
set_property -dict {PACKAGE_PIN K25 IOSTANDARD LVCMOS33} [get_ports {MRAM_CS}]   ;# bank 14 IO_L7P_T1_D09_14
set_property src_info {type:XDC file:1 line:89 export:INPUT save:INPUT read:READ} [current_design]
set_property -dict {PACKAGE_PIN K26 IOSTANDARD LVCMOS33} [get_ports {MRAM_SCK}]   ;# bank 14 IO_L7N_T1_D10_14
set_property src_info {type:XDC file:1 line:90 export:INPUT save:INPUT read:READ} [current_design]
set_property -dict {PACKAGE_PIN L24 IOSTANDARD LVCMOS33} [get_ports {MRAM_SI}]   ;# bank 14 IO_L9P_T1_DQS_14
set_property src_info {type:XDC file:1 line:91 export:INPUT save:INPUT read:READ} [current_design]
set_property -dict {PACKAGE_PIN L25 IOSTANDARD LVCMOS33} [get_ports {MRAM_SO}]   ;# bank 14 IO_L9N_T1_DQS_D13_14
set_property src_info {type:XDC file:1 line:93 export:INPUT save:INPUT read:READ} [current_design]
set_property -dict {PACKAGE_PIN G2 IOSTANDARD LVCMOS33} [get_ports {PHY_INT_N}]   ;# bank 35 IO_L24P_T3_35
set_property src_info {type:XDC file:1 line:94 export:INPUT save:INPUT read:READ} [current_design]
set_property -dict {PACKAGE_PIN C17 IOSTANDARD LVCMOS25} [get_ports {PHY_MDC}]   ;# bank 16 IO_L7P_T1_16
set_property src_info {type:XDC file:1 line:95 export:INPUT save:INPUT read:READ} [current_design]
set_property -dict {PACKAGE_PIN B17 IOSTANDARD LVCMOS25} [get_ports {PHY_MDIO}]   ;# bank 16 IO_L7N_T1_16
set_property src_info {type:XDC file:1 line:96 export:INPUT save:INPUT read:READ} [current_design]
set_property -dict {PACKAGE_PIN G1 IOSTANDARD LVCMOS33} [get_ports {PHY_RESET_N}]   ;# bank 35 IO_L24N_T3_35
set_property src_info {type:XDC file:1 line:97 export:INPUT save:INPUT read:READ} [current_design]
set_property -dict {PACKAGE_PIN D19 IOSTANDARD LVCMOS25} [get_ports {PHY_RXC}]   ;# bank 16 IO_L13P_T2_MRCC_16
set_property src_info {type:XDC file:1 line:98 export:INPUT save:INPUT read:READ} [current_design]
set_property -dict {PACKAGE_PIN C19 IOSTANDARD LVCMOS25} [get_ports {PHY_RXD0}]   ;# bank 16 IO_L13N_T2_MRCC_16
set_property src_info {type:XDC file:1 line:99 export:INPUT save:INPUT read:READ} [current_design]
set_property -dict {PACKAGE_PIN H17 IOSTANDARD LVCMOS25} [get_ports {PHY_RXD1}]   ;# bank 16 IO_0_16
set_property src_info {type:XDC file:1 line:100 export:INPUT save:INPUT read:READ} [current_design]
set_property -dict {PACKAGE_PIN E22 IOSTANDARD LVCMOS25} [get_ports {PHY_RXD2}]   ;# bank 16 IO_25_16
set_property src_info {type:XDC file:1 line:101 export:INPUT save:INPUT read:READ} [current_design]
set_property -dict {PACKAGE_PIN B19 IOSTANDARD LVCMOS25} [get_ports {PHY_RXD3}]   ;# bank 16 IO_L10P_T1_16
set_property src_info {type:XDC file:1 line:102 export:INPUT save:INPUT read:READ} [current_design]
set_property -dict {PACKAGE_PIN A19 IOSTANDARD LVCMOS25} [get_ports {PHY_RX_CTL}]   ;# bank 16 IO_L10N_T1_16
set_property src_info {type:XDC file:1 line:103 export:INPUT save:INPUT read:READ} [current_design]
set_property -dict {PACKAGE_PIN C24 IOSTANDARD LVCMOS25} [get_ports {PHY_TXC}]   ;# bank 16 IO_L23P_T3_16
set_property src_info {type:XDC file:1 line:105 export:INPUT save:INPUT read:READ} [current_design]
set_property -dict {PACKAGE_PIN B24 IOSTANDARD LVCMOS25} [get_ports {PHY_TXD0}]   ;# bank 16 IO_L23N_T3_16
set_property src_info {type:XDC file:1 line:107 export:INPUT save:INPUT read:READ} [current_design]
set_property -dict {PACKAGE_PIN C22 IOSTANDARD LVCMOS25} [get_ports {PHY_TXD1}]   ;# bank 16 IO_L19P_T3_16
set_property src_info {type:XDC file:1 line:109 export:INPUT save:INPUT read:READ} [current_design]
set_property -dict {PACKAGE_PIN C23 IOSTANDARD LVCMOS25} [get_ports {PHY_TXD2}]   ;# bank 16 IO_L19N_T3_VREF_16
set_property src_info {type:XDC file:1 line:111 export:INPUT save:INPUT read:READ} [current_design]
set_property -dict {PACKAGE_PIN C21 IOSTANDARD LVCMOS25} [get_ports {PHY_TXD3}]   ;# bank 16 IO_L16P_T2_16
set_property src_info {type:XDC file:1 line:113 export:INPUT save:INPUT read:READ} [current_design]
set_property -dict {PACKAGE_PIN B21 IOSTANDARD LVCMOS25} [get_ports {PHY_TX_CTL}]   ;# bank 16 IO_L16N_T2_16
set_property src_info {type:XDC file:1 line:116 export:INPUT save:INPUT read:READ} [current_design]
set_property -dict {PACKAGE_PIN T15 IOSTANDARD LVCMOS18} [get_ports {PSRAM0_CE_B}]   ;# bank 13 IO_L20N_T3_13
set_property src_info {type:XDC file:1 line:117 export:INPUT save:INPUT read:READ} [current_design]
set_property -dict {PACKAGE_PIN T17 IOSTANDARD LVCMOS18} [get_ports {PSRAM0_IO0}]   ;# bank 13 IO_L21P_T3_DQS_13
set_property src_info {type:XDC file:1 line:118 export:INPUT save:INPUT read:READ} [current_design]
set_property -dict {PACKAGE_PIN T18 IOSTANDARD LVCMOS18} [get_ports {PSRAM0_IO1}]   ;# bank 13 IO_L21N_T3_DQS_13
set_property src_info {type:XDC file:1 line:119 export:INPUT save:INPUT read:READ} [current_design]
set_property -dict {PACKAGE_PIN U15 IOSTANDARD LVCMOS18} [get_ports {PSRAM0_IO2}]   ;# bank 13 IO_L22P_T3_13
set_property src_info {type:XDC file:1 line:120 export:INPUT save:INPUT read:READ} [current_design]
set_property -dict {PACKAGE_PIN U16 IOSTANDARD LVCMOS18} [get_ports {PSRAM0_IO3}]   ;# bank 13 IO_L22N_T3_13
set_property src_info {type:XDC file:1 line:121 export:INPUT save:INPUT read:READ} [current_design]
set_property -dict {PACKAGE_PIN T14 IOSTANDARD LVCMOS18} [get_ports {PSRAM0_SCK}]   ;# bank 13 IO_L20P_T3_13
set_property src_info {type:XDC file:1 line:123 export:INPUT save:INPUT read:READ} [current_design]
set_property -dict {PACKAGE_PIN V14 IOSTANDARD LVCMOS18} [get_ports {PSRAM1_CE_B}]   ;# bank 13 IO_L23N_T3_13
set_property src_info {type:XDC file:1 line:124 export:INPUT save:INPUT read:READ} [current_design]
set_property -dict {PACKAGE_PIN V16 IOSTANDARD LVCMOS18} [get_ports {PSRAM1_IO0}]   ;# bank 13 IO_L24P_T3_13
set_property src_info {type:XDC file:1 line:125 export:INPUT save:INPUT read:READ} [current_design]
set_property -dict {PACKAGE_PIN V17 IOSTANDARD LVCMOS18} [get_ports {PSRAM1_IO1}]   ;# bank 13 IO_L24N_T3_13
set_property src_info {type:XDC file:1 line:126 export:INPUT save:INPUT read:READ} [current_design]
set_property -dict {PACKAGE_PIN V18 IOSTANDARD LVCMOS18} [get_ports {PSRAM1_IO2}]   ;# bank 13 IO_L19P_T3_13
set_property src_info {type:XDC file:1 line:127 export:INPUT save:INPUT read:READ} [current_design]
set_property -dict {PACKAGE_PIN W18 IOSTANDARD LVCMOS18} [get_ports {PSRAM1_IO3}]   ;# bank 13 IO_L19N_T3_VREF_13
set_property src_info {type:XDC file:1 line:128 export:INPUT save:INPUT read:READ} [current_design]
set_property -dict {PACKAGE_PIN U14 IOSTANDARD LVCMOS18} [get_ports {PSRAM1_SCK}]   ;# bank 13 IO_L23P_T3_13
set_property src_info {type:XDC file:1 line:130 export:INPUT save:INPUT read:READ} [current_design]
set_property -dict {PACKAGE_PIN U19 IOSTANDARD LVCMOS18} [get_ports {PSRAM2_CE_B}]   ;# bank 13 IO_L17N_T2_13
set_property src_info {type:XDC file:1 line:131 export:INPUT save:INPUT read:READ} [current_design]
set_property -dict {PACKAGE_PIN V19 IOSTANDARD LVCMOS18} [get_ports {PSRAM2_IO0}]   ;# bank 13 IO_L18P_T2_13
set_property src_info {type:XDC file:1 line:132 export:INPUT save:INPUT read:READ} [current_design]
set_property -dict {PACKAGE_PIN W19 IOSTANDARD LVCMOS18} [get_ports {PSRAM2_IO1}]   ;# bank 13 IO_L18N_T2_13
set_property src_info {type:XDC file:1 line:133 export:INPUT save:INPUT read:READ} [current_design]
set_property -dict {PACKAGE_PIN T20 IOSTANDARD LVCMOS18} [get_ports {PSRAM2_IO2}]   ;# bank 13 IO_L15P_T2_DQS_13
set_property src_info {type:XDC file:1 line:134 export:INPUT save:INPUT read:READ} [current_design]
set_property -dict {PACKAGE_PIN U20 IOSTANDARD LVCMOS18} [get_ports {PSRAM2_IO3}]   ;# bank 13 IO_L15N_T2_DQS_13
set_property src_info {type:XDC file:1 line:135 export:INPUT save:INPUT read:READ} [current_design]
set_property -dict {PACKAGE_PIN T19 IOSTANDARD LVCMOS18} [get_ports {PSRAM2_SCK}]   ;# bank 13 IO_L17P_T2_13
set_property src_info {type:XDC file:1 line:137 export:INPUT save:INPUT read:READ} [current_design]
set_property -dict {PACKAGE_PIN Y20 IOSTANDARD LVCMOS18} [get_ports {PSRAM3_CE_B}]   ;# bank 13 IO_L16N_T2_13
set_property src_info {type:XDC file:1 line:138 export:INPUT save:INPUT read:READ} [current_design]
set_property -dict {PACKAGE_PIN W21 IOSTANDARD LVCMOS18} [get_ports {PSRAM3_IO0}]   ;# bank 13 IO_L14P_T2_SRCC_13
set_property src_info {type:XDC file:1 line:139 export:INPUT save:INPUT read:READ} [current_design]
set_property -dict {PACKAGE_PIN Y21 IOSTANDARD LVCMOS18} [get_ports {PSRAM3_IO1}]   ;# bank 13 IO_L14N_T2_SRCC_13
set_property src_info {type:XDC file:1 line:140 export:INPUT save:INPUT read:READ} [current_design]
set_property -dict {PACKAGE_PIN Y22 IOSTANDARD LVCMOS18} [get_ports {PSRAM3_IO2}]   ;# bank 13 IO_L11P_T1_SRCC_13
set_property src_info {type:XDC file:1 line:141 export:INPUT save:INPUT read:READ} [current_design]
set_property -dict {PACKAGE_PIN Y23 IOSTANDARD LVCMOS18} [get_ports {PSRAM3_IO3}]   ;# bank 13 IO_L11N_T1_SRCC_13
set_property src_info {type:XDC file:1 line:142 export:INPUT save:INPUT read:READ} [current_design]
set_property -dict {PACKAGE_PIN W20 IOSTANDARD LVCMOS18} [get_ports {PSRAM3_SCK}]   ;# bank 13 IO_L16P_T2_13
set_property src_info {type:XDC file:1 line:144 export:INPUT save:INPUT read:READ} [current_design]
set_property -dict {PACKAGE_PIN P15 IOSTANDARD LVCMOS33} [get_ports {PUDC_B}]   ;# bank 14 IO_L3P_T0_DQS_PUDC_B_14
set_property src_info {type:XDC file:1 line:146 export:INPUT save:INPUT read:READ} [current_design]
set_property -dict {PACKAGE_PIN P20 IOSTANDARD LVCMOS33} [get_ports {SB_UART_RX}]   ;# bank 14 IO_L14P_T2_SRCC_14
set_property src_info {type:XDC file:1 line:147 export:INPUT save:INPUT read:READ} [current_design]
set_property -dict {PACKAGE_PIN P21 IOSTANDARD LVCMOS33} [get_ports {SB_UART_TX}]   ;# bank 14 IO_L14N_T2_SRCC_14
set_property src_info {type:XDC file:1 line:149 export:INPUT save:INPUT read:READ} [current_design]
set_property -dict {PACKAGE_PIN T23 IOSTANDARD LVCMOS33} [get_ports {SD_CD}]   ;# bank 14 IO_L24P_T3_A01_D17_14
set_property src_info {type:XDC file:1 line:151 export:INPUT save:INPUT read:READ} [current_design]
set_property -dict {PACKAGE_PIN L22 IOSTANDARD LVCMOS33} [get_ports {SD_CS}]   ;# bank 14 IO_L11P_T1_SRCC_14
set_property src_info {type:XDC file:1 line:152 export:INPUT save:INPUT read:READ} [current_design]
set_property -dict {PACKAGE_PIN R22 IOSTANDARD LVCMOS33} [get_ports {SD_MISO}]   ;# bank 14 IO_L23N_T3_A02_D18_14
set_property src_info {type:XDC file:1 line:153 export:INPUT save:INPUT read:READ} [current_design]
set_property -dict {PACKAGE_PIN T22 IOSTANDARD LVCMOS33} [get_ports {SD_MOSI}]   ;# bank 14 IO_L23P_T3_A03_D19_14
set_property src_info {type:XDC file:1 line:154 export:INPUT save:INPUT read:READ} [current_design]
set_property -dict {PACKAGE_PIN L23 IOSTANDARD LVCMOS33} [get_ports {SD_SCK}]   ;# bank 14 IO_L11N_T1_SRCC_14
set_property src_info {type:XDC file:1 line:156 export:INPUT save:INPUT read:READ} [current_design]
set_property -dict {PACKAGE_PIN M26 IOSTANDARD LVCMOS33} [get_ports {SDRAM_A0}]   ;# bank 14 IO_L20N_T3_A07_D23_14
set_property src_info {type:XDC file:1 line:157 export:INPUT save:INPUT read:READ} [current_design]
set_property -dict {PACKAGE_PIN N26 IOSTANDARD LVCMOS33} [get_ports {SDRAM_A1}]   ;# bank 14 IO_L20P_T3_A08_D24_14
set_property src_info {type:XDC file:1 line:158 export:INPUT save:INPUT read:READ} [current_design]
set_property -dict {PACKAGE_PIN P24 IOSTANDARD LVCMOS33} [get_ports {SDRAM_A10}]   ;# bank 14 IO_L17N_T2_A13_D29_14
set_property src_info {type:XDC file:1 line:159 export:INPUT save:INPUT read:READ} [current_design]
set_property -dict {PACKAGE_PIN T24 IOSTANDARD LVCMOS33} [get_ports {SDRAM_A11}]   ;# bank 14 IO_L21P_T3_DQS_14
set_property src_info {type:XDC file:1 line:160 export:INPUT save:INPUT read:READ} [current_design]
set_property -dict {PACKAGE_PIN N23 IOSTANDARD LVCMOS33} [get_ports {SDRAM_A12}]   ;# bank 14 IO_L15P_T2_DQS_RDWR_B_14
set_property src_info {type:XDC file:1 line:161 export:INPUT save:INPUT read:READ} [current_design]
set_property -dict {PACKAGE_PIN P26 IOSTANDARD LVCMOS33} [get_ports {SDRAM_A2}]   ;# bank 14 IO_L22N_T3_A04_D20_14
set_property src_info {type:XDC file:1 line:162 export:INPUT save:INPUT read:READ} [current_design]
set_property -dict {PACKAGE_PIN R26 IOSTANDARD LVCMOS33} [get_ports {SDRAM_A3}]   ;# bank 14 IO_L22P_T3_A05_D21_14
set_property src_info {type:XDC file:1 line:163 export:INPUT save:INPUT read:READ} [current_design]
set_property -dict {PACKAGE_PIN M25 IOSTANDARD LVCMOS33} [get_ports {SDRAM_A4}]   ;# bank 14 IO_L10N_T1_D15_14
set_property src_info {type:XDC file:1 line:164 export:INPUT save:INPUT read:READ} [current_design]
set_property -dict {PACKAGE_PIN P25 IOSTANDARD LVCMOS33} [get_ports {SDRAM_A5}]   ;# bank 14 IO_L19N_T3_A09_D25_VREF_14
set_property src_info {type:XDC file:1 line:165 export:INPUT save:INPUT read:READ} [current_design]
set_property -dict {PACKAGE_PIN R25 IOSTANDARD LVCMOS33} [get_ports {SDRAM_A6}]   ;# bank 14 IO_L19P_T3_A10_D26_14
set_property src_info {type:XDC file:1 line:166 export:INPUT save:INPUT read:READ} [current_design]
set_property -dict {PACKAGE_PIN T25 IOSTANDARD LVCMOS33} [get_ports {SDRAM_A7}]   ;# bank 14 IO_L21N_T3_DQS_A06_D22_14
set_property src_info {type:XDC file:1 line:167 export:INPUT save:INPUT read:READ} [current_design]
set_property -dict {PACKAGE_PIN M24 IOSTANDARD LVCMOS33} [get_ports {SDRAM_A8}]   ;# bank 14 IO_L10P_T1_D14_14
set_property src_info {type:XDC file:1 line:168 export:INPUT save:INPUT read:READ} [current_design]
set_property -dict {PACKAGE_PIN N24 IOSTANDARD LVCMOS33} [get_ports {SDRAM_A9}]   ;# bank 14 IO_L15N_T2_DQS_DOUT_CSO_B_14
set_property src_info {type:XDC file:1 line:169 export:INPUT save:INPUT read:READ} [current_design]
set_property -dict {PACKAGE_PIN P23 IOSTANDARD LVCMOS33} [get_ports {SDRAM_BA0}]   ;# bank 14 IO_L17P_T2_A14_D30_14
set_property src_info {type:XDC file:1 line:170 export:INPUT save:INPUT read:READ} [current_design]
set_property -dict {PACKAGE_PIN R23 IOSTANDARD LVCMOS33} [get_ports {SDRAM_BA1}]   ;# bank 14 IO_L24N_T3_A00_D16_14
set_property src_info {type:XDC file:1 line:171 export:INPUT save:INPUT read:READ} [current_design]
set_property -dict {PACKAGE_PIN F3 IOSTANDARD LVCMOS33} [get_ports {SDRAM_CAS_N}]   ;# bank 35 IO_L18P_T2_35
set_property src_info {type:XDC file:1 line:172 export:INPUT save:INPUT read:READ} [current_design]
set_property -dict {PACKAGE_PIN K6 IOSTANDARD LVCMOS33} [get_ports {SDRAM_CKE}]   ;# bank 35 IO_L10N_T1_AD15N_35
set_property src_info {type:XDC file:1 line:173 export:INPUT save:INPUT read:READ} [current_design]
set_property -dict {PACKAGE_PIN D3 IOSTANDARD LVCMOS33} [get_ports {SDRAM_CS_N}]   ;# bank 35 IO_L17P_T2_35
set_property src_info {type:XDC file:1 line:174 export:INPUT save:INPUT read:READ} [current_design]
set_property -dict {PACKAGE_PIN E6 IOSTANDARD LVCMOS33} [get_ports {SDRAM_DQ0}]   ;# bank 35 IO_L1P_T0_AD4P_35
set_property src_info {type:XDC file:1 line:175 export:INPUT save:INPUT read:READ} [current_design]
set_property -dict {PACKAGE_PIN D6 IOSTANDARD LVCMOS33} [get_ports {SDRAM_DQ1}]   ;# bank 35 IO_L1N_T0_AD4N_35
set_property src_info {type:XDC file:1 line:176 export:INPUT save:INPUT read:READ} [current_design]
set_property -dict {PACKAGE_PIN H9 IOSTANDARD LVCMOS33} [get_ports {SDRAM_DQ10}]   ;# bank 35 IO_L6P_T0_35
set_property src_info {type:XDC file:1 line:177 export:INPUT save:INPUT read:READ} [current_design]
set_property -dict {PACKAGE_PIN G9 IOSTANDARD LVCMOS33} [get_ports {SDRAM_DQ11}]   ;# bank 35 IO_L6N_T0_VREF_35
set_property src_info {type:XDC file:1 line:178 export:INPUT save:INPUT read:READ} [current_design]
set_property -dict {PACKAGE_PIN J6 IOSTANDARD LVCMOS33} [get_ports {SDRAM_DQ12}]   ;# bank 35 IO_L7P_T1_AD6P_35
set_property src_info {type:XDC file:1 line:179 export:INPUT save:INPUT read:READ} [current_design]
set_property -dict {PACKAGE_PIN J5 IOSTANDARD LVCMOS33} [get_ports {SDRAM_DQ13}]   ;# bank 35 IO_L7N_T1_AD6N_35
set_property src_info {type:XDC file:1 line:180 export:INPUT save:INPUT read:READ} [current_design]
set_property -dict {PACKAGE_PIN L8 IOSTANDARD LVCMOS33} [get_ports {SDRAM_DQ14}]   ;# bank 35 IO_L8P_T1_AD14P_35
set_property src_info {type:XDC file:1 line:181 export:INPUT save:INPUT read:READ} [current_design]
set_property -dict {PACKAGE_PIN K8 IOSTANDARD LVCMOS33} [get_ports {SDRAM_DQ15}]   ;# bank 35 IO_L8N_T1_AD14N_35
set_property src_info {type:XDC file:1 line:182 export:INPUT save:INPUT read:READ} [current_design]
set_property -dict {PACKAGE_PIN H8 IOSTANDARD LVCMOS33} [get_ports {SDRAM_DQ2}]   ;# bank 35 IO_L2P_T0_AD12P_35
set_property src_info {type:XDC file:1 line:183 export:INPUT save:INPUT read:READ} [current_design]
set_property -dict {PACKAGE_PIN G8 IOSTANDARD LVCMOS33} [get_ports {SDRAM_DQ3}]   ;# bank 35 IO_L2N_T0_AD12N_35
set_property src_info {type:XDC file:1 line:184 export:INPUT save:INPUT read:READ} [current_design]
set_property -dict {PACKAGE_PIN H7 IOSTANDARD LVCMOS33} [get_ports {SDRAM_DQ4}]   ;# bank 35 IO_L3P_T0_DQS_AD5P_35
set_property src_info {type:XDC file:1 line:185 export:INPUT save:INPUT read:READ} [current_design]
set_property -dict {PACKAGE_PIN G7 IOSTANDARD LVCMOS33} [get_ports {SDRAM_DQ5}]   ;# bank 35 IO_L3N_T0_DQS_AD5N_35
set_property src_info {type:XDC file:1 line:186 export:INPUT save:INPUT read:READ} [current_design]
set_property -dict {PACKAGE_PIN F8 IOSTANDARD LVCMOS33} [get_ports {SDRAM_DQ6}]   ;# bank 35 IO_L4P_T0_35
set_property src_info {type:XDC file:1 line:187 export:INPUT save:INPUT read:READ} [current_design]
set_property -dict {PACKAGE_PIN F7 IOSTANDARD LVCMOS33} [get_ports {SDRAM_DQ7}]   ;# bank 35 IO_L4N_T0_35
set_property src_info {type:XDC file:1 line:188 export:INPUT save:INPUT read:READ} [current_design]
set_property -dict {PACKAGE_PIN H6 IOSTANDARD LVCMOS33} [get_ports {SDRAM_DQ8}]   ;# bank 35 IO_L5P_T0_AD13P_35
set_property src_info {type:XDC file:1 line:189 export:INPUT save:INPUT read:READ} [current_design]
set_property -dict {PACKAGE_PIN G6 IOSTANDARD LVCMOS33} [get_ports {SDRAM_DQ9}]   ;# bank 35 IO_L5N_T0_AD13N_35
set_property src_info {type:XDC file:1 line:190 export:INPUT save:INPUT read:READ} [current_design]
set_property -dict {PACKAGE_PIN J4 IOSTANDARD LVCMOS33} [get_ports {SDRAM_LDQM}]   ;# bank 35 IO_L9P_T1_DQS_AD7P_35
set_property src_info {type:XDC file:1 line:191 export:INPUT save:INPUT read:READ} [current_design]
set_property -dict {PACKAGE_PIN C3 IOSTANDARD LVCMOS33} [get_ports {SDRAM_RAS_N}]   ;# bank 35 IO_L17N_T2_35
set_property src_info {type:XDC file:1 line:192 export:INPUT save:INPUT read:READ} [current_design]
set_property -dict {PACKAGE_PIN H4 IOSTANDARD LVCMOS33} [get_ports {SDRAM_UDQM}]   ;# bank 35 IO_L9N_T1_DQS_AD7N_35
set_property src_info {type:XDC file:1 line:193 export:INPUT save:INPUT read:READ} [current_design]
set_property -dict {PACKAGE_PIN E3 IOSTANDARD LVCMOS33} [get_ports {SDRAM_WE_N}]   ;# bank 35 IO_L18N_T2_35
set_property src_info {type:XDC file:1 line:196 export:INPUT save:INPUT read:READ} [current_design]
set_property -dict {PACKAGE_PIN K7 IOSTANDARD LVCMOS33} [get_ports {SDRAM_CLK}]   ;# bank 35 IO_L10P_T1_AD15P_35
set_property src_info {type:XDC file:1 line:199 export:INPUT save:INPUT read:READ} [current_design]
set_property -dict {PACKAGE_PIN K15 IOSTANDARD LVCMOS33} [get_ports {SLOTA_IO0}]   ;# bank 15 IO_L1P_T0_AD0P_15
set_property src_info {type:XDC file:1 line:200 export:INPUT save:INPUT read:READ} [current_design]
set_property -dict {PACKAGE_PIN J16 IOSTANDARD LVCMOS33} [get_ports {SLOTA_IO1}]   ;# bank 15 IO_L1N_T0_AD0N_15
set_property src_info {type:XDC file:1 line:201 export:INPUT save:INPUT read:READ} [current_design]
set_property -dict {PACKAGE_PIN M16 IOSTANDARD LVCMOS33} [get_ports {SLOTA_IO10}]   ;# bank 15 IO_L6P_T0_15
set_property src_info {type:XDC file:1 line:202 export:INPUT save:INPUT read:READ} [current_design]
set_property -dict {PACKAGE_PIN M17 IOSTANDARD LVCMOS33} [get_ports {SLOTA_IO11}]   ;# bank 15 IO_L6N_T0_VREF_15
set_property src_info {type:XDC file:1 line:203 export:INPUT save:INPUT read:READ} [current_design]
set_property -dict {PACKAGE_PIN J14 IOSTANDARD LVCMOS33} [get_ports {SLOTA_IO2}]   ;# bank 15 IO_L2P_T0_AD8P_15
set_property src_info {type:XDC file:1 line:204 export:INPUT save:INPUT read:READ} [current_design]
set_property -dict {PACKAGE_PIN J15 IOSTANDARD LVCMOS33} [get_ports {SLOTA_IO3}]   ;# bank 15 IO_L2N_T0_AD8N_15
set_property src_info {type:XDC file:1 line:205 export:INPUT save:INPUT read:READ} [current_design]
set_property -dict {PACKAGE_PIN K16 IOSTANDARD LVCMOS33} [get_ports {SLOTA_IO4}]   ;# bank 15 IO_L3P_T0_DQS_AD1P_15
set_property src_info {type:XDC file:1 line:206 export:INPUT save:INPUT read:READ} [current_design]
set_property -dict {PACKAGE_PIN K17 IOSTANDARD LVCMOS33} [get_ports {SLOTA_IO5}]   ;# bank 15 IO_L3N_T0_DQS_AD1N_15
set_property src_info {type:XDC file:1 line:207 export:INPUT save:INPUT read:READ} [current_design]
set_property -dict {PACKAGE_PIN M14 IOSTANDARD LVCMOS33} [get_ports {SLOTA_IO6}]   ;# bank 15 IO_L4P_T0_15
set_property src_info {type:XDC file:1 line:208 export:INPUT save:INPUT read:READ} [current_design]
set_property -dict {PACKAGE_PIN L14 IOSTANDARD LVCMOS33} [get_ports {SLOTA_IO7}]   ;# bank 15 IO_L4N_T0_15
set_property src_info {type:XDC file:1 line:209 export:INPUT save:INPUT read:READ} [current_design]
set_property -dict {PACKAGE_PIN M15 IOSTANDARD LVCMOS33} [get_ports {SLOTA_IO8}]   ;# bank 15 IO_L5P_T0_AD9P_15
set_property src_info {type:XDC file:1 line:210 export:INPUT save:INPUT read:READ} [current_design]
set_property -dict {PACKAGE_PIN L15 IOSTANDARD LVCMOS33} [get_ports {SLOTA_IO9}]   ;# bank 15 IO_L5N_T0_AD9N_15
set_property src_info {type:XDC file:1 line:212 export:INPUT save:INPUT read:READ} [current_design]
set_property -dict {PACKAGE_PIN J19 IOSTANDARD LVCMOS33} [get_ports {SLOTB_IO0}]   ;# bank 15 IO_L7P_T1_AD2P_15
set_property src_info {type:XDC file:1 line:213 export:INPUT save:INPUT read:READ} [current_design]
set_property -dict {PACKAGE_PIN H19 IOSTANDARD LVCMOS33} [get_ports {SLOTB_IO1}]   ;# bank 15 IO_L7N_T1_AD2N_15
set_property src_info {type:XDC file:1 line:214 export:INPUT save:INPUT read:READ} [current_design]
set_property -dict {PACKAGE_PIN K21 IOSTANDARD LVCMOS33} [get_ports {SLOTB_IO10}]   ;# bank 15 IO_L12P_T1_MRCC_15
set_property src_info {type:XDC file:1 line:215 export:INPUT save:INPUT read:READ} [current_design]
set_property -dict {PACKAGE_PIN J21 IOSTANDARD LVCMOS33} [get_ports {SLOTB_IO11}]   ;# bank 15 IO_L12N_T1_MRCC_15
set_property src_info {type:XDC file:1 line:216 export:INPUT save:INPUT read:READ} [current_design]
set_property -dict {PACKAGE_PIN L17 IOSTANDARD LVCMOS33} [get_ports {SLOTB_IO2}]   ;# bank 15 IO_L8P_T1_AD10P_15
set_property src_info {type:XDC file:1 line:217 export:INPUT save:INPUT read:READ} [current_design]
set_property -dict {PACKAGE_PIN L18 IOSTANDARD LVCMOS33} [get_ports {SLOTB_IO3}]   ;# bank 15 IO_L8N_T1_AD10N_15
set_property src_info {type:XDC file:1 line:218 export:INPUT save:INPUT read:READ} [current_design]
set_property -dict {PACKAGE_PIN K20 IOSTANDARD LVCMOS33} [get_ports {SLOTB_IO4}]   ;# bank 15 IO_L9P_T1_DQS_AD3P_15
set_property src_info {type:XDC file:1 line:219 export:INPUT save:INPUT read:READ} [current_design]
set_property -dict {PACKAGE_PIN J20 IOSTANDARD LVCMOS33} [get_ports {SLOTB_IO5}]   ;# bank 15 IO_L9N_T1_DQS_AD3N_15
set_property src_info {type:XDC file:1 line:220 export:INPUT save:INPUT read:READ} [current_design]
set_property -dict {PACKAGE_PIN J18 IOSTANDARD LVCMOS33} [get_ports {SLOTB_IO6}]   ;# bank 15 IO_L10P_T1_AD11P_15
set_property src_info {type:XDC file:1 line:221 export:INPUT save:INPUT read:READ} [current_design]
set_property -dict {PACKAGE_PIN H18 IOSTANDARD LVCMOS33} [get_ports {SLOTB_IO7}]   ;# bank 15 IO_L10N_T1_AD11N_15
set_property src_info {type:XDC file:1 line:222 export:INPUT save:INPUT read:READ} [current_design]
set_property -dict {PACKAGE_PIN G20 IOSTANDARD LVCMOS33} [get_ports {SLOTB_IO8}]   ;# bank 15 IO_L11P_T1_SRCC_15
set_property src_info {type:XDC file:1 line:223 export:INPUT save:INPUT read:READ} [current_design]
set_property -dict {PACKAGE_PIN G21 IOSTANDARD LVCMOS33} [get_ports {SLOTB_IO9}]   ;# bank 15 IO_L11N_T1_SRCC_15
set_property src_info {type:XDC file:1 line:225 export:INPUT save:INPUT read:READ} [current_design]
set_property -dict {PACKAGE_PIN H21 IOSTANDARD LVCMOS33} [get_ports {SLOTC_IO0}]   ;# bank 15 IO_L13P_T2_MRCC_15
set_property src_info {type:XDC file:1 line:226 export:INPUT save:INPUT read:READ} [current_design]
set_property -dict {PACKAGE_PIN H22 IOSTANDARD LVCMOS33} [get_ports {SLOTC_IO1}]   ;# bank 15 IO_L13N_T2_MRCC_15
set_property src_info {type:XDC file:1 line:227 export:INPUT save:INPUT read:READ} [current_design]
set_property -dict {PACKAGE_PIN K22 IOSTANDARD LVCMOS33} [get_ports {SLOTC_IO10}]   ;# bank 15 IO_L18P_T2_A24_15
set_property src_info {type:XDC file:1 line:228 export:INPUT save:INPUT read:READ} [current_design]
set_property -dict {PACKAGE_PIN K23 IOSTANDARD LVCMOS33} [get_ports {SLOTC_IO11}]   ;# bank 15 IO_L18N_T2_A23_15
set_property src_info {type:XDC file:1 line:229 export:INPUT save:INPUT read:READ} [current_design]
set_property -dict {PACKAGE_PIN J23 IOSTANDARD LVCMOS33} [get_ports {SLOTC_IO2}]   ;# bank 15 IO_L14P_T2_SRCC_15
set_property src_info {type:XDC file:1 line:230 export:INPUT save:INPUT read:READ} [current_design]
set_property -dict {PACKAGE_PIN H23 IOSTANDARD LVCMOS33} [get_ports {SLOTC_IO3}]   ;# bank 15 IO_L14N_T2_SRCC_15
set_property src_info {type:XDC file:1 line:231 export:INPUT save:INPUT read:READ} [current_design]
set_property -dict {PACKAGE_PIN G22 IOSTANDARD LVCMOS33} [get_ports {SLOTC_IO4}]   ;# bank 15 IO_L15P_T2_DQS_15
set_property src_info {type:XDC file:1 line:232 export:INPUT save:INPUT read:READ} [current_design]
set_property -dict {PACKAGE_PIN F22 IOSTANDARD LVCMOS33} [get_ports {SLOTC_IO5}]   ;# bank 15 IO_L15N_T2_DQS_ADV_B_15
set_property src_info {type:XDC file:1 line:233 export:INPUT save:INPUT read:READ} [current_design]
set_property -dict {PACKAGE_PIN J24 IOSTANDARD LVCMOS33} [get_ports {SLOTC_IO6}]   ;# bank 15 IO_L16P_T2_A28_15
set_property src_info {type:XDC file:1 line:234 export:INPUT save:INPUT read:READ} [current_design]
set_property -dict {PACKAGE_PIN H24 IOSTANDARD LVCMOS33} [get_ports {SLOTC_IO7}]   ;# bank 15 IO_L16N_T2_A27_15
set_property src_info {type:XDC file:1 line:235 export:INPUT save:INPUT read:READ} [current_design]
set_property -dict {PACKAGE_PIN F23 IOSTANDARD LVCMOS33} [get_ports {SLOTC_IO8}]   ;# bank 15 IO_L17P_T2_A26_15
set_property src_info {type:XDC file:1 line:236 export:INPUT save:INPUT read:READ} [current_design]
set_property -dict {PACKAGE_PIN E23 IOSTANDARD LVCMOS33} [get_ports {SLOTC_IO9}]   ;# bank 15 IO_L17N_T2_A25_15
set_property src_info {type:XDC file:1 line:238 export:INPUT save:INPUT read:READ} [current_design]
set_property -dict {PACKAGE_PIN G24 IOSTANDARD LVCMOS33} [get_ports {SLOTD_IO0}]   ;# bank 15 IO_L19P_T3_A22_15
set_property src_info {type:XDC file:1 line:239 export:INPUT save:INPUT read:READ} [current_design]
set_property -dict {PACKAGE_PIN F24 IOSTANDARD LVCMOS33} [get_ports {SLOTD_IO1}]   ;# bank 15 IO_L19N_T3_A21_VREF_15
set_property src_info {type:XDC file:1 line:240 export:INPUT save:INPUT read:READ} [current_design]
set_property -dict {PACKAGE_PIN J25 IOSTANDARD LVCMOS33} [get_ports {SLOTD_IO10}]   ;# bank 15 IO_L24P_T3_RS1_15
set_property src_info {type:XDC file:1 line:241 export:INPUT save:INPUT read:READ} [current_design]
set_property -dict {PACKAGE_PIN J26 IOSTANDARD LVCMOS33} [get_ports {SLOTD_IO11}]   ;# bank 15 IO_L24N_T3_RS0_15
set_property src_info {type:XDC file:1 line:242 export:INPUT save:INPUT read:READ} [current_design]
set_property -dict {PACKAGE_PIN E25 IOSTANDARD LVCMOS33} [get_ports {SLOTD_IO2}]   ;# bank 15 IO_L20P_T3_A20_15
set_property src_info {type:XDC file:1 line:243 export:INPUT save:INPUT read:READ} [current_design]
set_property -dict {PACKAGE_PIN D25 IOSTANDARD LVCMOS33} [get_ports {SLOTD_IO3}]   ;# bank 15 IO_L20N_T3_A19_15
set_property src_info {type:XDC file:1 line:244 export:INPUT save:INPUT read:READ} [current_design]
set_property -dict {PACKAGE_PIN E26 IOSTANDARD LVCMOS33} [get_ports {SLOTD_IO4}]   ;# bank 15 IO_L21P_T3_DQS_15
set_property src_info {type:XDC file:1 line:245 export:INPUT save:INPUT read:READ} [current_design]
set_property -dict {PACKAGE_PIN D26 IOSTANDARD LVCMOS33} [get_ports {SLOTD_IO5}]   ;# bank 15 IO_L21N_T3_DQS_A18_15
set_property src_info {type:XDC file:1 line:246 export:INPUT save:INPUT read:READ} [current_design]
set_property -dict {PACKAGE_PIN H26 IOSTANDARD LVCMOS33} [get_ports {SLOTD_IO6}]   ;# bank 15 IO_L22P_T3_A17_15
set_property src_info {type:XDC file:1 line:247 export:INPUT save:INPUT read:READ} [current_design]
set_property -dict {PACKAGE_PIN G26 IOSTANDARD LVCMOS33} [get_ports {SLOTD_IO7}]   ;# bank 15 IO_L22N_T3_A16_15
set_property src_info {type:XDC file:1 line:248 export:INPUT save:INPUT read:READ} [current_design]
set_property -dict {PACKAGE_PIN G25 IOSTANDARD LVCMOS33} [get_ports {SLOTD_IO8}]   ;# bank 15 IO_L23P_T3_FOE_B_15
set_property src_info {type:XDC file:1 line:249 export:INPUT save:INPUT read:READ} [current_design]
set_property -dict {PACKAGE_PIN F25 IOSTANDARD LVCMOS33} [get_ports {SLOTD_IO9}]   ;# bank 15 IO_L23N_T3_FWE_B_15
set_property src_info {type:XDC file:1 line:251 export:INPUT save:INPUT read:READ} [current_design]
set_property -dict {PACKAGE_PIN K3 IOSTANDARD LVCMOS33} [get_ports {SLOTE_IO0}]   ;# bank 34 IO_L1P_T0_34
set_property src_info {type:XDC file:1 line:252 export:INPUT save:INPUT read:READ} [current_design]
set_property -dict {PACKAGE_PIN J3 IOSTANDARD LVCMOS33} [get_ports {SLOTE_IO1}]   ;# bank 34 IO_L1N_T0_34
set_property src_info {type:XDC file:1 line:253 export:INPUT save:INPUT read:READ} [current_design]
set_property -dict {PACKAGE_PIN M6 IOSTANDARD LVCMOS33} [get_ports {SLOTE_IO10}]   ;# bank 34 IO_L6P_T0_34
set_property src_info {type:XDC file:1 line:254 export:INPUT save:INPUT read:READ} [current_design]
set_property -dict {PACKAGE_PIN M5 IOSTANDARD LVCMOS33} [get_ports {SLOTE_IO11}]   ;# bank 34 IO_L6N_T0_VREF_34
set_property src_info {type:XDC file:1 line:255 export:INPUT save:INPUT read:READ} [current_design]
set_property -dict {PACKAGE_PIN M7 IOSTANDARD LVCMOS33} [get_ports {SLOTE_IO2}]   ;# bank 34 IO_L2P_T0_34
set_property src_info {type:XDC file:1 line:256 export:INPUT save:INPUT read:READ} [current_design]
set_property -dict {PACKAGE_PIN L7 IOSTANDARD LVCMOS33} [get_ports {SLOTE_IO3}]   ;# bank 34 IO_L2N_T0_34
set_property src_info {type:XDC file:1 line:257 export:INPUT save:INPUT read:READ} [current_design]
set_property -dict {PACKAGE_PIN M4 IOSTANDARD LVCMOS33} [get_ports {SLOTE_IO4}]   ;# bank 34 IO_L3P_T0_DQS_34
set_property src_info {type:XDC file:1 line:258 export:INPUT save:INPUT read:READ} [current_design]
set_property -dict {PACKAGE_PIN L4 IOSTANDARD LVCMOS33} [get_ports {SLOTE_IO5}]   ;# bank 34 IO_L3N_T0_DQS_34
set_property src_info {type:XDC file:1 line:259 export:INPUT save:INPUT read:READ} [current_design]
set_property -dict {PACKAGE_PIN L5 IOSTANDARD LVCMOS33} [get_ports {SLOTE_IO6}]   ;# bank 34 IO_L4P_T0_34
set_property src_info {type:XDC file:1 line:260 export:INPUT save:INPUT read:READ} [current_design]
set_property -dict {PACKAGE_PIN K5 IOSTANDARD LVCMOS33} [get_ports {SLOTE_IO7}]   ;# bank 34 IO_L4N_T0_34
set_property src_info {type:XDC file:1 line:261 export:INPUT save:INPUT read:READ} [current_design]
set_property -dict {PACKAGE_PIN N7 IOSTANDARD LVCMOS33} [get_ports {SLOTE_IO8}]   ;# bank 34 IO_L5P_T0_34
set_property src_info {type:XDC file:1 line:262 export:INPUT save:INPUT read:READ} [current_design]
set_property -dict {PACKAGE_PIN N6 IOSTANDARD LVCMOS33} [get_ports {SLOTE_IO9}]   ;# bank 34 IO_L5N_T0_34
set_property src_info {type:XDC file:1 line:264 export:INPUT save:INPUT read:READ} [current_design]
set_property -dict {PACKAGE_PIN K1 IOSTANDARD LVCMOS33} [get_ports {SLOTF_IO0}]   ;# bank 34 IO_L7P_T1_34
set_property src_info {type:XDC file:1 line:265 export:INPUT save:INPUT read:READ} [current_design]
set_property -dict {PACKAGE_PIN J1 IOSTANDARD LVCMOS33} [get_ports {SLOTF_IO1}]   ;# bank 34 IO_L7N_T1_34
set_property src_info {type:XDC file:1 line:266 export:INPUT save:INPUT read:READ} [current_design]
set_property -dict {PACKAGE_PIN N3 IOSTANDARD LVCMOS33} [get_ports {SLOTF_IO10}]   ;# bank 34 IO_L12P_T1_MRCC_34
set_property src_info {type:XDC file:1 line:267 export:INPUT save:INPUT read:READ} [current_design]
set_property -dict {PACKAGE_PIN N2 IOSTANDARD LVCMOS33} [get_ports {SLOTF_IO11}]   ;# bank 34 IO_L12N_T1_MRCC_34
set_property src_info {type:XDC file:1 line:268 export:INPUT save:INPUT read:READ} [current_design]
set_property -dict {PACKAGE_PIN L3 IOSTANDARD LVCMOS33} [get_ports {SLOTF_IO2}]   ;# bank 34 IO_L8P_T1_34
set_property src_info {type:XDC file:1 line:269 export:INPUT save:INPUT read:READ} [current_design]
set_property -dict {PACKAGE_PIN K2 IOSTANDARD LVCMOS33} [get_ports {SLOTF_IO3}]   ;# bank 34 IO_L8N_T1_34
set_property src_info {type:XDC file:1 line:270 export:INPUT save:INPUT read:READ} [current_design]
set_property -dict {PACKAGE_PIN N1 IOSTANDARD LVCMOS33} [get_ports {SLOTF_IO4}]   ;# bank 34 IO_L9P_T1_DQS_34
set_property src_info {type:XDC file:1 line:271 export:INPUT save:INPUT read:READ} [current_design]
set_property -dict {PACKAGE_PIN M1 IOSTANDARD LVCMOS33} [get_ports {SLOTF_IO5}]   ;# bank 34 IO_L9N_T1_DQS_34
set_property src_info {type:XDC file:1 line:272 export:INPUT save:INPUT read:READ} [current_design]
set_property -dict {PACKAGE_PIN H2 IOSTANDARD LVCMOS33} [get_ports {SLOTF_IO6}]   ;# bank 34 IO_L10P_T1_34
set_property src_info {type:XDC file:1 line:273 export:INPUT save:INPUT read:READ} [current_design]
set_property -dict {PACKAGE_PIN H1 IOSTANDARD LVCMOS33} [get_ports {SLOTF_IO7}]   ;# bank 34 IO_L10N_T1_34
set_property src_info {type:XDC file:1 line:274 export:INPUT save:INPUT read:READ} [current_design]
set_property -dict {PACKAGE_PIN M2 IOSTANDARD LVCMOS33} [get_ports {SLOTF_IO8}]   ;# bank 34 IO_L11P_T1_SRCC_34
set_property src_info {type:XDC file:1 line:275 export:INPUT save:INPUT read:READ} [current_design]
set_property -dict {PACKAGE_PIN L2 IOSTANDARD LVCMOS33} [get_ports {SLOTF_IO9}]   ;# bank 34 IO_L11N_T1_SRCC_34
set_property src_info {type:XDC file:1 line:277 export:INPUT save:INPUT read:READ} [current_design]
set_property -dict {PACKAGE_PIN R3 IOSTANDARD LVCMOS33} [get_ports {SLOTG_IO0}]   ;# bank 34 IO_L13P_T2_MRCC_34
set_property src_info {type:XDC file:1 line:278 export:INPUT save:INPUT read:READ} [current_design]
set_property -dict {PACKAGE_PIN P3 IOSTANDARD LVCMOS33} [get_ports {SLOTG_IO1}]   ;# bank 34 IO_L13N_T2_MRCC_34
set_property src_info {type:XDC file:1 line:279 export:INPUT save:INPUT read:READ} [current_design]
set_property -dict {PACKAGE_PIN U2 IOSTANDARD LVCMOS33} [get_ports {SLOTG_IO10}]   ;# bank 34 IO_L18P_T2_34
set_property src_info {type:XDC file:1 line:280 export:INPUT save:INPUT read:READ} [current_design]
set_property -dict {PACKAGE_PIN U1 IOSTANDARD LVCMOS33} [get_ports {SLOTG_IO11}]   ;# bank 34 IO_L18N_T2_34
set_property src_info {type:XDC file:1 line:281 export:INPUT save:INPUT read:READ} [current_design]
set_property -dict {PACKAGE_PIN P4 IOSTANDARD LVCMOS33} [get_ports {SLOTG_IO2}]   ;# bank 34 IO_L14P_T2_SRCC_34
set_property src_info {type:XDC file:1 line:282 export:INPUT save:INPUT read:READ} [current_design]
set_property -dict {PACKAGE_PIN N4 IOSTANDARD LVCMOS33} [get_ports {SLOTG_IO3}]   ;# bank 34 IO_L14N_T2_SRCC_34
set_property src_info {type:XDC file:1 line:283 export:INPUT save:INPUT read:READ} [current_design]
set_property -dict {PACKAGE_PIN R1 IOSTANDARD LVCMOS33} [get_ports {SLOTG_IO4}]   ;# bank 34 IO_L15P_T2_DQS_34
set_property src_info {type:XDC file:1 line:284 export:INPUT save:INPUT read:READ} [current_design]
set_property -dict {PACKAGE_PIN P1 IOSTANDARD LVCMOS33} [get_ports {SLOTG_IO5}]   ;# bank 34 IO_L15N_T2_DQS_34
set_property src_info {type:XDC file:1 line:285 export:INPUT save:INPUT read:READ} [current_design]
set_property -dict {PACKAGE_PIN T4 IOSTANDARD LVCMOS33} [get_ports {SLOTG_IO6}]   ;# bank 34 IO_L16P_T2_34
set_property src_info {type:XDC file:1 line:286 export:INPUT save:INPUT read:READ} [current_design]
set_property -dict {PACKAGE_PIN T3 IOSTANDARD LVCMOS33} [get_ports {SLOTG_IO7}]   ;# bank 34 IO_L16N_T2_34
set_property src_info {type:XDC file:1 line:287 export:INPUT save:INPUT read:READ} [current_design]
set_property -dict {PACKAGE_PIN T2 IOSTANDARD LVCMOS33} [get_ports {SLOTG_IO8}]   ;# bank 34 IO_L17P_T2_34
set_property src_info {type:XDC file:1 line:288 export:INPUT save:INPUT read:READ} [current_design]
set_property -dict {PACKAGE_PIN R2 IOSTANDARD LVCMOS33} [get_ports {SLOTG_IO9}]   ;# bank 34 IO_L17N_T2_34
set_property src_info {type:XDC file:1 line:290 export:INPUT save:INPUT read:READ} [current_design]
set_property -dict {PACKAGE_PIN P6 IOSTANDARD LVCMOS33} [get_ports {SLOTH_IO0}]   ;# bank 34 IO_L19P_T3_34
set_property src_info {type:XDC file:1 line:291 export:INPUT save:INPUT read:READ} [current_design]
set_property -dict {PACKAGE_PIN P5 IOSTANDARD LVCMOS33} [get_ports {SLOTH_IO1}]   ;# bank 34 IO_L19N_T3_VREF_34
set_property src_info {type:XDC file:1 line:292 export:INPUT save:INPUT read:READ} [current_design]
set_property -dict {PACKAGE_PIN T8 IOSTANDARD LVCMOS33} [get_ports {SLOTH_IO10}]   ;# bank 34 IO_L24P_T3_34
set_property src_info {type:XDC file:1 line:293 export:INPUT save:INPUT read:READ} [current_design]
set_property -dict {PACKAGE_PIN T7 IOSTANDARD LVCMOS33} [get_ports {SLOTH_IO11}]   ;# bank 34 IO_L24N_T3_34
set_property src_info {type:XDC file:1 line:294 export:INPUT save:INPUT read:READ} [current_design]
set_property -dict {PACKAGE_PIN T5 IOSTANDARD LVCMOS33} [get_ports {SLOTH_IO2}]   ;# bank 34 IO_L20P_T3_34
set_property src_info {type:XDC file:1 line:295 export:INPUT save:INPUT read:READ} [current_design]
set_property -dict {PACKAGE_PIN R5 IOSTANDARD LVCMOS33} [get_ports {SLOTH_IO3}]   ;# bank 34 IO_L20N_T3_34
set_property src_info {type:XDC file:1 line:296 export:INPUT save:INPUT read:READ} [current_design]
set_property -dict {PACKAGE_PIN U6 IOSTANDARD LVCMOS33} [get_ports {SLOTH_IO4}]   ;# bank 34 IO_L21P_T3_DQS_34
set_property src_info {type:XDC file:1 line:297 export:INPUT save:INPUT read:READ} [current_design]
set_property -dict {PACKAGE_PIN U5 IOSTANDARD LVCMOS33} [get_ports {SLOTH_IO5}]   ;# bank 34 IO_L21N_T3_DQS_34
set_property src_info {type:XDC file:1 line:298 export:INPUT save:INPUT read:READ} [current_design]
set_property -dict {PACKAGE_PIN R8 IOSTANDARD LVCMOS33} [get_ports {SLOTH_IO6}]   ;# bank 34 IO_L22P_T3_34
set_property src_info {type:XDC file:1 line:299 export:INPUT save:INPUT read:READ} [current_design]
set_property -dict {PACKAGE_PIN P8 IOSTANDARD LVCMOS33} [get_ports {SLOTH_IO7}]   ;# bank 34 IO_L22N_T3_34
set_property src_info {type:XDC file:1 line:300 export:INPUT save:INPUT read:READ} [current_design]
set_property -dict {PACKAGE_PIN R7 IOSTANDARD LVCMOS33} [get_ports {SLOTH_IO8}]   ;# bank 34 IO_L23P_T3_34
set_property src_info {type:XDC file:1 line:301 export:INPUT save:INPUT read:READ} [current_design]
set_property -dict {PACKAGE_PIN R6 IOSTANDARD LVCMOS33} [get_ports {SLOTH_IO9}]   ;# bank 34 IO_L23N_T3_34
set_property src_info {type:XDC file:1 line:303 export:INPUT save:INPUT read:READ} [current_design]
set_property -dict {PACKAGE_PIN M21 IOSTANDARD LVCMOS33} [get_ports {SYS_CLK}]   ;# bank 14 IO_L12P_T1_MRCC_14
