bcarbone24/freyja/tools/qualified.py

#!/usr/bin/env python3
"""Qualified parts: the exact thing that gets soldered, and where the numbers
came from.

`ki_fp_filters` catches a footprint that disagrees with its symbol, which is
useful but weak: a filter can be absent, broad, or simply wrong, and it says
nothing about whether the part can survive the voltage on the net it is
soldered to. This file is the stronger statement -- manufacturer part number,
manufacturer package code, the footprint fitted, the ratings that matter on
*this* board, and how the pinout was confirmed.

`design.py` refuses to build if a non-generic part has no entry here, or if the
entry's footprint is not the one fitted. So a new IC cannot enter the netlist
without someone writing down what it is.

    python3 tools/qualified.py           # print the table
    python3 tools/qualified.py --write   # regenerate ref/qualified-parts.md

Lookup is by designator first, then by symbol, so parts sharing a symbol can
still carry different requirements.
"""
import sys

FP = {  # shorthand, matching design.py
    'SOT23':   'Package_TO_SOT_SMD:SOT-23',
    'SOT563':  'EasyEDA:SOT-563_L1.6-W1.2-P0.50-LS1.6-BL',
    'TSSOP8':  'EasyEDA:TSSOP-8_L4.4-W3.0-P0.65-LS6.4-BL',
    'VQFN10RPU': 'Package_DFN_QFN:Texas_RPU0010A_VQFN-HR-10_2x2mm_P0.5mm',
}

# key -> (mpn, manufacturer package, footprint, ratings that matter here,
#         how the pin map was confirmed, source of the numbers)
PARTS = {
  # ---------------------------------------------------------------- the FPGA
  'odin:XC7A100T-2FGG676I': dict(
    mpn='XC7A100T-2FGG676I', pkg='FGG676, 27x27 mm BGA, 1.0 mm pitch',
    fp='EasyEDA:FBGA-676_L27.0-W27.0-R26-C26-P1.00-BL',
    rating='VCCINT 1.0 V, VCCAUX 1.8 V, VCCO 1.8/2.5/3.3 V per HR bank',
    pinmap='all 676 balls from imported EasyEDA/LCSC C1521803 symbol; '
           'functional allocation generated by tools/alloc.py',
    src='LCSC C1521803 and AMD Artix-7 documentation'),
  # ------------------------------------------------------------- supervisor
  'MCU_RaspberryPi:RP2350B': dict(
    mpn='RP2350B', pkg='QFN-80, 10x10 mm, 0.4 mm pitch, 3.4x3.4 mm pad',
    fp='EasyEDA:QFN-80_L10.0-W10.0-P0.40-TL-EP3.4',
    rating='IOVDD 3.3 V, DVDD 1.1 V from the on-chip switcher (200 mA), '
           'ADC input 0..ADC_AVDD',
    pinmap='KiCad MCU_RaspberryPi symbol, pins resolved by name',
    src='RP2350 datasheet; RP-008280 hardware design guide'),
  'Device:Crystal_GND24': dict(
    mpn='ABM8-272-T3', pkg='3.2x2.5 mm, 4 pad',
    fp='EasyEDA:CRYSTAL-SMD_4P-L3.2-W2.5-BL',
    rating='12 MHz, +/-30 ppm, CL 10 pF, ESR 50 ohm max',
    pinmap='2-pad crystal with grounded shield; G ties both shield pads',
    src='RP-008280 s4.1 names this exact part and the 1k damping resistor'),
  'Memory_Flash:W25Q32JVZP': dict(
    mpn='W25Q32JVZPIQ', pkg='WSON-8, 6x5 mm, 1.27 mm pitch',
    fp='EasyEDA:WSON-8_L6.0-W5.0-P1.27-BL-EP',
    rating='2.7-3.6 V, 32 Mbit',
    pinmap='KiCad symbol checked against imported C571260 pads; standard QSPI NOR',
    src='Winbond W25Q32JV datasheet; LCSC C571260'),
  'odin:W25Q256JVEIQ': dict(
    mpn='W25Q256JVEIQ', pkg='WSON-8, 8x6 mm, 1.27 mm pitch',
    fp='EasyEDA:WSON-8_L8.0-W6.10-P1.27-BL-EP',
    rating='2.7-3.6 V, 256 Mbit, 25 mA program peak',
    pinmap='generated from the standard 8-pin QSPI NOR pinout, '
           'tools/gen_kicad.py FLASH_PINS',
    src='Winbond W25Q256JV datasheet; LCSC C97522'),
  'EasyEDA:TF-01A_C91145': dict(
    mpn='TF-01A', pkg='SMD push-push microSD socket, 1.85 mm, two 1.0 mm locating pegs',
    fp='EasyEDA:TF-SMD_TF-01A-NPTH',
    rating='1 A, 30 V contact rating; card supply 3.3 V; SPI mode wiring',
    pinmap='imported C91145 symbol: pins 1-8 the microSD contacts in card order, '
           '9 the detect switch, 10-13 the shell; drawing is mechanical only',
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
