bcarbone24/freyja/(commit log)

2026-10-30 checking flow of branches
2026-11-05 Claudes changes for regeneration files and verification
    [fpga.kicad_sch, memory.kicad_sch, network.kicad_sch, odin.kicad_pcb, power.kicad_sch, slots.kicad_sch, supervisor.kicad_sch, video.kicad_sch]
